elegooofficial/neptune3pro/PCBA/Limit Switch/X-axis limit Switch pcba.pdf

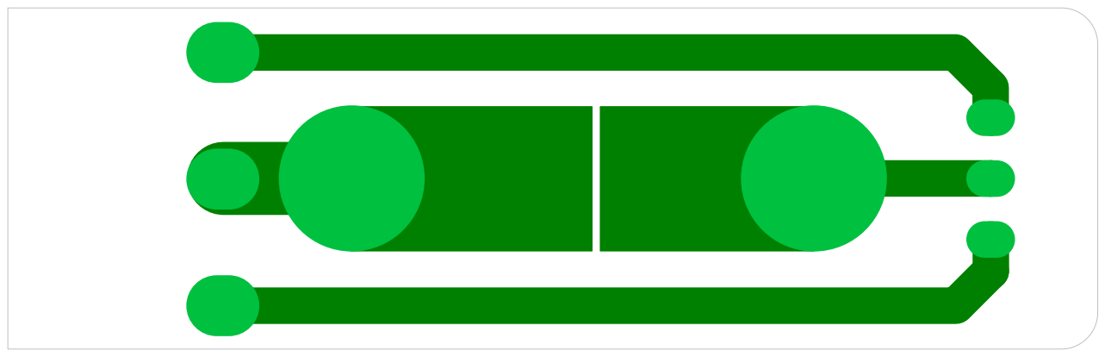
[picture p1: figure]
J1 @01@⁰¹x1 J1x1 J1x2 J1x3; @03@⁰³x1

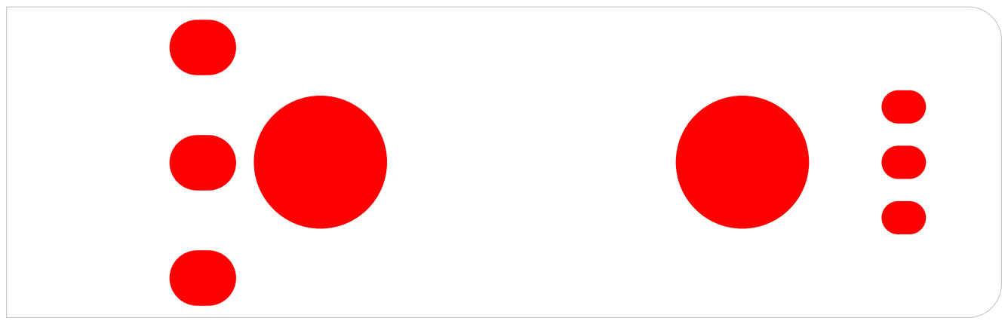
[picture p2: figure]
J1 @01@⁰¹x1 J1x1 J1x2 J1x3; @03@⁰³x1

J2

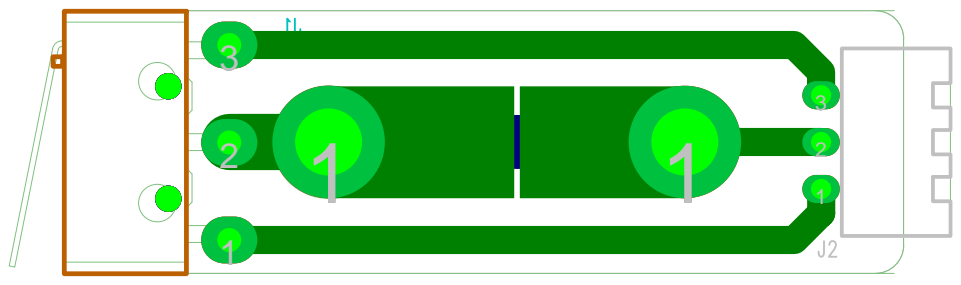
[picture p3: page 5]
J2 J1 @01@⁰¹x1 J1x1 J1x2 J1x3 J1x4 J1x5; @03@⁰³x1; J1 @01@⁰¹x1 J1x1 J1x2 J1x3 J1x4 J1x5
