elegooofficial/neptune3pro/BOM/Neptune 3 Pro bom.xlsx

Neptune 3 Pro Bom
Items | Part Code | Part Name | Specification | UNIT | Qty
1 | 01.001.0012 | 2020 Aluminum profile_X-axis | 20*20-L358mm,anodizing | pcs | 1
2 | 01.005.0001 | 2056 Aluminum profile_Y-axis | 20*56-L347mm,anodizing | pcs | 1
3 | 01.002.0006 | 2040 Aluminum profile_Right | 20*40-L430mm,anodizing+silk screen printing | pcs | 1
4 | 01.002.0007 | 2040 Aluminum profile_Left | 20*40-L430mm,Anodizing+silk screen printing | pcs | 1
5 | 01.003.0008 | 4040 Aluminum profile_Bottom & Right | 40*40-L320mm,Anodizing | pcs | 1
6 | 01.003.0009 | 4040 Aluminum profile_Bottom & Left | 40*40-L320mm,Anodizing | pcs | 1
7 | 01.003.0010 | 4040 Aluminum profile_Bottom | 40*40-L257mm,Anodizing | pcs | 1
8 | 02.002.0029 | Cover Plate_Bottom | 0.6mm, SPCC,Spraying,Black | pcs | 1
9 | 02.002.0030 | Attraction Plate_Magnet | 1.5mm,SECC | pcs | 1
10 | 02.002.0031 | Power Supply Cover_Left | 0.8mm,SPCC,Spraying,Black | pcs | 1
11 | 02.002.0032 | Power Supply Cover-Bottom | 0.8mm,SPCC,Spraying,Black | pcs | 1
12 | 02.002.0033 | Fixing Plate_Y-axis stepper | 2.5mm,SPCC,Spraying,Black | pcs | 1
13 | 02.002.0034 | Bottom Slider Plate | 4.0mm,Aluminum alloy plate,Spraying,Black | pcs | 1
14 | 02.002.0035 | Fixing Plate_Z nut-Left | 2.5mm,SPCC,Spraying,Black | pcs | 1
15 | 02.002.0036 | Fixing Plate_X-axis-stepper | 2.5mm,SPCC,Spraying,Black | pcs | 1
16 | 02.002.0037 | Fixing Plate_Z nut-Right | 2.5mm,SPCC,Spraying,Black | pcs | 1
17 | 02.002.0038 | Driven Plate_Z-axis | 2.5mm,SPCC,Spraying,Black | pcs | 1
18 | 02.002.0039 | Fixing Plate_Extruder | 2.5mm,SPCC,Spraying,Black | pcs | 1
19 | 02.002.0040 | Fixing Plate_Extruder Fan | 1.0mm,SPCC,Spraying,Black | pcs | 1
20 | 02.002.0041 | Fixing Plate_Top Bearing | 3.0mm,SPCC,Spraying,Black | pcs | 2
21 | 02.002.0042 | Fixing Plate_Filament Detector Switch | 0.8mm,SPCC,Spraying,Black | pcs | 1
22 | 02.002.0043 | Fixing Plate_Magnet | 0.8mm,SPCC,Spraying,Black | pcs | 1
23 | 02.002.0044 | Fixing Plate_Extruder Cable | 1.0mm,SPCC,Spraying,Black | pcs | 1
24 | 02.002.0045 | Power Supply Cover_Right | 0.8mm,SPCC,Spraying,Black | pcs | 1
25 | 04.001.0003 | Red Silicone Wire(Switch) | 16AWG_L90mm_4.8 Plug spring terminal | pcs | 1
26 | 04.001.0013 | Ground Wire_Power Supply | 18AWG_L90mm_SV1.25-4 terminal+4.8 Plug spring terminal | pcs | 1
27 | 04.001.0014 | Black Silicone Wire | 16AWG Silicone Wire_L90mm_SV1.25-4 terminal+4.8 Plug spring terminal,Black | pcs | 1
28 | 04.001.0015 | Red Silicone Wire | 16AWG Silicone Wire_L90mm_SV1.25-4 terminal+4.8 Plug spring terminal,Red | pcs | 1
29 | 04.002.0004 | Heated Bed Wire | 2*1.5㎡_2pin_L700mm,Red&Black | pcs | 1
30 | 04.003.0004 | Mainboard Wire | 16AWG_2Pin_L380mm_SV1.25-4 terminal+E1508 terminal,Red&Black | pcs | 1
31 | 04.005.0016 | Stepper and limit switch wire_Y-axis | 24AWG_6Pin,L1=650mm,L2=750mm,Black | pcs | 1
32 | 04.005.0017 | Stepper wire_Z-axis | 24AWG_2*4Pin,L1=430mm,L2=330mm,Black | pcs | 1
33 | 04.005.0018 | Stepper and limit switch wire_X-axis | 24AWG_6Pin,L1=960mm,L2=1020mm,Black | pcs | 1
34 | 04.001.0016 | Red DC Wire | 18AWG_L150mm_SV1.25-4 terminal,Red | pcs | 1
35 | 04.001.0017 | Black DC Wire | 18AWG_L150mm_SV1.25-4 terminal,Black | pcs | 1
36 | 04.014.0001 | Extruder Cable | 26AWG_20Pin,L=1430mm,Red&Black | pcs | 1
37 | 04.011.0009 | Fan Wire | 26AWG_2*2Pin terminal,L=60mm,Red&Black | pcs | 1
38 | 04.011.0010 | Filament Detector Wire | 26AWG_3Pin,L=550mm,Black | pcs | 1
39 | 04.011.0011 | LED Wire | 26AWG_2Pin,L=360mm,Black&Grey | pcs | 1
40 | 04.006.0007 | Filament Detector and LED Wire | UL1007 26AWG_5Pin，L1=620mm,L2=520mm,Black | pcs | 1
41 | 05.001.0066 | Plastic Bottom Box | Grey,ABS757，Fireproof materials_Fire rating V-0 | pcs | 1
42 | 05.001.0067 | Plastic Bottom Cover_Front | Grey,ABS757，Fireproof materials_Fire rating V-0 | pcs | 1
43 | 05.001.0068 | Display screen Shell_Top | Grey,ABS757 | pcs | 1
44 | 05.001.0069 | Display screen Shell_Bottom | Grey,ABS757 | pcs | 1
45 | 05.001.0070 | Display screen holder | Grey,ABS757 | pcs | 1
46 | 05.001.0071 | Stepper holder_Z-axis | Grey,ABS757 | pcs | 2
47 | 05.001.0072 | Limit switch pad_Y-axis | Grey,ABS757 | pcs | 1
48 | 05.001.0073 | Belt Adjust Shell_Y-axis | Grey,ABS757 | pcs | 1
49 | 05.001.0074 | limit switch holder_X-axis | Grey,ABS757 | pcs | 1
50 | 05.001.0075 | Belt Adjust Shell_X-axis | Grey,ABS757 | pcs | 1
51 | 05.001.0076 | Extruder Shell | Grey,PC,Fireproof materials_Fire rating V-0 | pcs | 1
52 | 05.001.0077 | Fan holder_Extruder | Grey,PC,Fireproof materials_Fire rating V-0 | pcs | 1
53 | 05.001.0078 | Extruder Handle | Grey,PC,Fireproof materials_Fire rating V-0 | pcs | 1
54 | 05.001.0080 | Gearbox_Bottom | Grey,PC,Fireproof materials_Fire rating V-0 | pcs | 1
55 | 05.001.0081 | Gearbox_Top | Grey,PC,Fireproof materials_Fire rating V-0 | pcs | 1
56 | 05.001.0082 | Cable Snap | Grey,ABS757 | pcs | 1
57 | 05.001.0083 | Beam_Top | Grey,ABS757 | pcs | 1
58 | 05.001.0084 | Filament holder | Grey,ABS757 | pcs | 1
59 | 05.001.0085 | Filament Detector Shell_Top | Grey,ABS757 | pcs | 1
60 | 05.001.0086 | Filament Detector Shell_Bottom | Grey,ABS757 | pcs | 1
61 | 05.001.0087 | Bearing holder_Filament Detector | Grey,ABS757 | pcs | 1
62 | 03.001.0005 | Decelerate Gear | Black POM+45# steel | pcs | 1
63 | 05.001.0088 | Heated Bed Wire holder | Grey,PC,Fireproof materials_Fire rating V-0 | pcs | 1
64 | 05.001.0089 | Filament Detector holder | Grey,ABS757 | pcs | 1
65 | 05.001.0090 | Belt Adjust Bearing holder | Grey,ABS757 | pcs | 2
66 | 05.001.0091 | Belt Adjust nut-D20 | Grey,ABS757 | pcs | 2
67 | 05.001.0092 | Filament Tube | Grey,ABS757 | pcs | 1
68 | 05.001.0093 | Cover_4040 Aluminum profile | Grey,ABS757 | pcs | 2
69 | 05.001.0020 | Silicone Cover_Heating Block | Silicone,Black | pcs | 1
70 | 08.001.0016 | Mainboard | ZNP Robin Nano_DW V2.2 | PCS | 1
71 | 19.005.0009 | Mainboard | ZNP Robin Nano_DW V2.2（IC: STM32F401RCT6） | SET | 1
72 | 19.005.0010 | Mainboard | ZNP Robin Nano_DW V2.2（IC: STM32F401RRT6） | SET | 1
73 | 19.005.0011 | Mainboard | ZNP Robin Nano_DW V2.2（IC: STM32F402RCT6） | SET | 1
74 | 08.002.0006 | Display Screen | 4.3inch Capacitive touch Display screen | pcs | 1
75 | 04.011.0012 | RJ11 Wire | RJ11 Spring Wire,1.5m,Single core:7x0.08,Black | pcs | 1
76 | 04.011.0013 | Display Screen Wire_Inside | RJ11,4P4C,4Pin XH2.54 Plug | pcs | 1
77 | 07.003.0004 | limit switch _X-axis | limit switch,14x45x1.6mm,Red | SET | 1
78 | 07.003.0017 | DC Socket | DC022B，φ5.5*φ2.5mm | pcs | 1
79 | 07.003.0021 | limit switch _Y-axis | limit switch,20x20x1.6mm,Red | pcs | 1
80 | 08.006.0003 | Filament Detector Sensor | H22B1 PCBA module | pcs | 1
81 | 08.001.0017 | Extruder PCBA | EL-A-V2.1.1.400,42x41x1.6mm Fiber glass board,Red | PCS | 1
82 | 07.002.0004 | Stepper_X-axis&Y-axis | Model:42HD2037-02,Two-phase,34mm,Black | PCS | 2
83 | 07.002.0005 | Stepper_Z-axis | Model:42HD2037-04,Two-phase,34mm,Black | PCS | 2
84 | 07.002.0008 | Stepper_Extruder | Model:42HD1418-01,Two-phase,25mm | PCS | 1
85 | 07.001.0001 | Power Supply | 360W,24V 15A H:50mm,Black | PCS | 1
86 | 07.003.0019 | Combination Switch | Three-in-one combination switch | pcs | 1
87 | 08.003.0001 | Power Fuse | 10A 250V 5*20 | pcs | 1
88 | 07.004.0001 | Heated Bed Platform | 24V，235*235mm，250W | pcs | 1
89 | 07.007.0004 | Heating Tube | 24V，40W,Φ6*20,L70mm 2Pin XH2.54 Plug | pcs | 1
90 | 07.005.0009 | 6010 Fan | 6010 Fan,24V,3000r/min | pcs | 1
91 | 07.005.0010 | 4010 Turbo Fan | 4010 Turbo Fan,24V,7000r/min | pcs | 2
92 | 07.005.0011 | 4015 Turbo Fan | 4015 Turbo Fan,24V,7000r/min | pcs | 1
93 | 07.003.0020 | Level Sensor | Model:NPN N3F-H4NB Inductive proximity Sensor | pcs | 1
94 | 07.006.0007 | Thermistor_Nozzle | NTC100K D1.8-L100mm,2Pin XH2.0 terminal | pcs | 1
95 | 07.006.0008 | Thermistor_Heated Bed | NTC100K D1.8-L1100mm,2Pin XH2.54 terminal | pcs | 1
96 | 06.009.0026 | LED PCBA | AL base board,15*178mm,24V 0.5W,1.6MM | pcs | 1
97 | 03.002.0002 | Heated Blcok | AL6061,20*20*10mm， | pcs | 1
98 | 03.003.0005 | Heat Dissipation Block | AL6061,42*20.5*20.5mm | pcs | 1
99 | 03.004.0001 | Nozzle | Brass M6，0.4mm | pcs | 3
100 | 03.005.0003 | Throat Tube | Ti alloy,CT4，D7-M6-L27mm | pcs | 1
101 | 20.001.0001 | V-slot Wheel kit | 1*Black POM Wheel+2*625ZZBearing+1*M5 Flat Washer_V-slot Wheel | pcs | 14
102 | 03.006.0001 | Metal Eccentric Spacer | D7.2-d5-H-8.35mm,Hexagon | pcs | 6
103 | 03.006.0002 | Metal Spacer | D8-d5-H-8.35mm,Circular | pcs | 14
104 | 03.001.0002 | Extrusion Gear 1 | SUS304,0.5M,17T,13.8*9.3mm,M3 threaded hole | pcs | 1
105 | 03.001.0003 | Extrusion Gear 2 | SUS304,0.5M,17T,13.8*9.3mm | pcs | 1
106 | 03.001.0004 | Extruder Stepper Gear | Brass,0.5M,17T,H4.5mm | pcs | 1
107 | 06.008.0001 | Axis_Detector Bearing_L10 | SUS304,φ3,L10mm | pcs | 1
108 | 06.008.0002 | Axis_Extrusion Gear_L19 | SUS304,φ3,L19mm | pcs | 1
109 | 06.008.0003 | Axis_Extrusion Gear holder_L27 | SUS304,φ3,L27mm | pcs | 1
110 | 06.004.0010 | Spring_Extrusion | φ1.0mm*φ8mm*L20mm | pcs | 1
111 | 06.004.0009 | Spring_Filament Detector | φ0.4mm*φ6mm*L15mm | pcs | 1
112 | 06.001.0009 | MR85zz Bearing | MR85zz | pcs | 2
113 | 06.001.0004 | Needle Bearing | OD:5.0mm,ID:3,0mm,H:7mm SUS Needle | pcs | 2
114 | 06.001.0010 | MF148zz Flange Bearing | MF148zz | pcs | 2
115 | 06.001.0002 | F624zz Bearing | F624zz | pcs | 4
116 | 06.001.0007 | 624zz V Bearing | 624 V | pcs | 1
117 | 06.001.0011 | MR93ZZ Bearing | MR93ZZ | pcs | 1
118 | 06.003.0007 | Lead screws_T8 | T8-8_L394mm | pcs | 2
119 | 06.003.0002 | Lead screws nut_T8 | T8-8 | pcs | 2
120 | 06.007.0001 | Rigid Coupling | D5mm*8mm | pcs | 2
121 | 06.006.0001 | Timing Pulley_ID 5 | 2GT_d5mm_20teeth_W6mm,Black | pcs | 2
122 | 06.006.0002 | Timing Pulley_ID 8 | 2GT_d8mm_20teeth_W6mm,Black | pcs | 2
123 | 05.002.0001 | 2GT Timing Belt_Open | 2GT-W6 X-axis-L790mm,Y-axis-L750mm,Black,100m/roll | m | 1.528
124 | 05.002.0003 | 2GT Timing Belt_Close | 2GT-W6 PL634mm | pcs | 1
125 | 06.009.0002 | Copper Sleeve_Timing Belt | D7mm_0.5mm | pcs | 4
126 | 03.006.0005 | Heated Bed Spacer | Material:SUS304,OD:7.0mm,ID:6.0mm,H:13.5mm | pcs | 4
127 | 10.008.0003 | PEI Platform Sticker | PEIspray,235mm*245mm | pcs | 1
128 | 10.008.0013 | Soft Magnetic Platform | 235mm*235mm*1.5mm,Adhesive backing,Black | pcs | 1
129 | 06.009.0027 | Display Screen Magnet | NdFeB strong magnet,50*30*4mm,2000GS | pcs | 1
130 | 11.008.0003 | PET Plastic Sheet | Material:PET,37.5*64mm,Thickness:0.2mm,Adhesive backing,Black | pcs | 1
131 | 10.005.0004 | Rubber Mat | Material:rubber,38*20*20mm,Black | pcs | 4
132 | 05.007.0006 | PTFE Tube | Material:PTFE,OD4.0mm,ID2.0mm,L54mm,Light blue | m | 0.108
133 | 10.008.0015 | Fixing Clamp_Extruder Cable | Model:UC-2,ID:10.4mm,Black | pcs | 1
134 | 05.008.0001 | Cable Tie holder | Model:STM-1S,Black,W6.9-L12.6mm | pcs | 1
135 | 05.001.0094 | Wire Protective Ring | Model:SB20,Protective Ring,Black | pcs | 1
136 | 11.008.0004 | Cover Strip_Aluminum profile | W6-L360mm,Black | pcs | 1
137 | 10.001.0001 | Nylon braided sleeve_W8 | W8-L410mm | pcs | 1
138 | 10.001.0012 | Nylon braided sleeve_W16 | W16-L600mm | pcs | 2
139 | 11.003.0001 | Insulation Cotton | Insulation Cotton,50*60mm | pcs | 1
140 | 10.007.0004 | Cable Tie 4-150 | Nylon,Black_4-150mm | pcs | 9
141 | 10.007.0002 | Fixed Head Cable Tie 3-100 | Nylon,Black_3-100mm | pcs | 5
142 | 11.002.0002 | High Temperature Tape | W50mm，33m | m | 0.14
143 | 11.001.0001 | High Temp Resistant Thread Sealant | High Temp Resistant Thread Sealant | g | 0.5
144 | 11.004.0001 | Grease | Transparent_Paste | g | 2
145 | 11.004.0002 | Thermal Grease | Grey | g | 0.2
146 | 11.006.0001 | Solder Wire | φ2mm ,500g/roll,lead free | g | 0.5
147 | 11.002.0005 | Acetate Cloth Tape | W40mm，30m,Black,Acetate Cloth Tape | m | 0.2
148 | 11.002.0004 | Packing Tape | W50mm，100m | m | 0.5
149 | 11.009.0001 | Heat Shrinkable Tube | φ2.5mm*20mm，ID:3.0mm，Black | pcs | 2
150 | 11.007.0001 | Hot-melt |  | pcs | 0.05
151 | 11.008.0007 | Electronic glue | Model:FST5980 RTV silica gel,Black,100ml/piece | ml | 1
152 | 11.001.0002 | 480 Quick-drying Adhesive | Model:480,Quick-drying Adhesive,Black,20g/piece | g | 0.4
153 | 10.004.0001 | TF Memory Card | 8G | pcs | 1
154 | 10.004.0002 | TF Memory Card Reader | CHUANYU（Common） | pcs | 1
155 | 04.008.0001 | Power Supply Wire | Length:1.5M_Wire diameter:6.5mm_Rated power:2500W_Rated voltage:250V_Pure copper_3*0.75mm²_Plug:nickel-plated brass_Flame-Retardant PVC | pcs | 1
156 | 04.009.0001 | USB Cable | Bluish transparent_Type-A to Type-B_Length:53cm_Wire diameter:4.8mm | pcs | 1
157 | 10.008.0012 | Needle | Stainless Steel_L70mm_d0.35mm | pcs | 1
158 | 10.002.0015 | Plastic Scraper | Material:PP,Plastic Scraper,yellow | pcs | 1
159 | 10.002.0002 | Nippers | Cutting Nippers | pcs | 1
160 | 10.002.0003 | 1.5mm Inner Hexagon Spanner | Carbon Steel_1.5mm_Nickel-plated | pcs | 1
161 | 10.002.0004 | 2.0mm Inner Hexagon Spanner | Carbon Steel_2.0mm_Nickel-plated | pcs | 1
162 | 10.002.0005 | 2.5mm Inner Hexagon Spanner | Carbon Steel_2.5mm_Nickel-plated | pcs | 1
163 | 10.002.0006 | 3.0mm Inner Hexagon Spanner | Carbon Steel_3.0mm_Nickel-plated | pcs | 1
164 | 10.002.0007 | 4.0mm Inner Hexagon Spanner | Carbon Steel_4.0mm_Nickel-plated | pcs | 1
165 | 10.002.0008 | Flat Blade screwdriver | 2.5mm_Flat Blade | pcs | 1
166 | 10.002.0009 | Cruciform screwdriver | 4.0mm_ Cruciform | pcs | 1
167 | 10.002.0010 | Double Open Spanner | 45#steel_8-10#_Galvanized | pcs | 1
168 | 10.002.0011 | Open Spanner | 45#steel_6#_Galvanized | pcs | 1
169 | 12.002.0001 | Self Sealing Bag Ⅰ | 18cm*26cm_Thickness:0.06mm | pcs | 1
170 | 12.002.0003 | Self Sealing Bag Ⅱ | 9cm*13cm_Thickness:0.08mm | pcs | 3
171 | 12.002.0004 | Self Sealing Bag Ⅲ | 6cm*9cm_Thickness:0.08mm | pcs | 4
172 | 13.001.0001 | Filament | L5m_Random color | pcs | 1
173 | 10.003.0001 | Product Certificate | Triangle | pcs | 1
174 | 12.003.0024 | Neptune 3 Pro Foam |  | pcs | 1
175 | 12.001.0025 | Neptune 3 Pro Carton |  | pcs | 1
176 | 10.003.0018 | Neptune 3 Pro Manufacturing Number Sticker | 210*120mm | pcs | 1
177 | 12.004.0015 | Neptune 3 Pro Machine Specification Sticker | 70*38mm | pcs | 1
178 | 10.007.0003 | Plastic Twist Tie | White_Plastic Twist Tie_0.55mm*80mm | pcs | 1
179 | 10.003.0019 | Neptune 3 Pro User Guide | 128G_Coated Paper,4color printing | pcs | 1
180 | 12.005.0016 | Display Screen Warning label | 49*26mm,80G_Coated Paper | pcs | 1
181 | 12.005.0018 | Stepper Warning label | 14*13mm,Triangle,80G_Coated Paper | pcs | 2
182 | 12.005.0019 | DC Socket label | 30*8mm | pcs | 1
183 | 11.001.0004 | Solid gule-PVP | Material:PVP, high viscosity, formaldehyde free, 20g/piece | pcs | 1
184 | 09.009.0005 | Cruciform Socket Button Head screw_PWM M2*10 | Carbon Steel_PWM M2x10 | pcs | 3
185 | 09.003.0017 | Hexagon Socket Head Cap screw_ M2*10 | Stainless Steel_M2*10 | pcs | 2
186 | 09.006.0011 | Cruciform Socket Button Head Tapping screws_Point Tail/PA 2x6 | Carbon Steel/PA 2*6 | pcs | 6
187 | 09.006.0003 | Cruciform Socket Button Head Tapping screws_Point Tail_PA3x8 | Carbon Steel/PA 3*8 | pcs | 21
188 | 09.006.0002 | Cruciform Socket Button Head Tapping screws_Point Tail/PA 3*12 | Stainless Steel/PA 3*12 | pcs | 3
189 | 09.006.0012 | Cruciform Socket Button Head Tapping screws_Flat tail/KT 5x10 | Carbon Steel/KT 5*10 | pcs | 4
190 | 09.007.0001 | Combination screw_M3x4 | Stainless Steel_M3X4 | pcs | 1
191 | 09.002.0016 | Hexagon Socket Button Head screw_M3x4 | Stainless Steel_M3*4 | pcs | 6
192 | 09.002.0001 | Hexagon Socket Button Head screw_M3x6 | Stainless Steel_M3*6 | pcs | 18
193 | 09.002.0012 | Hexagon Socket Button Head screw_M3x8 | Stainless Steel_M3*8 | pcs | 3
194 | 09.002.0004 | Hexagon Socket Button Head screw_M3x10 | Stainless Steel_M3*10 | pcs | 2
195 | 09.002.0009 | Hexagon Socket Button Head screw_M3x12 | Stainless Steel_M3*12 | pcs | 14
196 | 09.002.0002 | Hexagon Socket Button Head screw_M3x16 | Stainless Steel_M3*16 | pcs | 6
197 | 09.003.0013 | Hexagon Socket Head Cap screw_M3x20 | Stainless Steel_M3*20 | pcs | 2
198 | 09.002.0022 | Hexagon Socket Button Head screw_M3x30 | Stainless Steel_M3*30 | pcs | 1
199 | 09.002.0014 | Hexagon Socket Button Head screw_M4x5 | Stainless Steel_M4*5 | pcs | 5
200 | 09.002.0018 | Hexagon Socket Button Head screw_M4x8 | Stainless Steel_M4*8 | pcs | 1
201 | 09.002.0007 | Hexagon Socket Button Head screw_M4x16 | Stainless Steel_M4*16 | pcs | 6
202 | 09.007.0002 | Hexagon Socket Button Head screw_M4x18 | Carbon Steel_M4X18 | pcs | 4
203 | 09.002.0020 | Hexagon Socket Button Head screw_M4x20 | Stainless Steel_M4*20 | pcs | 5
204 | 09.002.0021 | Hexagon Socket Button Head screw_M5X10 | Stainless Steel_M5X10 | pcs | 6
205 | 09.002.0003 | Hexagon Socket Button Head screw_M5X30 | Stainless Steel_M5X30 | pcs | 8
206 | 09.002.0005 | Hexagon Socket Button Head screw_M5X40 | Stainless Steel_M5X40 | pcs | 6
207 | 09.002.0023 | Hexagon Socket Button Head Combination screw_M4x20 | Stainless Steel_M4*20 | pcs | 8
208 | 09.007.0007 | Hexagon Socket Head Cap screw_M4x40 | Carbon Steel_M4*40 | pcs | 2
209 | 09.007.0004 | Hexagon Socket Head Cap screw_M5X45 | Carbon Steel_M5X45 | pcs | 12
210 | 09.007.0006 | Hexagon Socket Head Cap screw_M5X50 | Carbon Steel_M5X50 | pcs | 2
211 | 09.003.0016 | Hexagon Socket Head Cap screw Step screw_4x3xM3 | Stainless Steel_4*3*M3 | pcs | 1
212 | 09.001.0011 | Hexagon Socket Countersunk Head screw_M3x6 | Stainless Steel_M3*6 | pcs | 7
213 | 09.001.0002 | Hexagon Socket Countersunk Head screw_M3x10 | Stainless Steel_M3*10 | pcs | 1
214 | 09.001.0014 | Hexagon Socket Countersunk Head screw_M3x35 | Stainless Steel_M3*35 | pcs | 3
215 | 09.001.0015 | Hexagon Socket Countersunk Head screw_M4x20 | Stainless Steel_M4*20 | pcs | 8
216 | 09.003.0015 | Hexagon Socket Head Cap screw_Thin head_M4x12 | Stainless Steel_M4*12 | pcs | 1
217 | 09.011.0008 | Hexagon Socket Button Head screw_Thin head_M5x30 | Stainless Steel_M5*30 | pcs | 4
218 | 09.008.0001 | Set screw_M3x3 | Carbon Steel_M3*3 | pcs | 2
219 | 09.004.0002 | Spring Washer_M3 | Stainless Steel_M3 | pcs | 4
220 | 09.004.0003 | Flat Washer_M5 | Stainless Steel_M5 | pcs | 6
221 | 09.008.0008 | Butt nut_M4x16 | Stainless Steel_M4*16 | pcs | 2
222 | 09.008.0010 | Butt screw_M4 | Stainless Steel_M4 | pcs | 2
223 | 09.005.0012 | Self-locking nut_M3 | Stainless Steel_M3 | pcs | 4
224 | 09.005.0013 | Square nut_M4 | Carbon Steel_M4 | pcs | 1
225 | 09.005.0002 | Self-locking nut_M5 | Stainless Steel_M5 | pcs | 14
