elegooofficial/neptune3pro/PCBA/Extruder PCBA/Extruder bom.xls

Itens | Part name | Packag description | Qty | Bit number
1 | Connector | PH2.0X4-PW，90 degree connector，Fireproof material | 1 | E1
2 | Connector | PH2.0-PW，90 degree connector，Fireproof material | 5 | FAN1 K-FAN1 K-FAN2 LED TH1
3 | Connector | XH-2.54W_2PW，90 degree connector，Fireproof material | 1 | HEAT0
4 | Connector | CON2.0X2X10W Sagittarius，90 degree connector，Fireproof material | 1 | J2
5 | Connector | PH2.0X3-PW，90 degree connector，Fireproof material | 1 | LIMIT1
6 | SMD resistor | 0603_100R_accuracy 1% | 2 | R1 R3
7 | pcb | 42*41mm，FR-4，two-layer board，FR4_1.6mm，red Soldermask and white silkscreen ， HAL lead free technology ，Through hole and oil，Thickness of copper sheet:1oz，version：EL-A-V2.1.1.400 | 1
