elegooofficial/neptune3pro/(list of files, cad)

Other CAD files:
Wire/Mainboard Wire.dwg
2D/4040 Aluminum profile_Bottom.DWG
Wire/stepper and limit switch wire_Y-axis.dwg
2D/Bottom Slider Plate.DWG
Wire/4015 Turbo Fan.dwg
2D/Power Supply Cover_Right.DWG
Wire/Thermistor_Heated Bed.dwg
2D/Heat Dissipation Block.DWG
Wire/Thermistor_Nozzle.dwg
2D/Extrusion Gear 1.DWG
Wire/Display Screen Wire_Inside.dwg
Wire/Black DC Wire.dwg
2D/2040 Aluminum profile_Right.DWG
Wire/Filament Detector and LED Wire.dwg
2D/Fixing Plate_Extruder.DWG
Wire/Stepper wire_Z-axis.dwg
2D/Cover Plate_Bottom.DWG
Wire/4010 Turbo Fan.dwg
2D/4040 Aluminum profile_Bottom & Right.DWG
Wire/Ground Wire_Power Supply.dwg
2D/Attraction Plate_Magnet.DWG
Wire/LED Wire.dwg
2D/4040 Aluminum profile_Bottom & Left.DWG
Wire/Stepper and limit switch wire_X-axis.dwg
2D/Fixing Plate_Extruder Cable.DWG
Wire/Red Silicone Wire(Switch).dwg
2D/2056 Aluminum profile_Y-axis.DWG
Wire/Red Silicone Wire.dwg
2D/Driven Plate_Z-axis.DWG
Wire/Fan Wire.dwg
2D/Fixing Plate_Extruder Fan.DWG
Wire/Red DC Wire.dwg
2D/Power Supply Cover-Bottom.DWG
2D/Power Supply Cover_Left.DWG
Wire/Heating Tube.dwg
2D/Fixing Plate_Y-axis stepper.DWG
Wire/Level Sensor.dwg
2D/2040 Aluminum profile_Left.DWG
Wire/Heated Bed Wire.dwg
2D/Fixing Plate_Filament Detector Switch.DWG
Wire/Extruder Cable.dwg
2D/Fixing Plate_Magnet.DWG
Wire/6010 Fan.dwg
2D/Extrusion Gear 2.DWG
Wire/Black Silicone Wire.dwg
Wire/Filament Detector Wire.dwg
2D/2020 Aluminum profile_X-axis.DWG
2D/Fixing Plate_Top Bearing.DWG
2D/Fixing Plate_X-axis-stepper.DWG
2D/Heated Blcok.DWG
2D/Fixing Plate_Z nut-Left.DWG
2D/Fixing Plate_Z nut-Right.DWG
