elegooofficial/neptune3pro/(threads)

Thread 1 (2023-01-15):

Neptune 3 CAD

mlee12382, 2023-01-15:
Hello is it possible to get all the source materials and CAD files for the base Neptune 3?

ama564, 2024-04-26:
and for max?

Thread 2 (2023-01-24):

What connector is on the thermistor?

kozross, 2023-01-24:
I'm a bit unclear what connector is used to connect the thermistor to the toolhead PCB: the BOM for the printer and the toolhead PCB seem to disagree on this. Could you please clarify?

Tweako, 2023-04-20:
It's listed in the wire diagram.
https://github.com/elegooofficial/neptune3pro/blob/main/Wire/Thermistor_Nozzle.pdf

kozross, 2023-04-20:
@Tweako - thanks!

Closed 2023-04-20.

Thread 3 (2023-01-25):

No information about the toolhead housing or the motors being used

kozross, 2023-01-25:
The BOM doesn't specify what motors are used by the Neptune 3 Pro, and the `2D` folder doesn't contain any CAD sketches for the toolhead housing, only the X carriage and some small parts connected to it.

Thread 6 (2023-07-05):

unstable PWM operation

ShultsAlexey, 2023-07-05:
Hi
I connected the laser according to the instructions: https://marlinfw.org/docs/configuration/2.0.9/laser_spindle.html#laser/spindle-configuration-(2.0.9.x)
Using M106/M107 commands
...BUT THE LASER FLASHES.
here is an example of work: https://www.youtube.com/shorts/_b1xg4CLyhA

I tried to connect to the PWM generator, everything is fine.

What could be the problem?

Thread 7 (2023-10-25):

Comments ignored when input through USB

gbarbehenn, 2023-10-25:
Create a file that includes a thumbnail.  If the file is printed via the SD card, the thumbprint is displayed.  If the same file is sent to the printer via USB, the thumbprint is ignored.   I used the attached file.
[EN3PRO_Base and clamp bottoms.zip](https://github.com/elegooofficial/neptune3pro/files/13170208/EN3PRO_Base.and.clamp.bottoms.zip)

Thread 8 (2023-10-25):

Information displayed while printing is very limited.

gbarbehenn, 2023-10-25:
More enhancement than bug.  The printer only displays very limited information while printing - hotend and bed temperatures.  Fixing the lack of display of thumbprints, when using USB communication, will go most of the way to fixing this.  But, it would be useful to display elapsed printing time and current Z value.
The attached file has the total printing time (as a comment) and maximum Z-axis value (also as a comment).  Ideally, the printer would show elapsed_printing_time vs. total_printing_time (as rescued from comments), and current_Z_value vs maximum_Z_value (also rescued from the comments)
[EN3PRO_Base and clamp bottoms.zip](https://github.com/elegooofficial/neptune3pro/files/13170287/EN3PRO_Base.and.clamp.bottoms.zip)
