elegooofficial/neptune3pro/2D/2040 Aluminum profile_Left.pdf

4

1 | 2 | 3

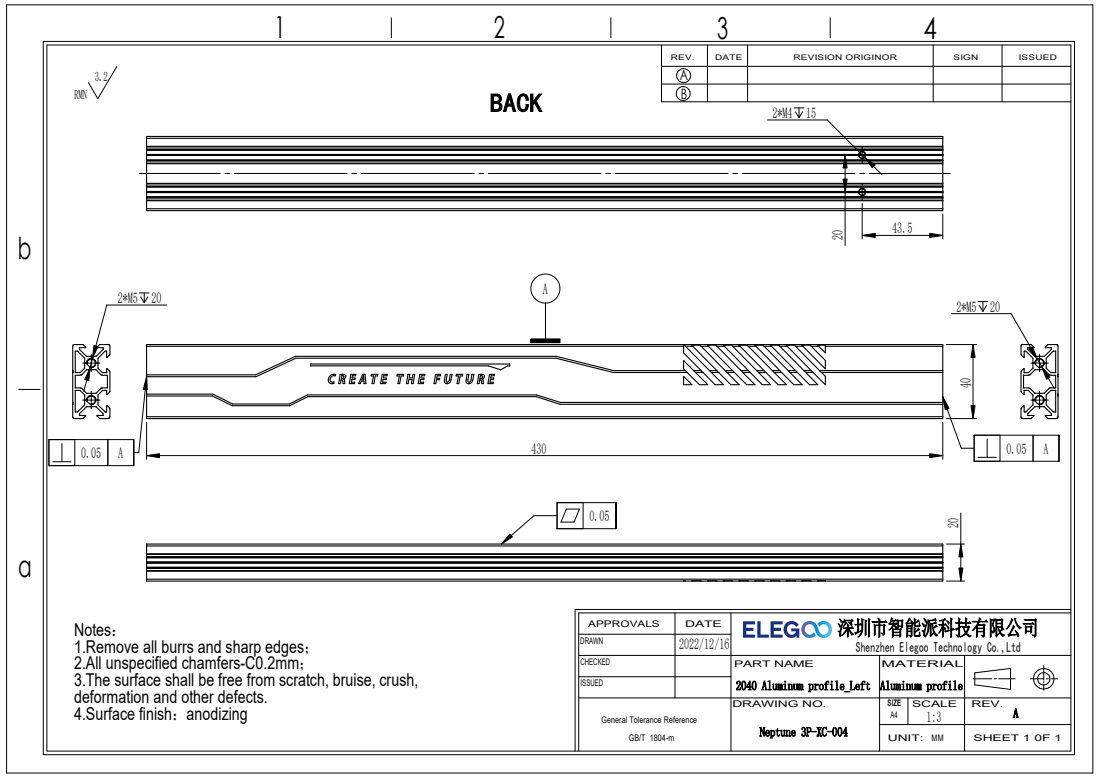
[picture p5: page 1]
4.Surface finish：anodizing; RMN; 40 SHEET 1 0F 1; BACK

REV. | DATE | REVISION ORIGINOR | SIGN | ISSUED

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

APPROVALS | DATE | 深圳市智能派科技有限公司 Shenzhen Elegoo Technology Co.,Ltd
DRAWN | 2022/12/16
CHECKED | | PART NAME 2040 Aluminum profile_Left | MATERIAL Aluminum profile
ISSUED
General Tolerance Reference GB/T 1804-m | DRAWING NO. Neptune 3P-XC-004 | SIZE A4 | SCALE 1:3 | REV.

UNIT: MM
