elegooofficial/neptune3pro/2D/2040 Aluminum profile_Right.pdf

4

1 | 2 | 3

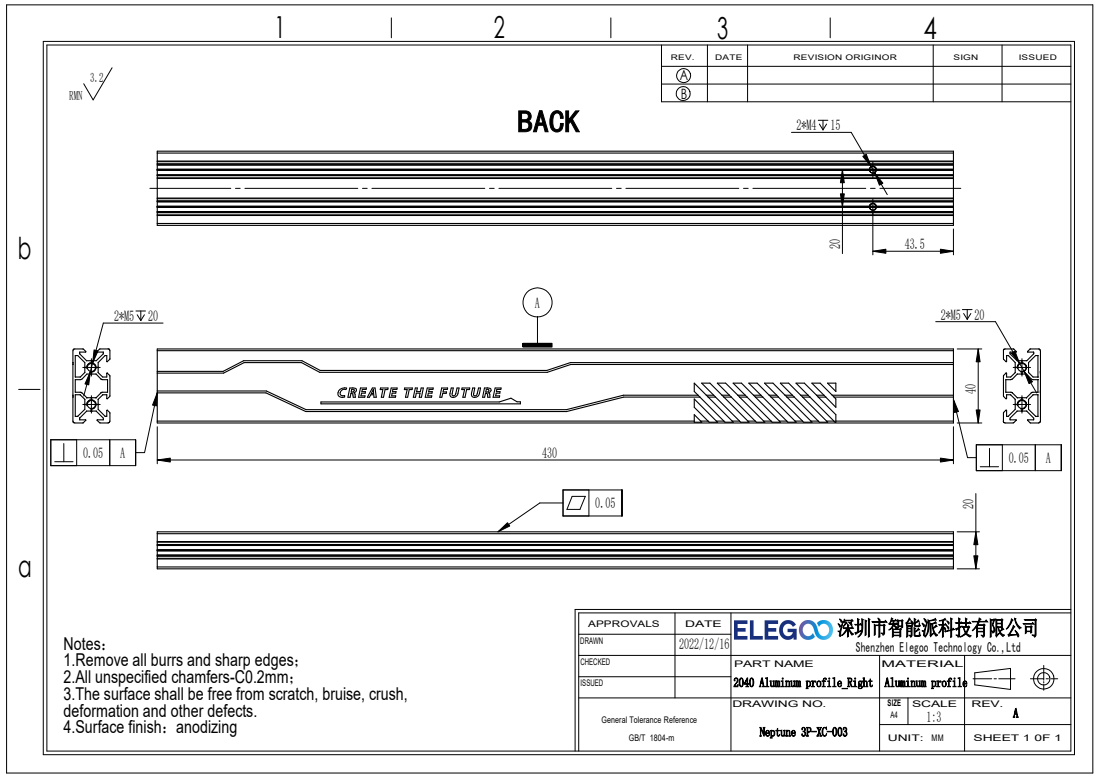
[picture p6: page 1]
Aluminum profile; RMN; BACK

REV. | DATE | REVISION ORIGINOR | SIGN | ISSUED

APPROVALS | DATE | 深圳市智能派科技有限公司 Shenzhen Elegoo Technology Co.,Ltd
DRAWN | 2022/12/16
CHECKED | | PART NAME 2040 Aluminum profile_Right | MATERIAL
ISSUED
General Tolerance Reference GB/T 1804-m | DRAWING NO. Neptune 3P-XC-003 | SIZE A4 | SCALE 1:3 | REV. A

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

UNIT: MM | | SHEET 1 0F 1
