elegooofficial/neptune3pro/2D/Driven Plate_Z-axis.pdf

4

1 | 2 | 3

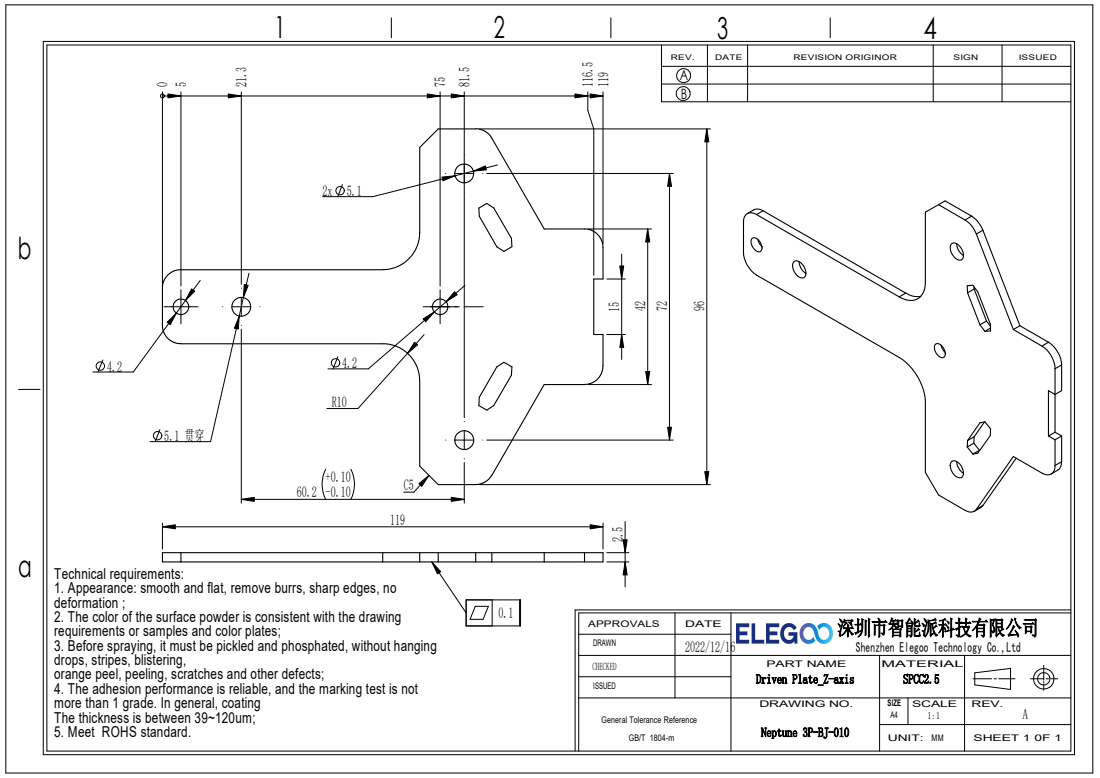
[picture p9: page 1]
5. Meet ROHS standard.; Neptune 3P-BJ-010

REV. | DATE | REVISION ORIGINOR | SIGN | ISSUED

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

APPROVALS | DATE | 深圳市智能派科技有限公司 Shenzhen Elegoo Technology Co.,Ltd
DRAWN | 2022/12/16
CHECKED | | PART NAME Driven Plate_Z-axis | MATERIAL SPCC2.5
ISSUED
General Tolerance Reference GB/T 1804-m | DRAWING NO. | SIZE A4 | SCALE 1:1 | REV. A

UNIT: MM | | SHEET 1 0F 1
