elegooofficial/neptune3pro/PCBA/Limit Switch/Y-axis limit switch SCH.pdf

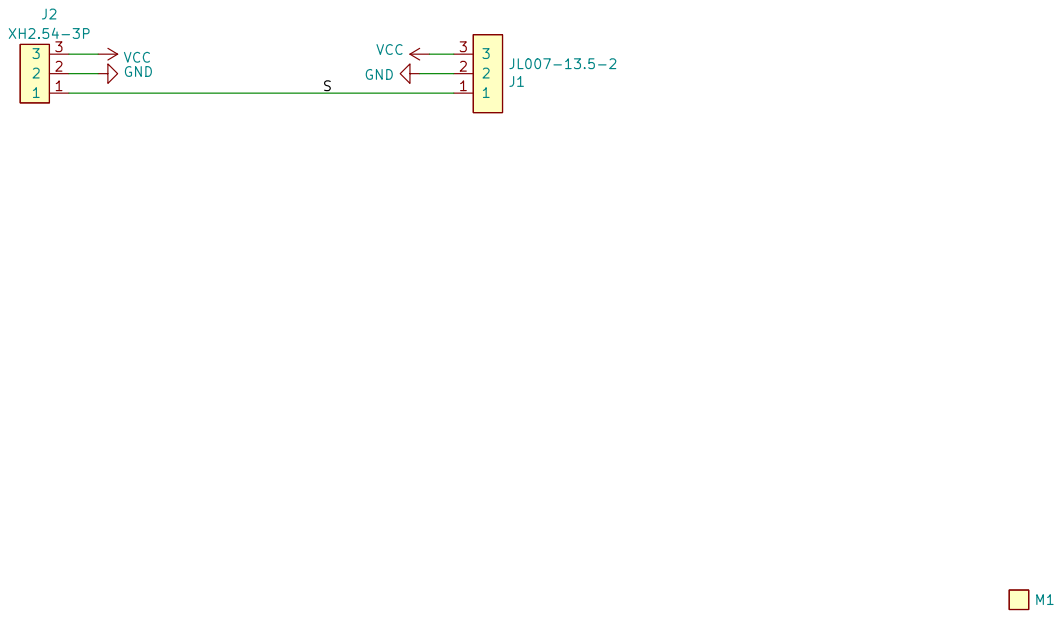
[picture p12: page 1]

Id: 1/1 Title: File: Limit Switch.sch Sheet: /
