elegooofficial/neptune3pro/PCBA/Mainboard/ZNP Robin Nano_DW V2.2_001 PCB/ZNP Robin Nano-B_SilkS.pdf

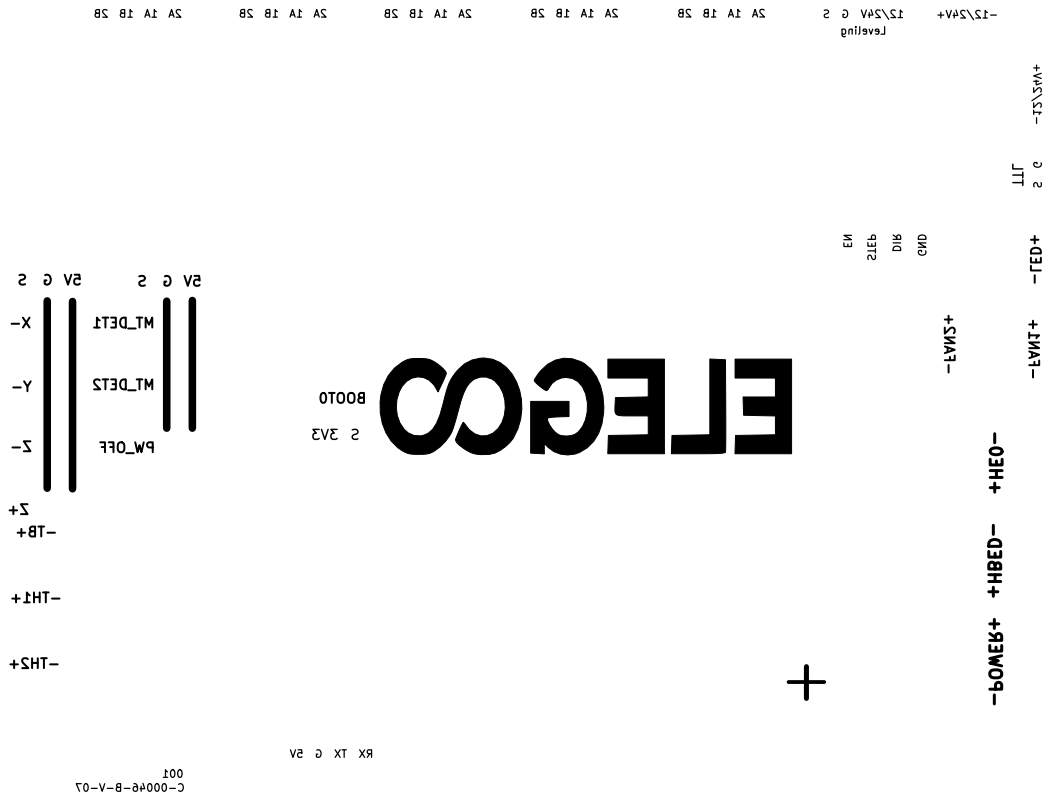
[picture p13: page 1]

-TH2+ EN STEP DIR GND
