elegooofficial/neptune3pro/PCBA/Mainboard/ZNP Robin Nano_DW V2.2_001 PCB/ZNP Robin Nano-F_SilkS.pdf

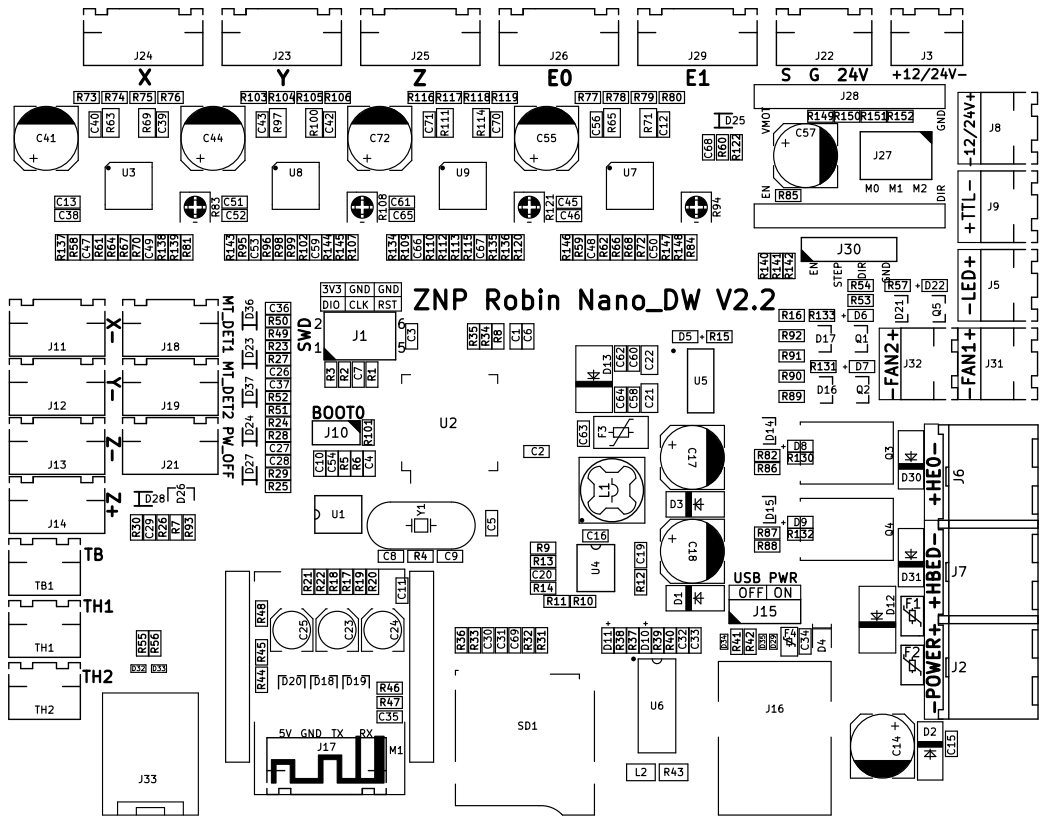
[picture p14: page 1]

3V3 | GND | GND
DIO | CLK | RST
