elegooofficial/neptune3pro/Wire/4010 Turbo Fan.pdf

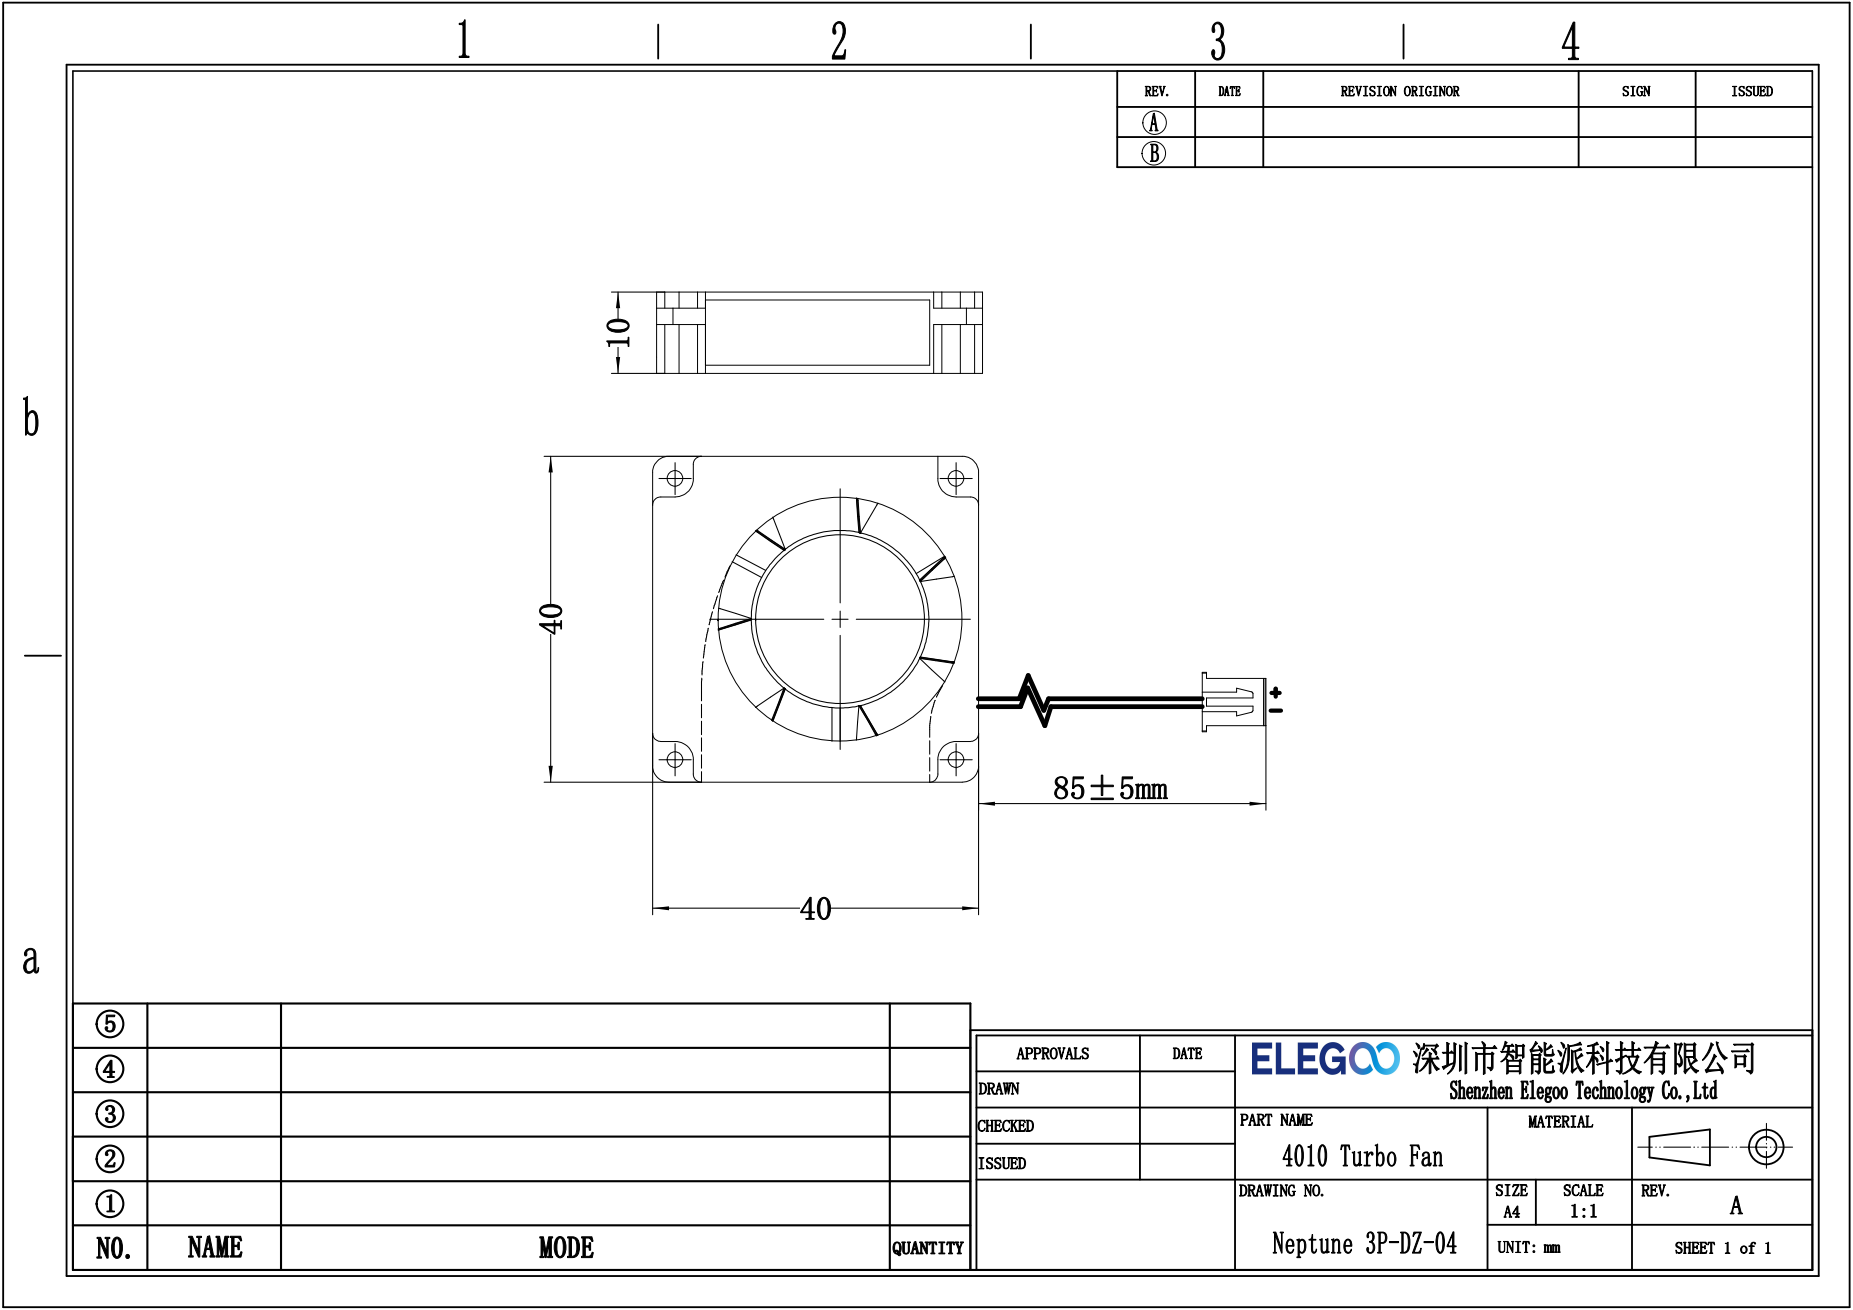
[picture p15: page 1]
