elegooofficial/neptune3pro/Wire/4015 Turbo Fan.pdf

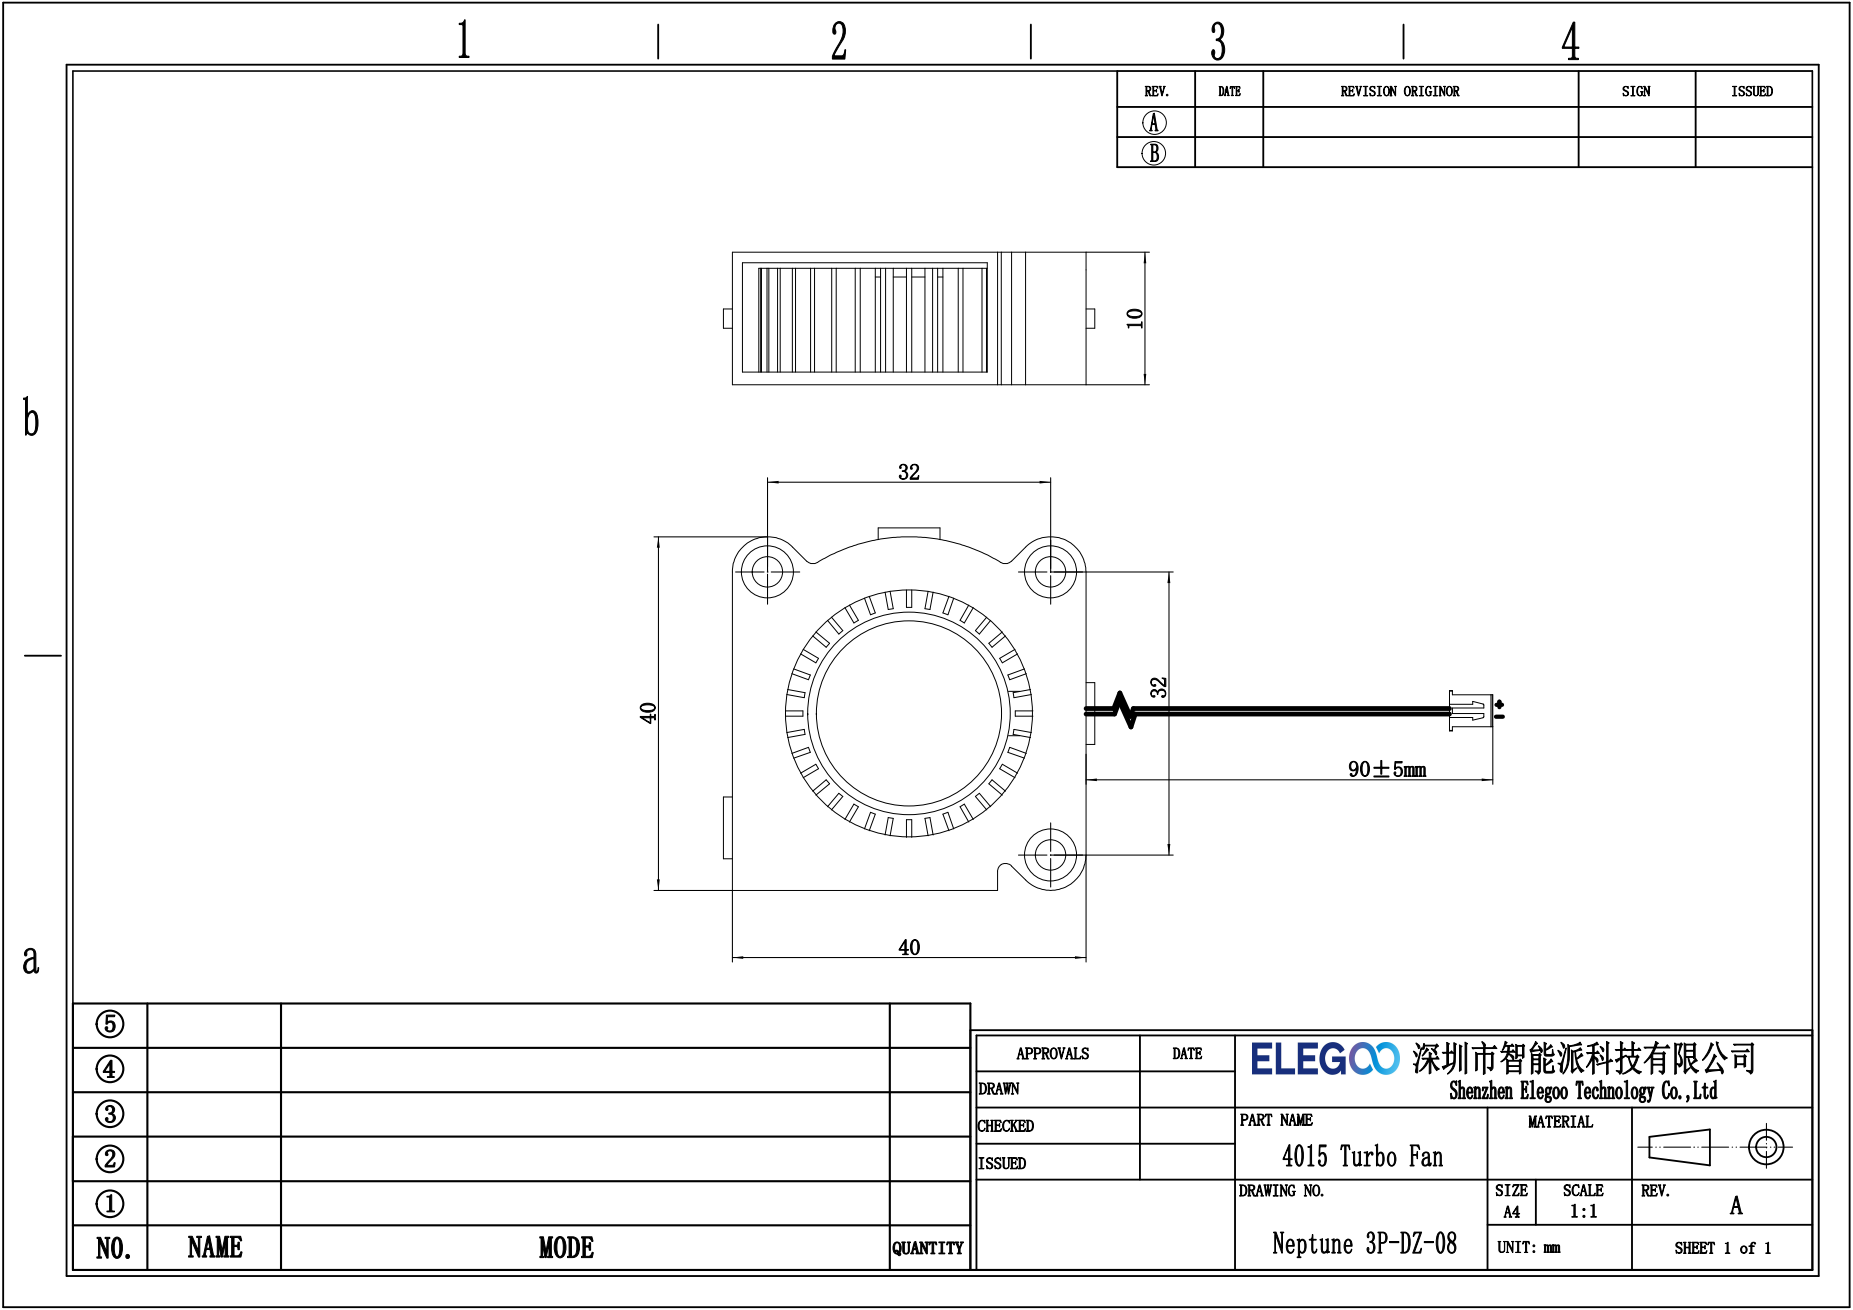
[picture p16: page 1]
