elegooofficial/neptune3pro/Wire/6010 Fan.pdf

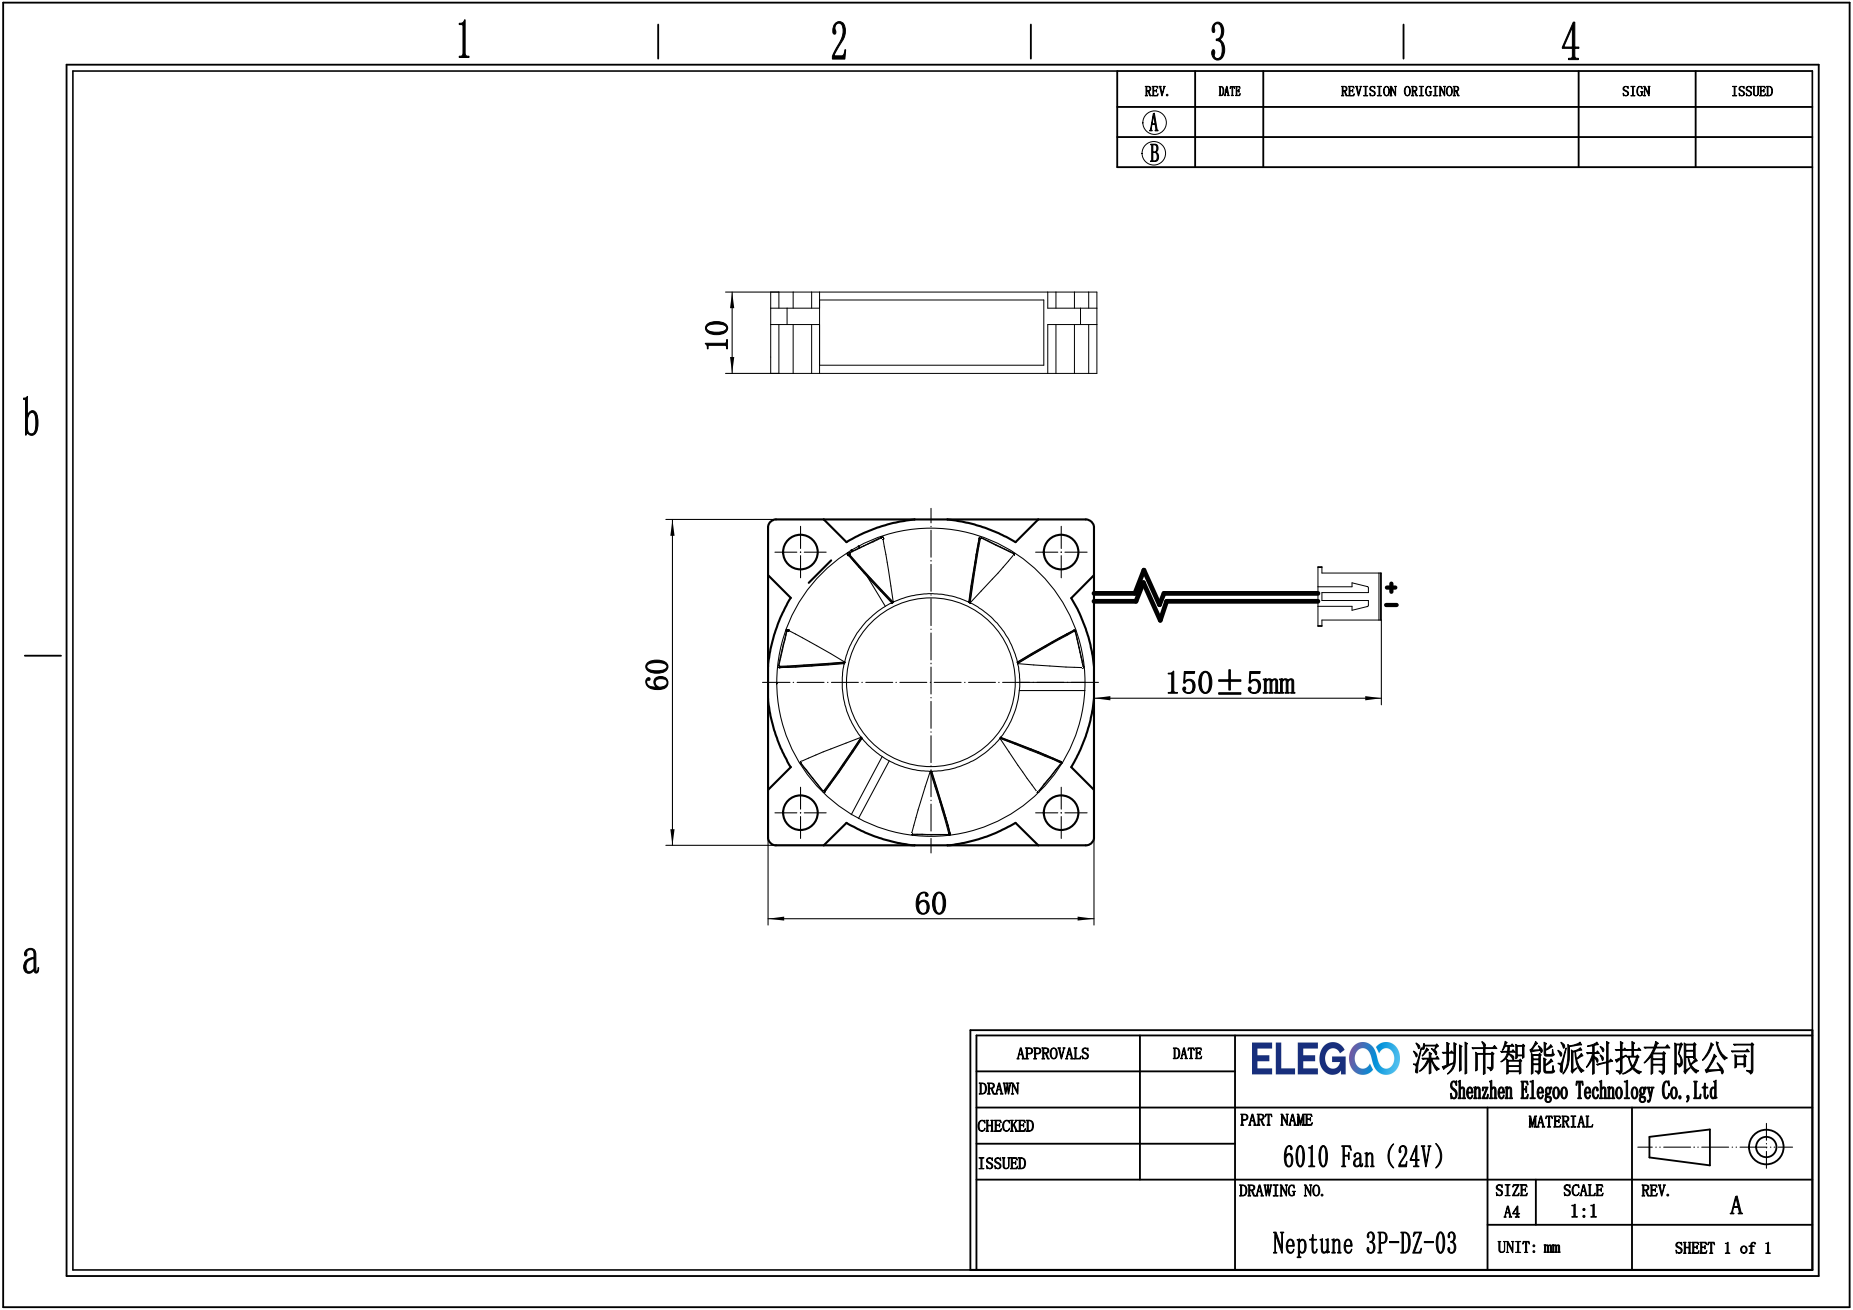
[picture p17: page 1]
