elegooofficial/neptune3pro/Wire/Black DC Wire.pdf

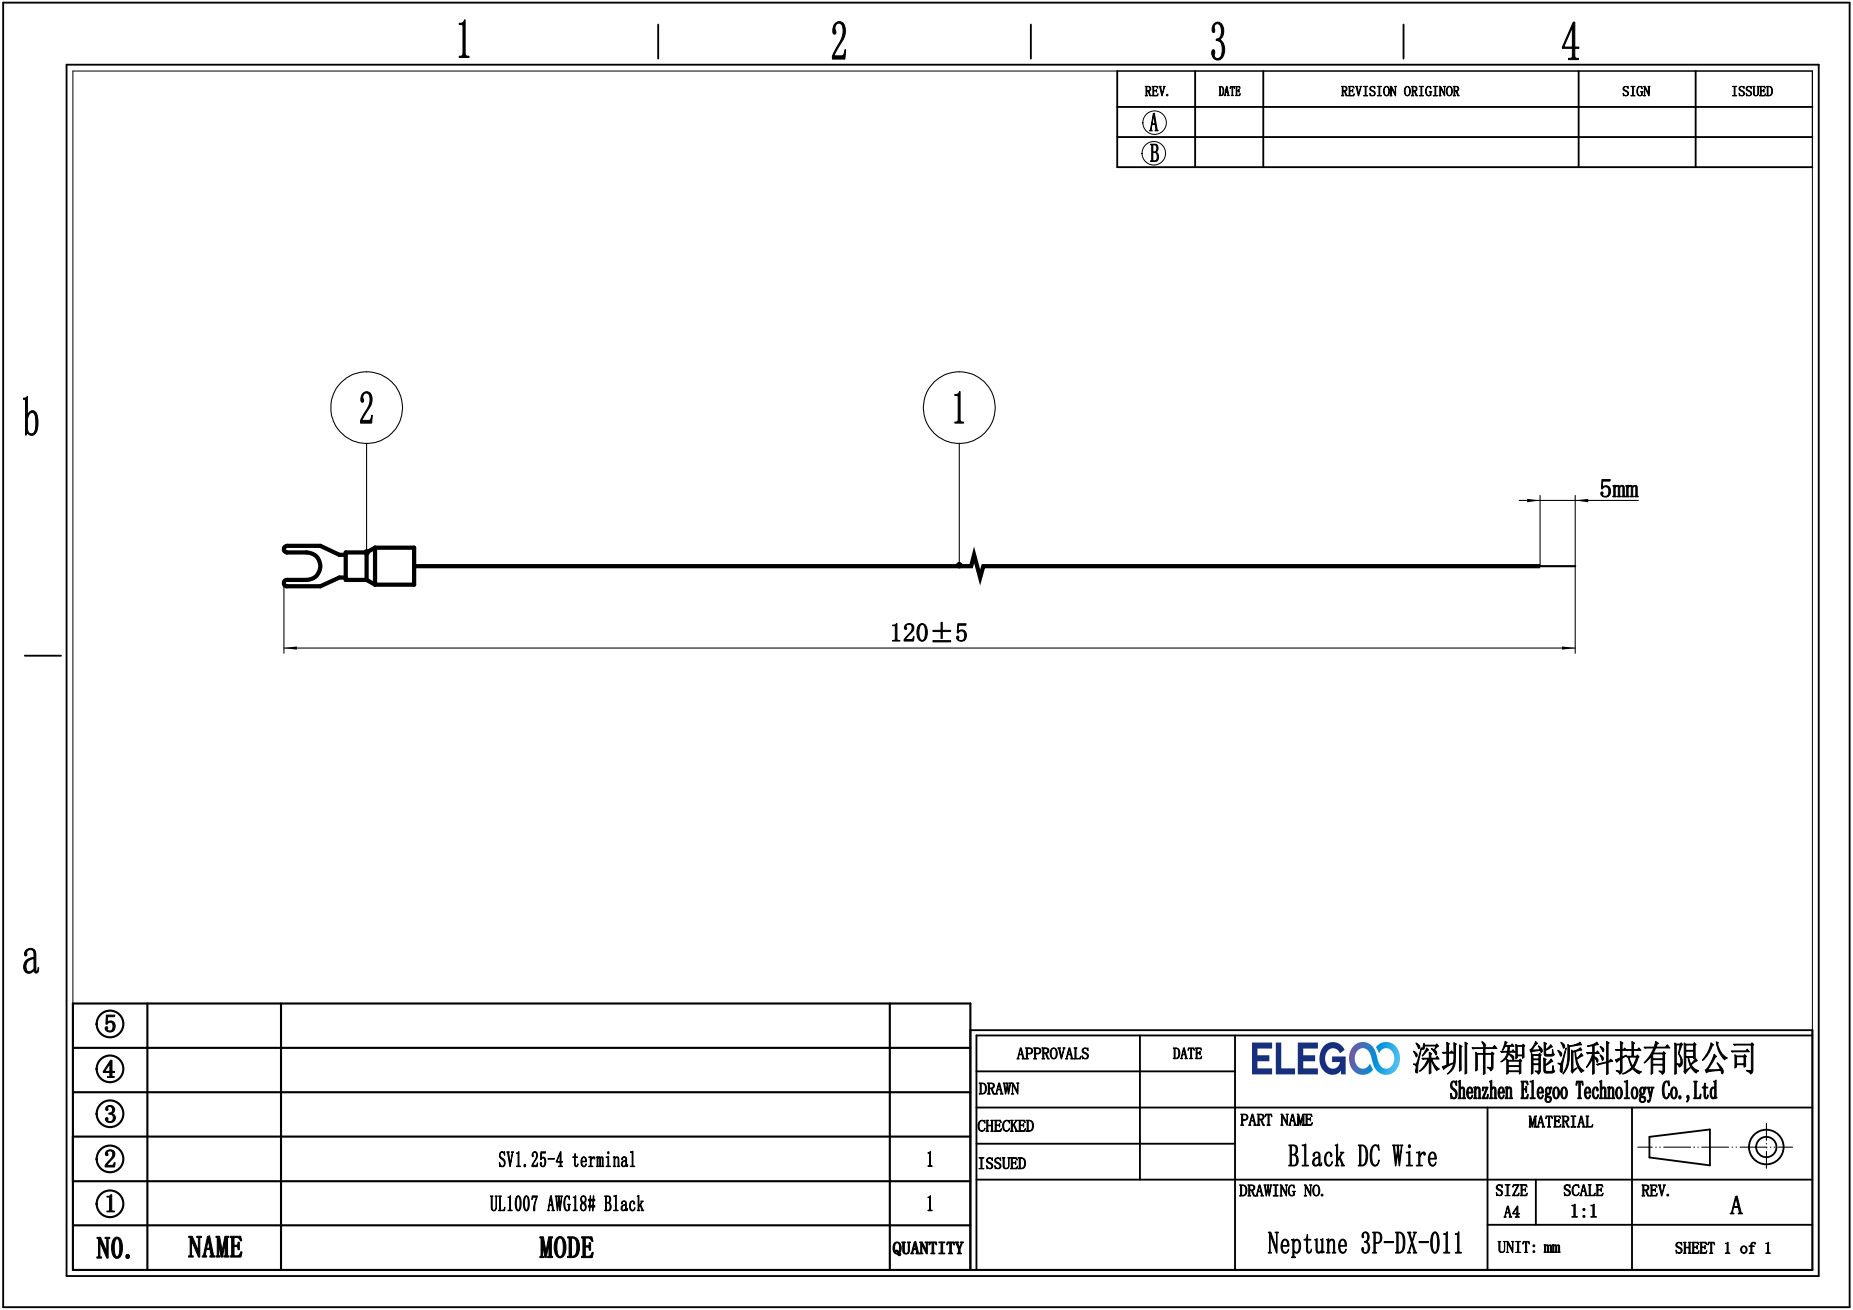
[picture p18: page 1]
