elegooofficial/neptune3pro/Wire/Black Silicone Wire.pdf

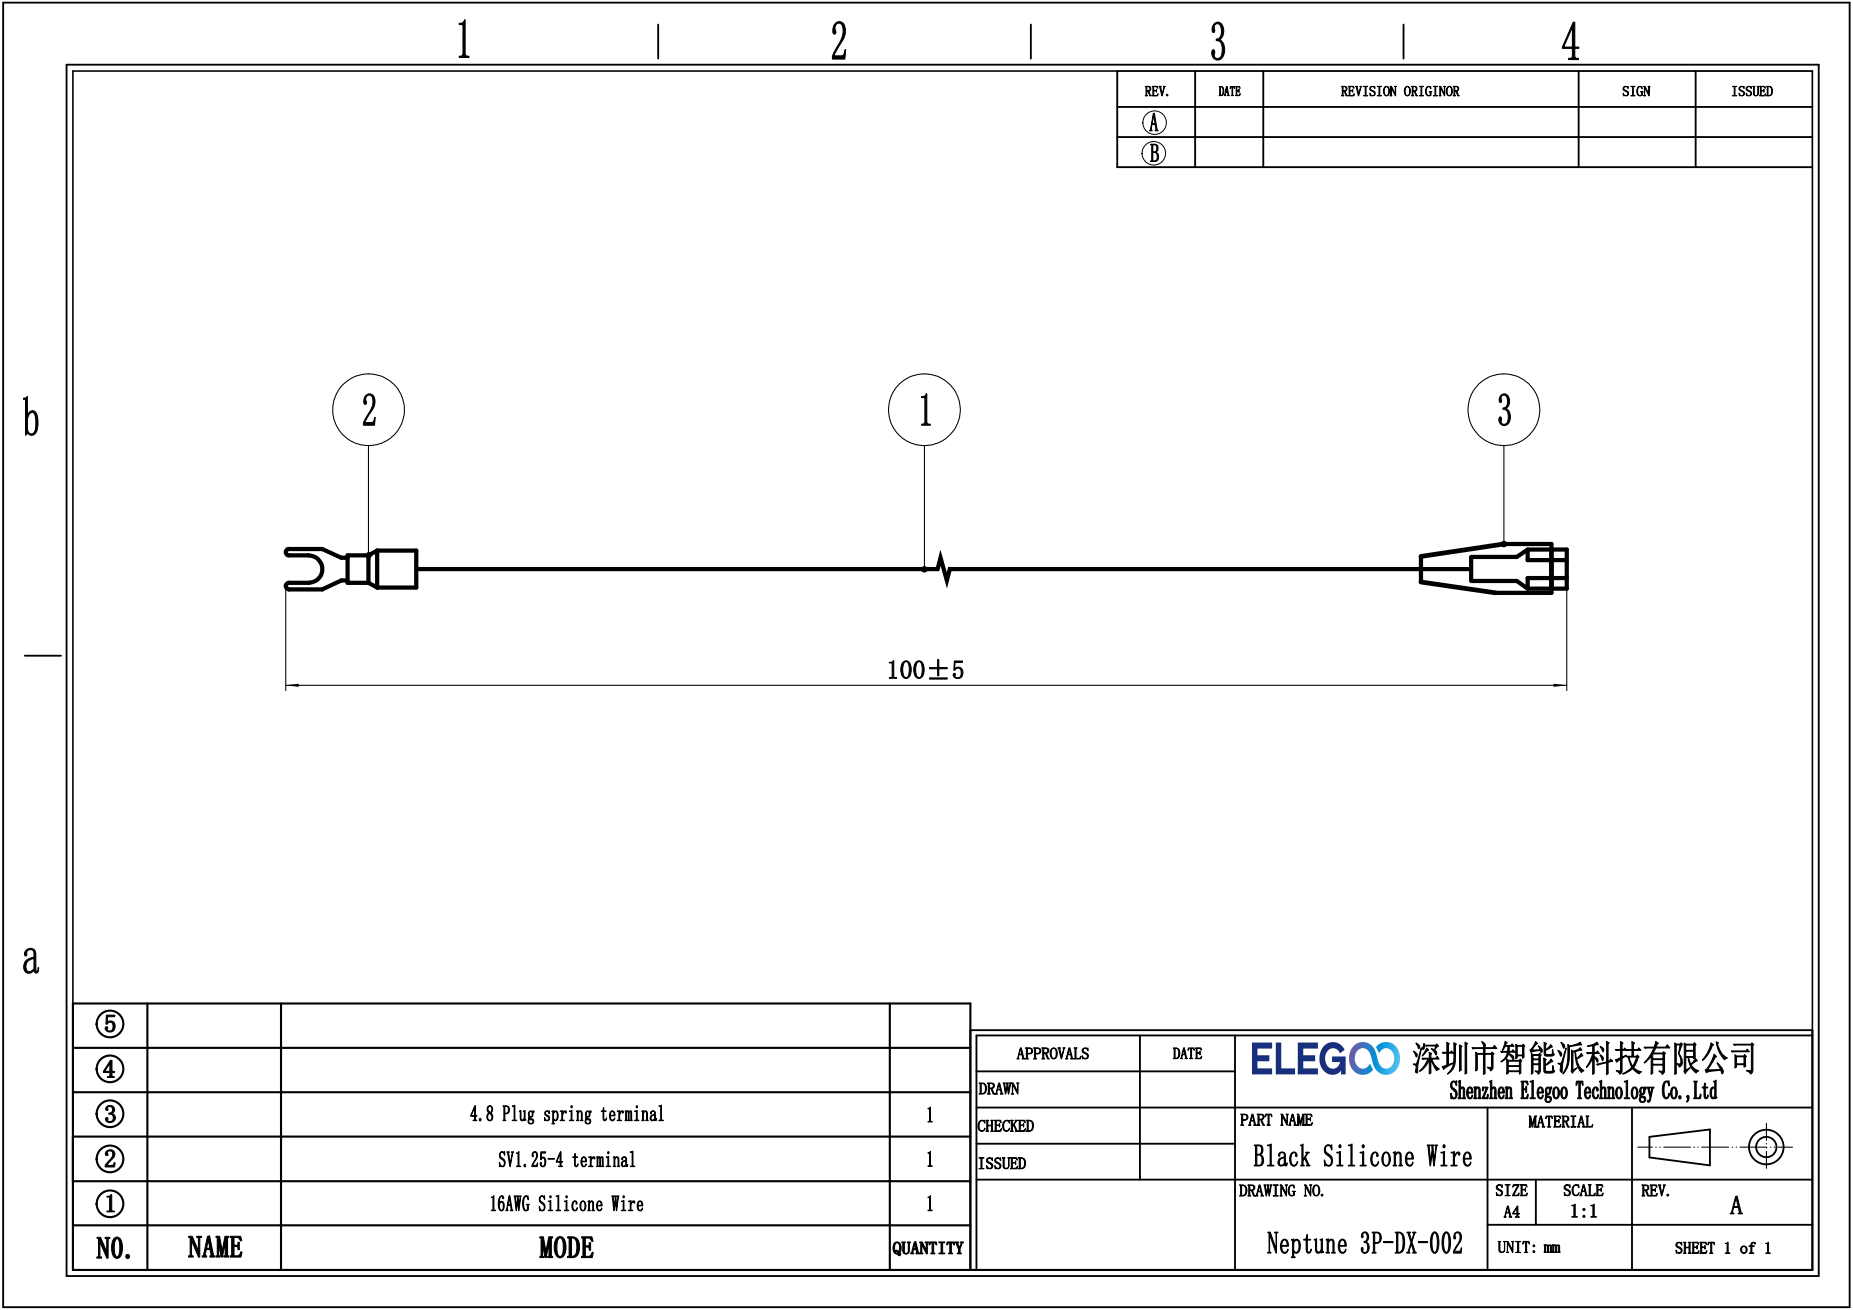
[picture p19: page 1]
