elegooofficial/neptune3pro/Wire/Display Screen Wire_Inside.pdf

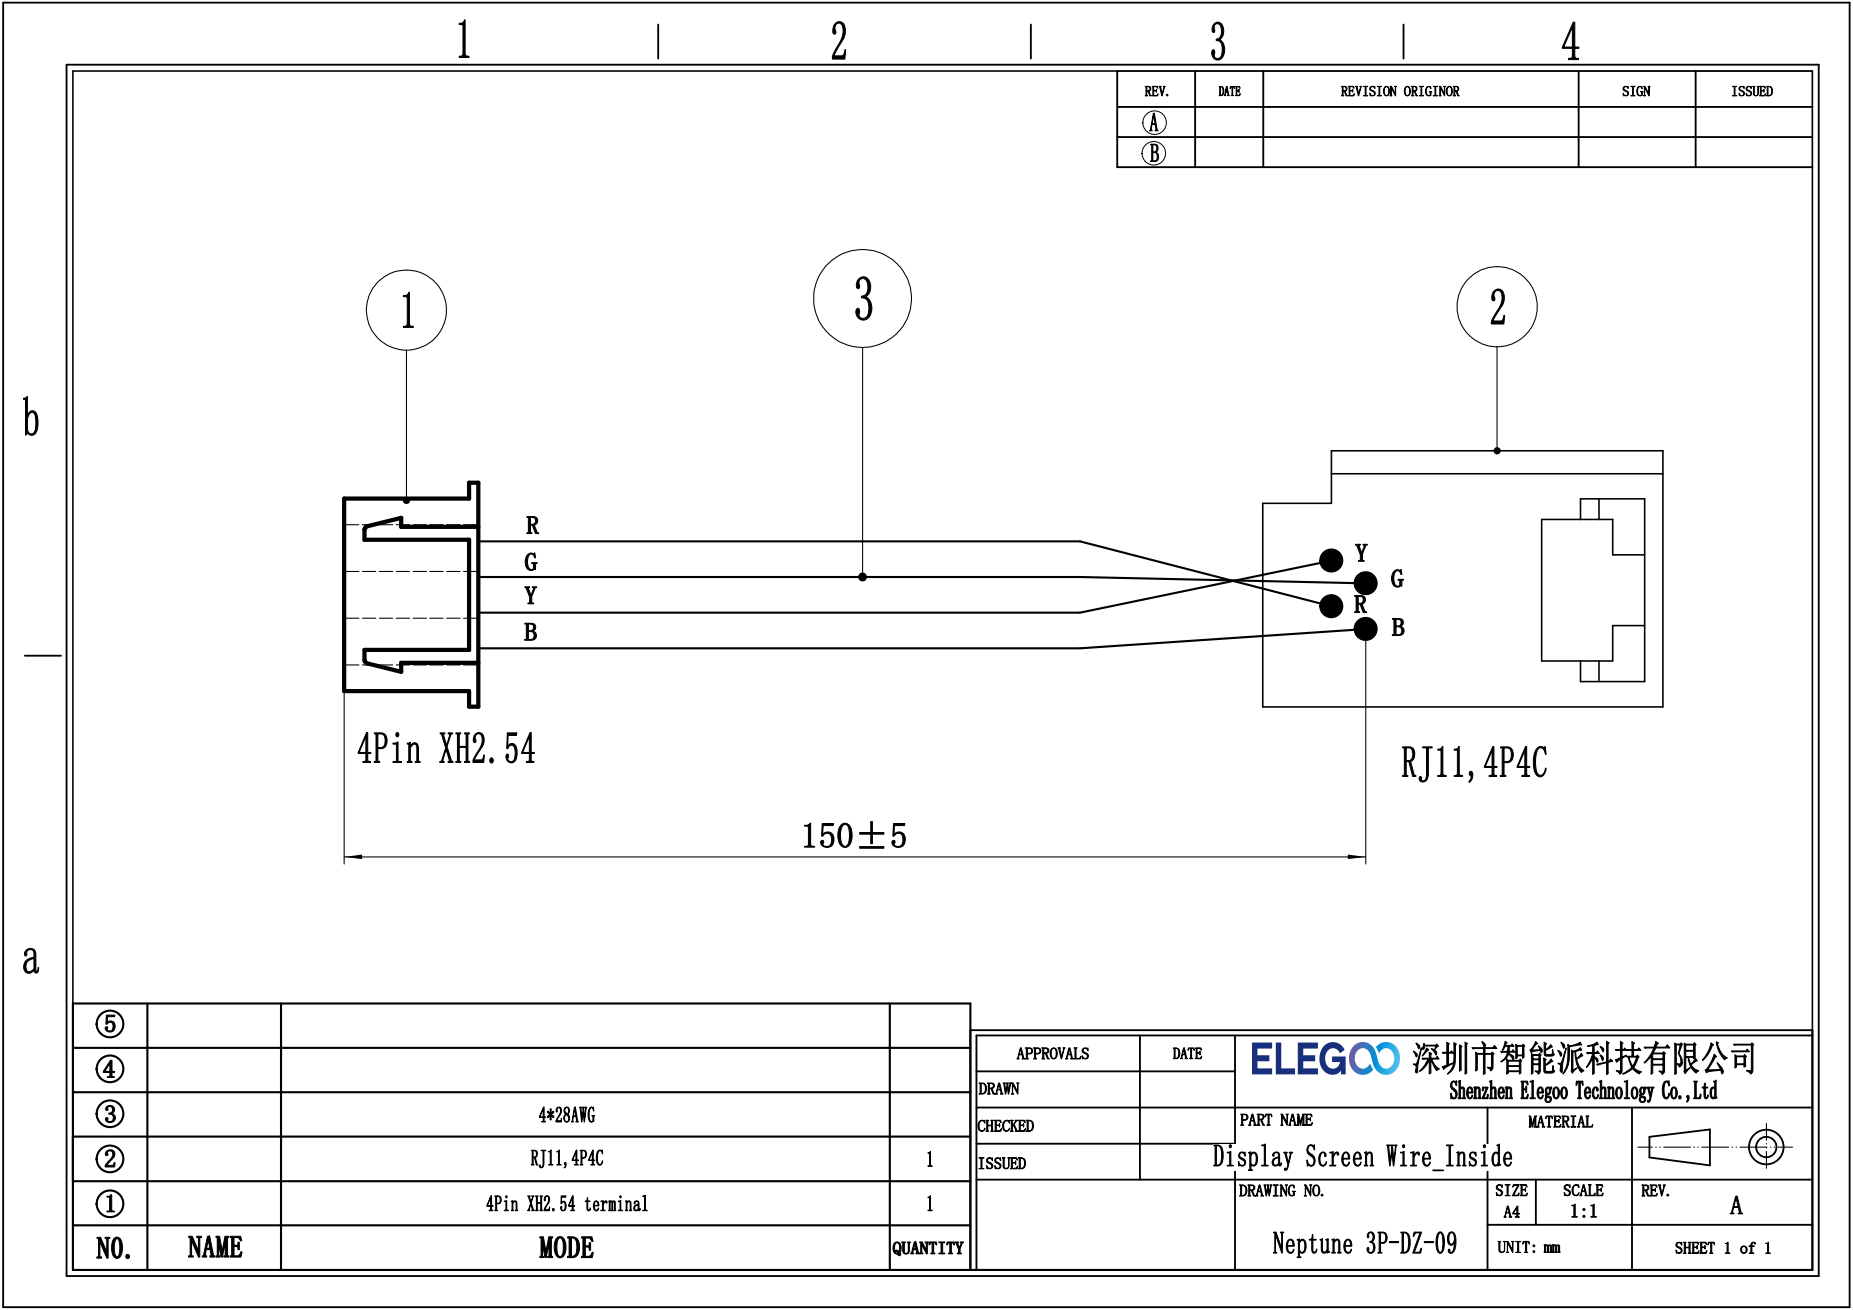
[picture p20: page 1]
