elegooofficial/neptune3pro/Wire/Extruder Cable.pdf

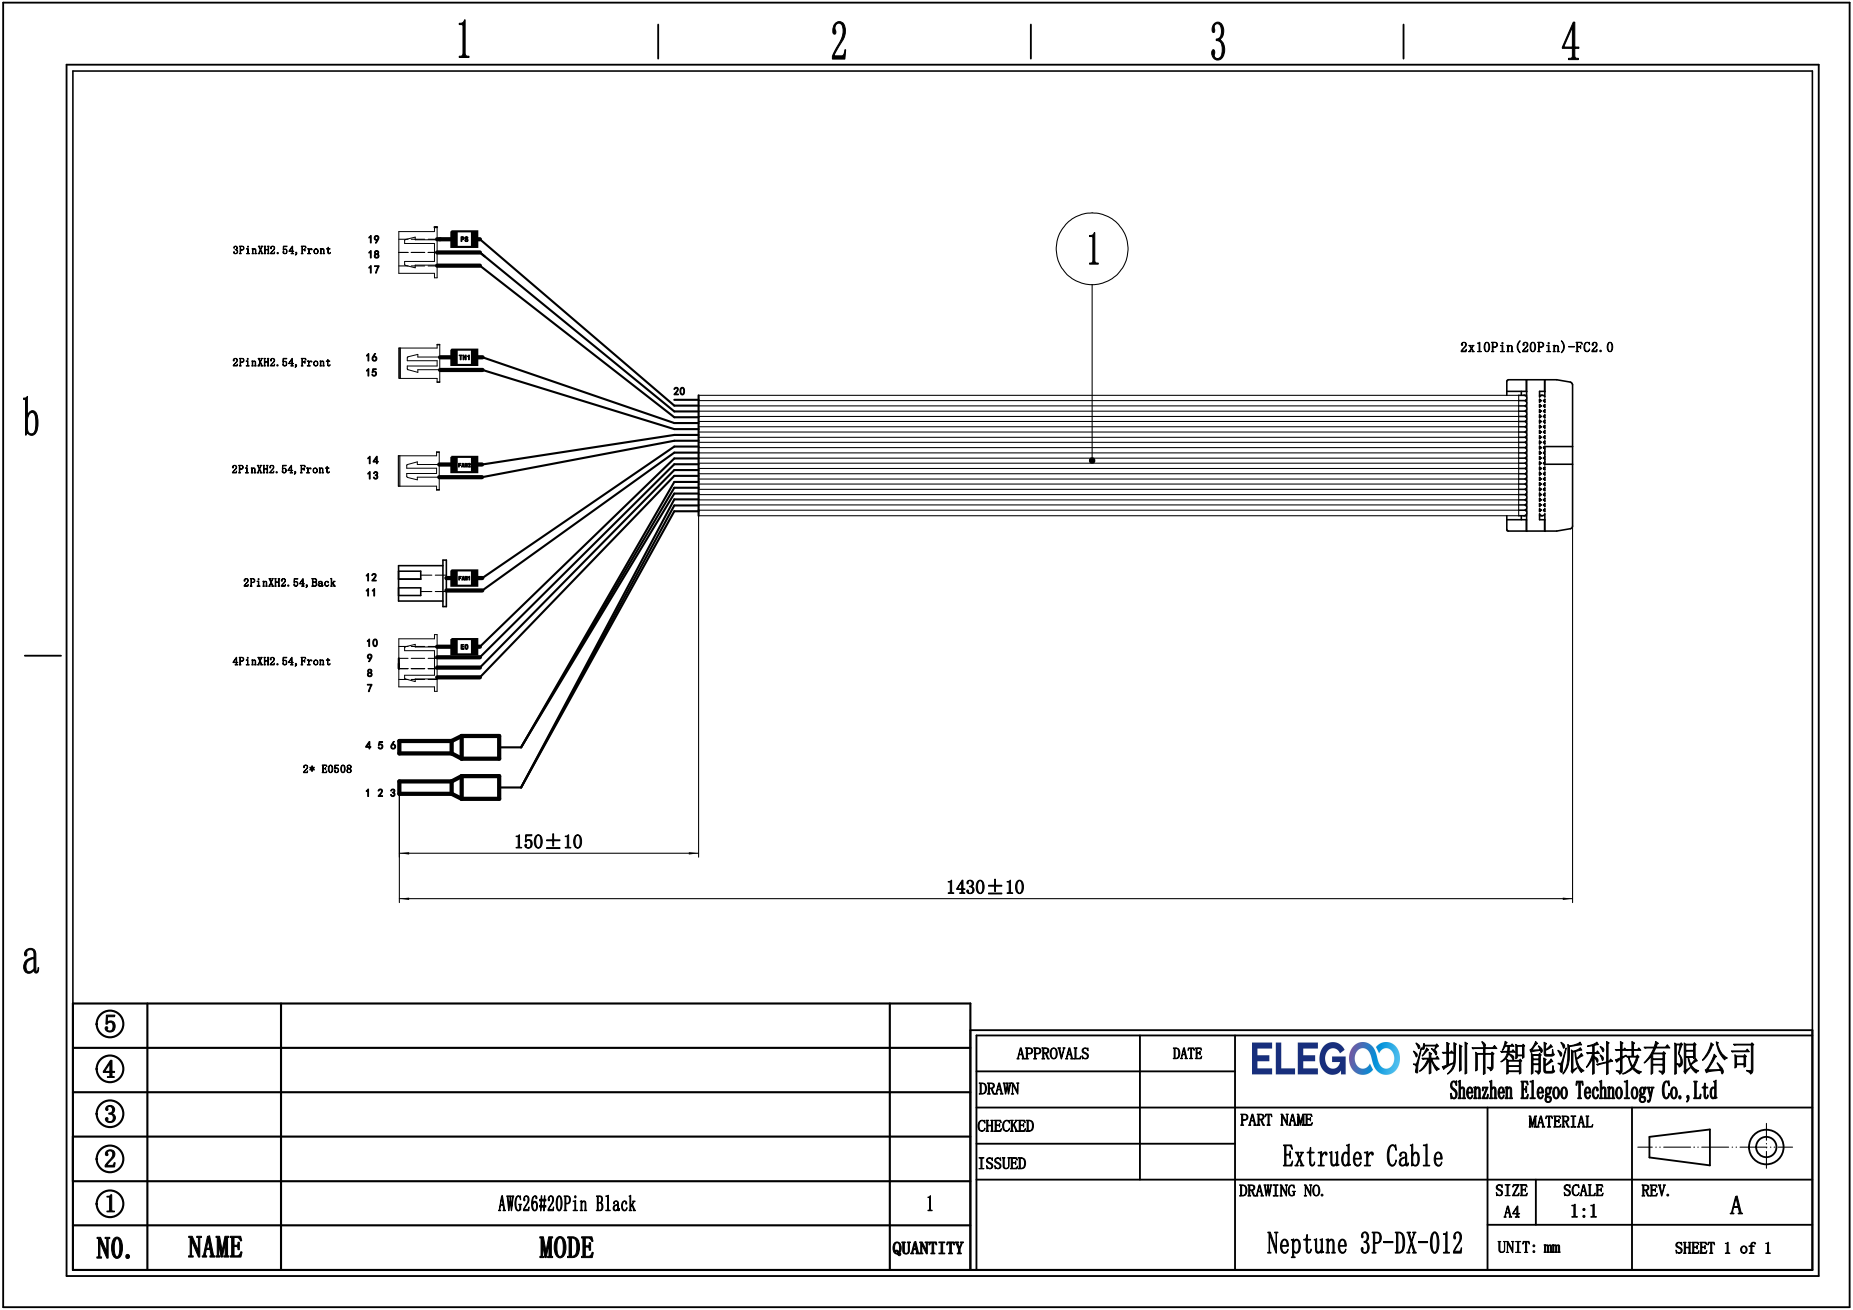
[picture p21: page 1]
