elegooofficial/neptune3pro/Wire/Fan Wire.pdf

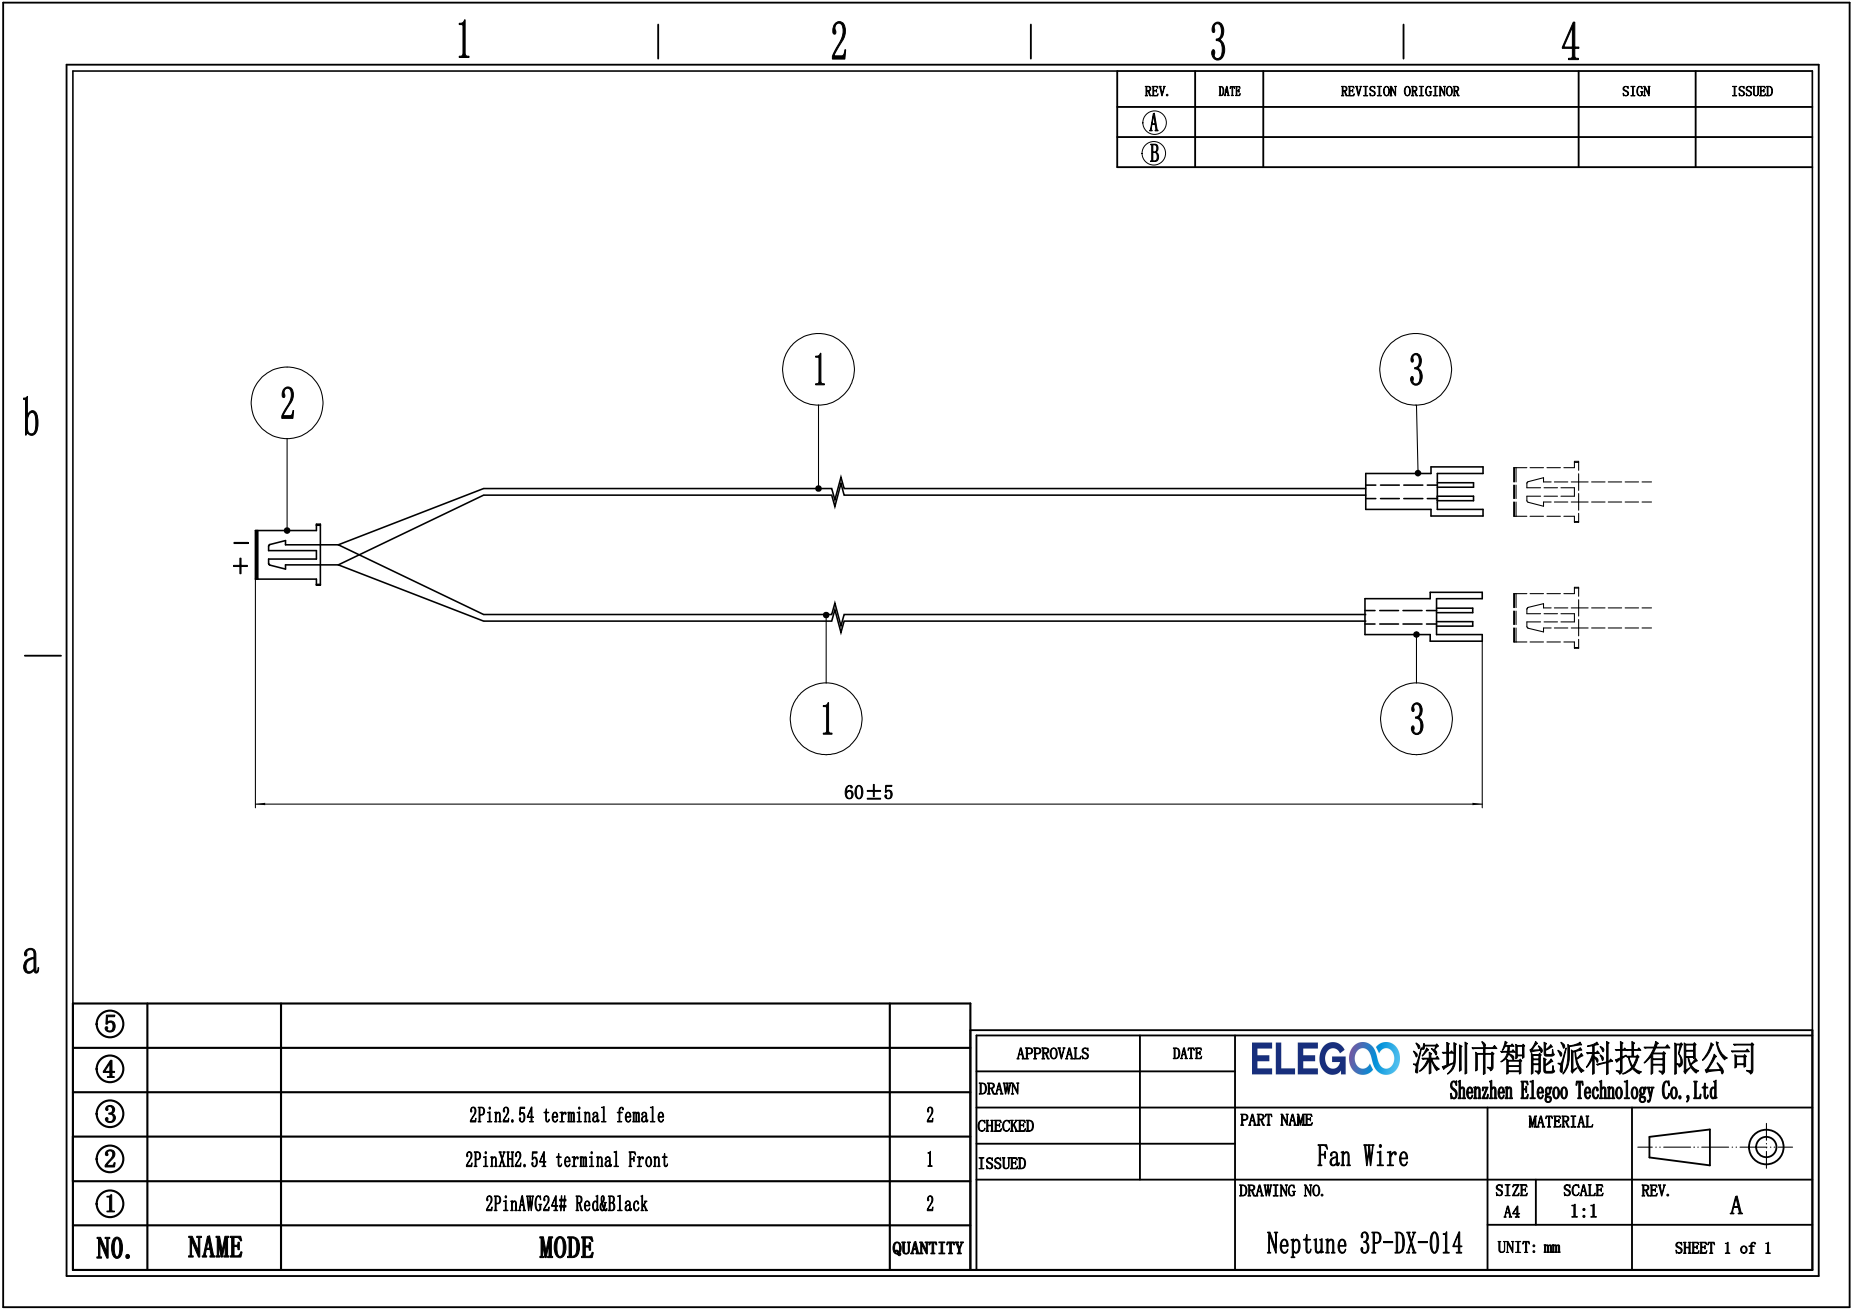
[picture p22: page 1]
