elegooofficial/neptune3pro/Wire/Filament Detector and LED Wire.pdf

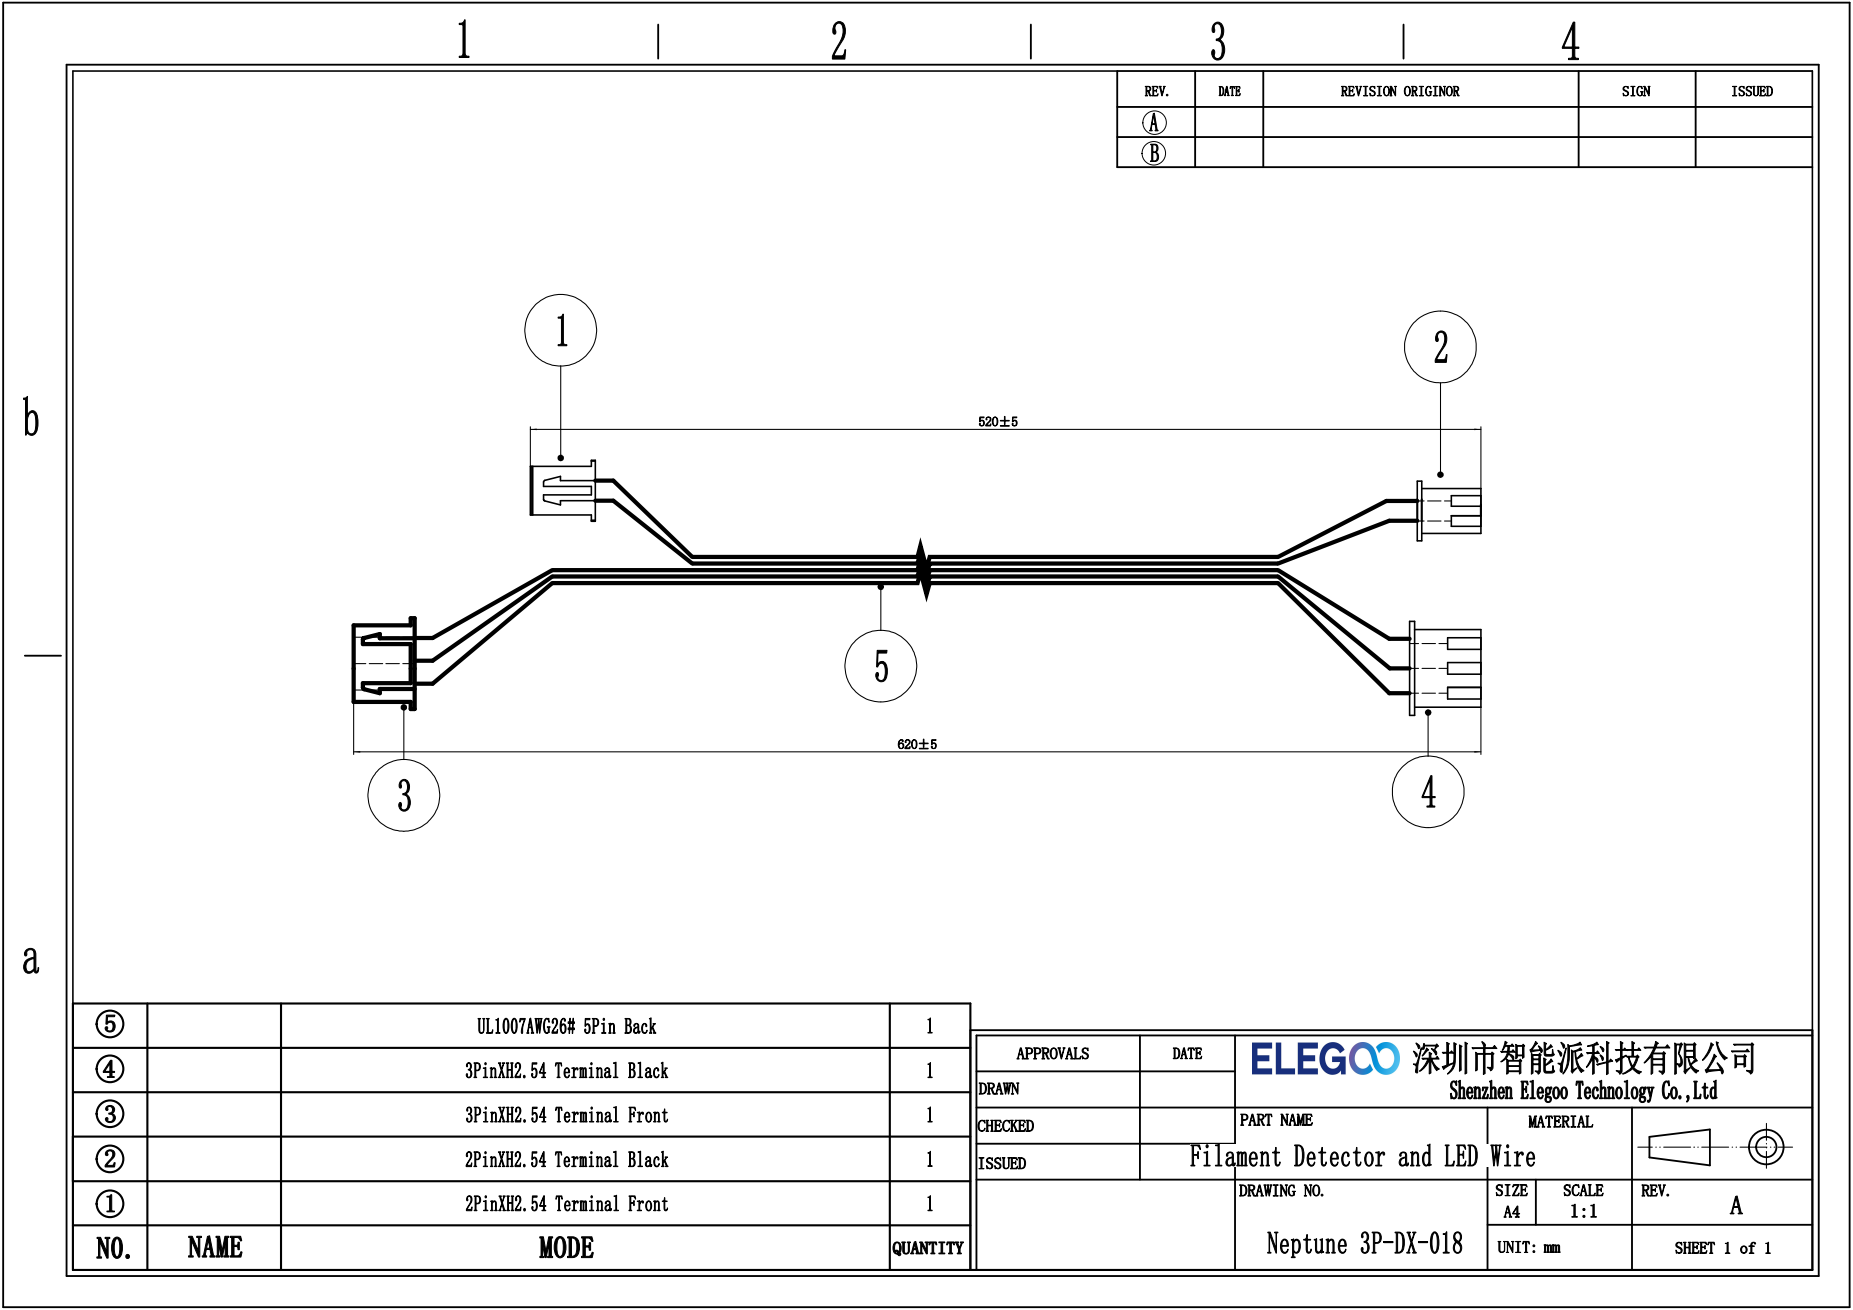
[picture p23: page 1]
