elegooofficial/neptune3pro/Wire/Filament Detector Wire.pdf

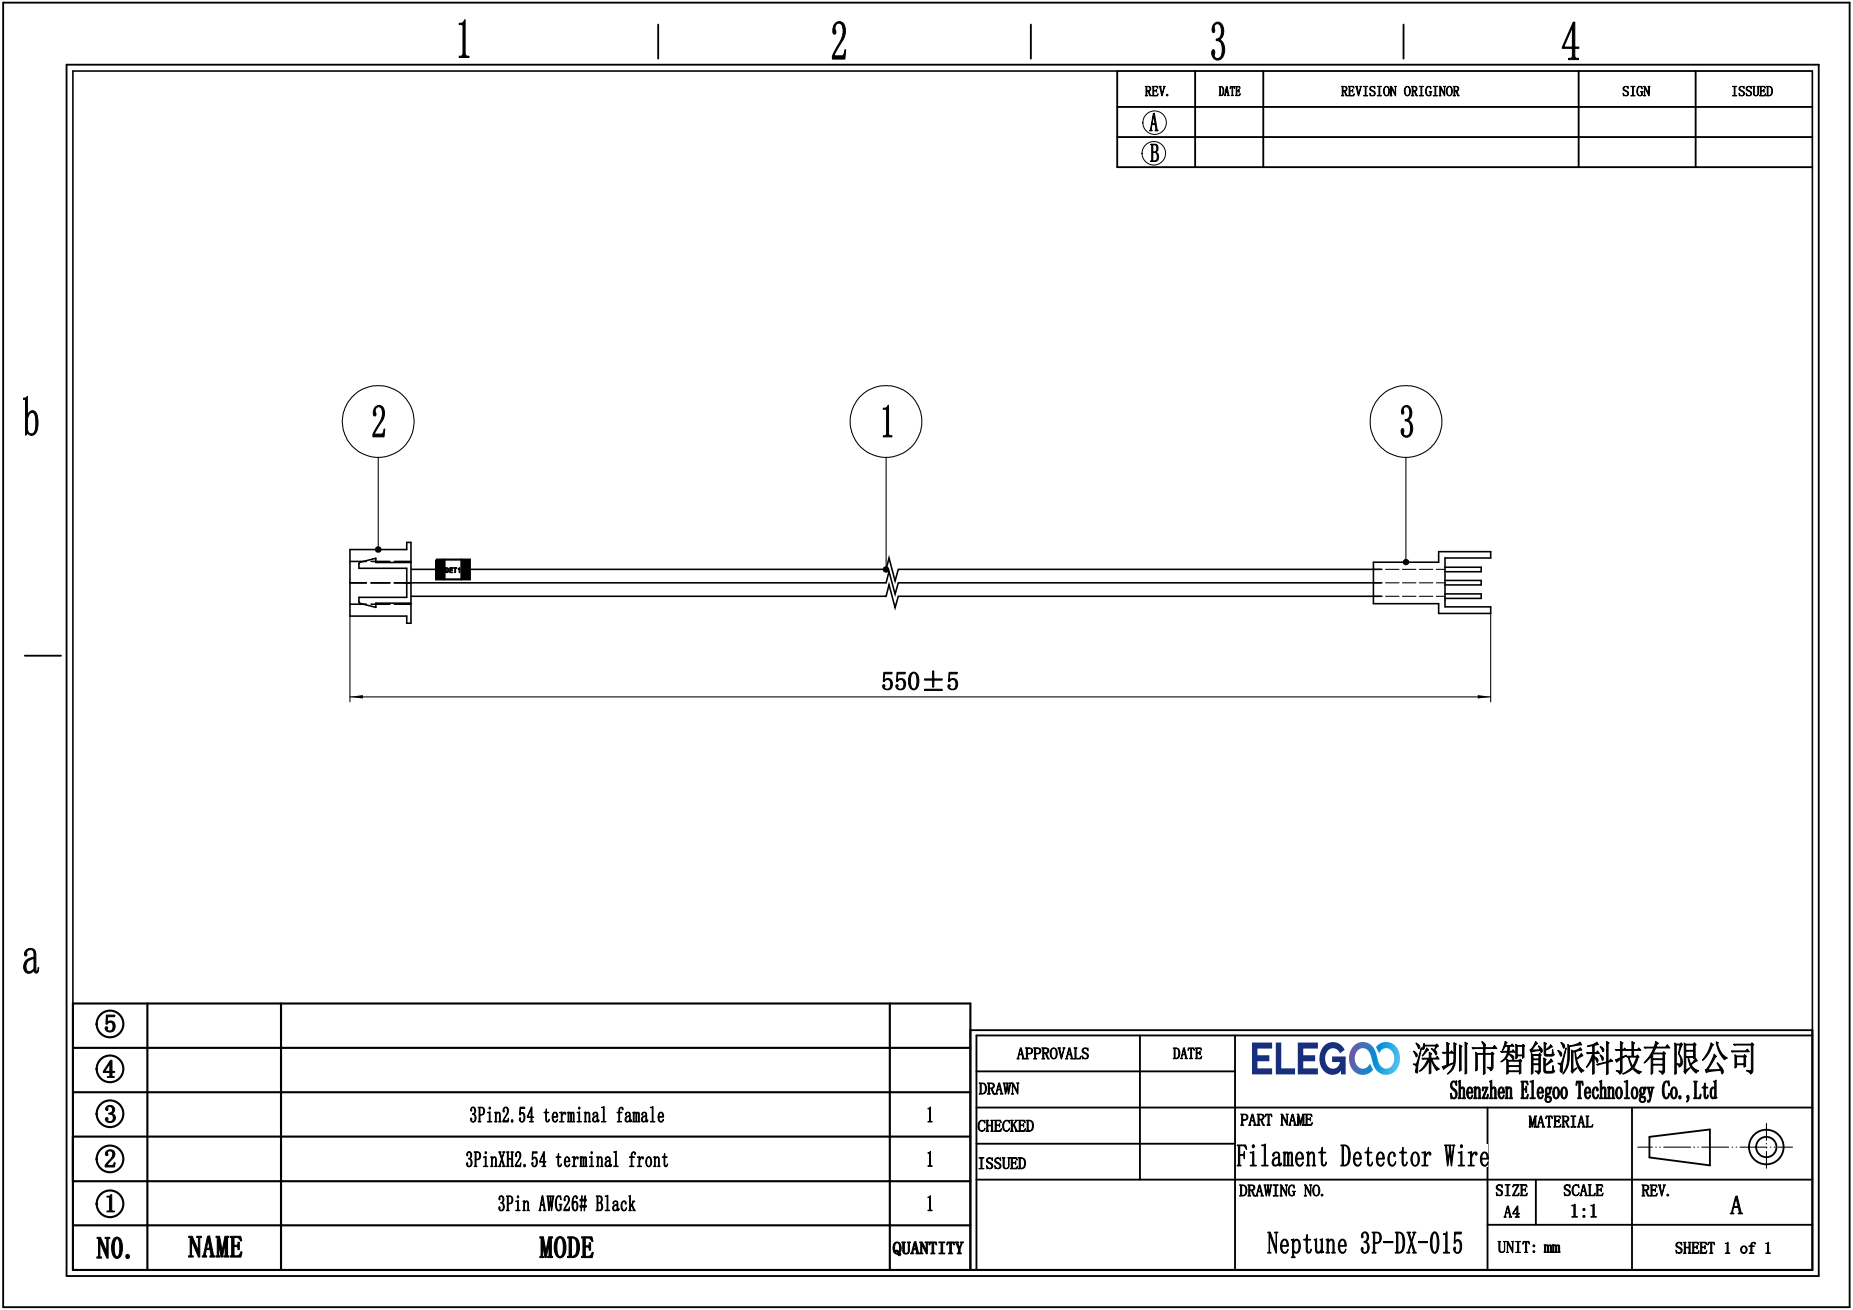
[picture p24: page 1]
