elegooofficial/neptune3pro/Wire/Ground Wire_Power Supply.pdf

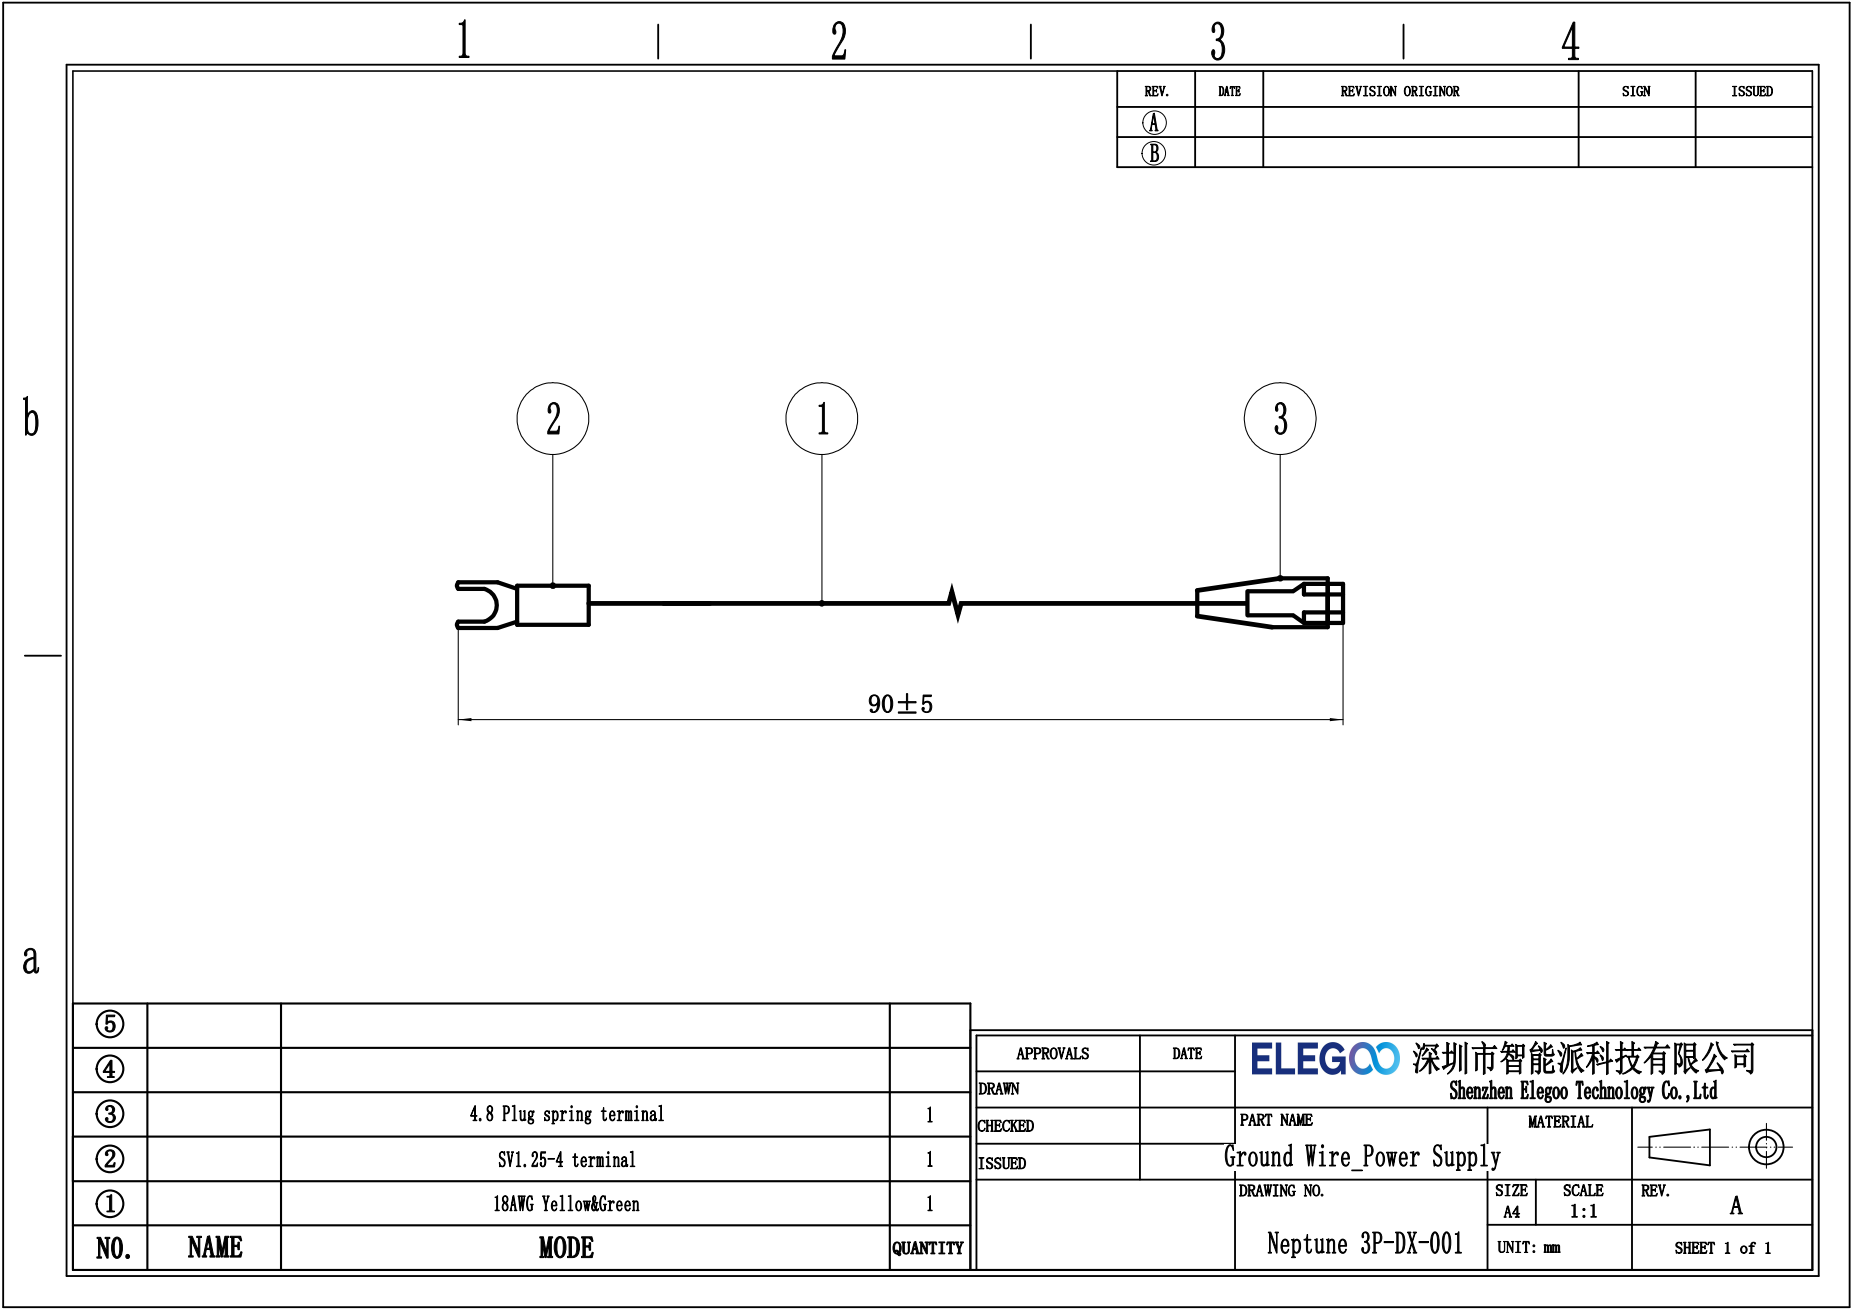
[picture p25: page 1]
