elegooofficial/neptune3pro/Wire/Heated Bed Wire.pdf

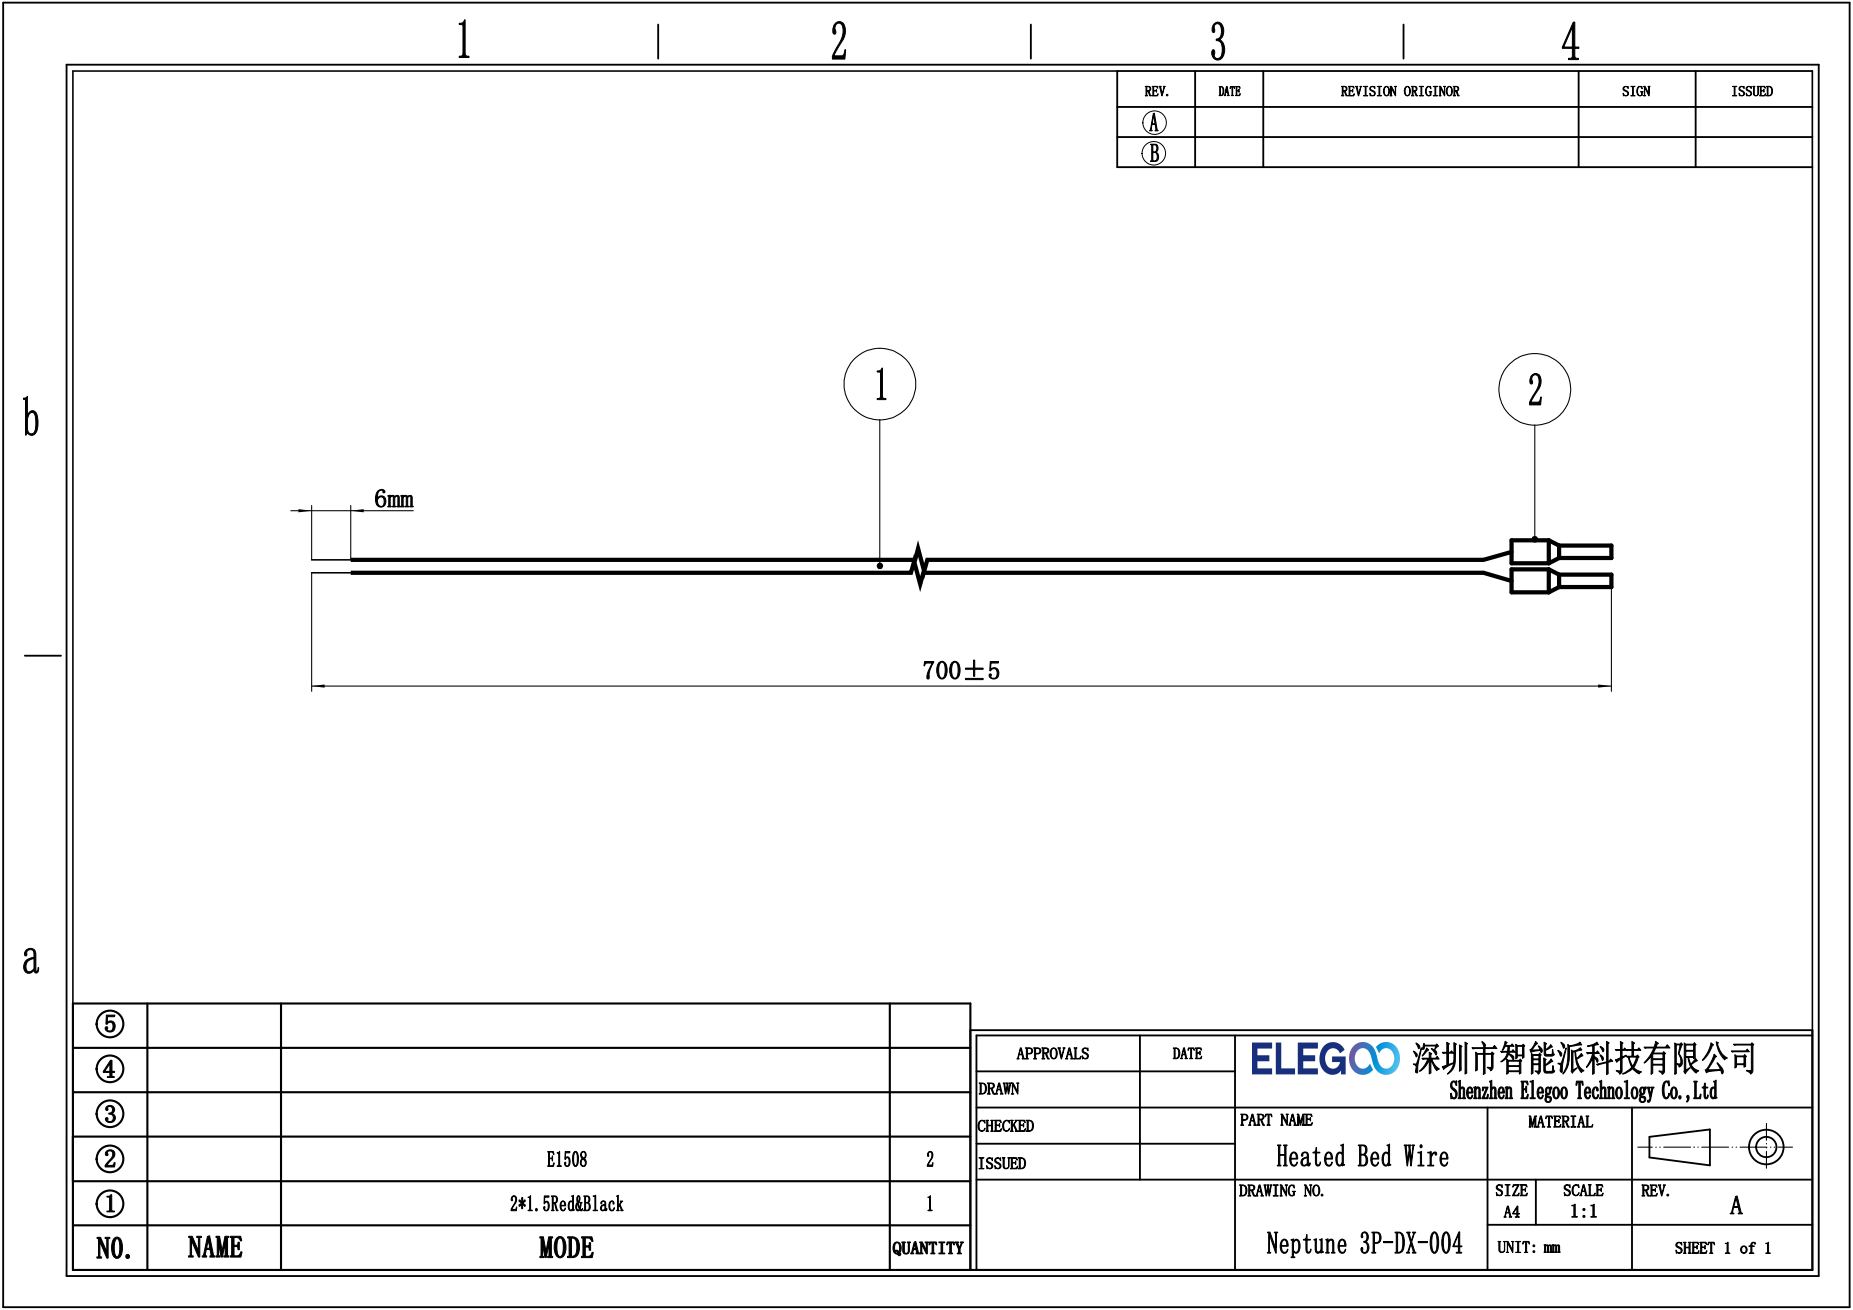
[picture p26: page 1]
