elegooofficial/neptune3pro/Wire/Heating Tube.pdf

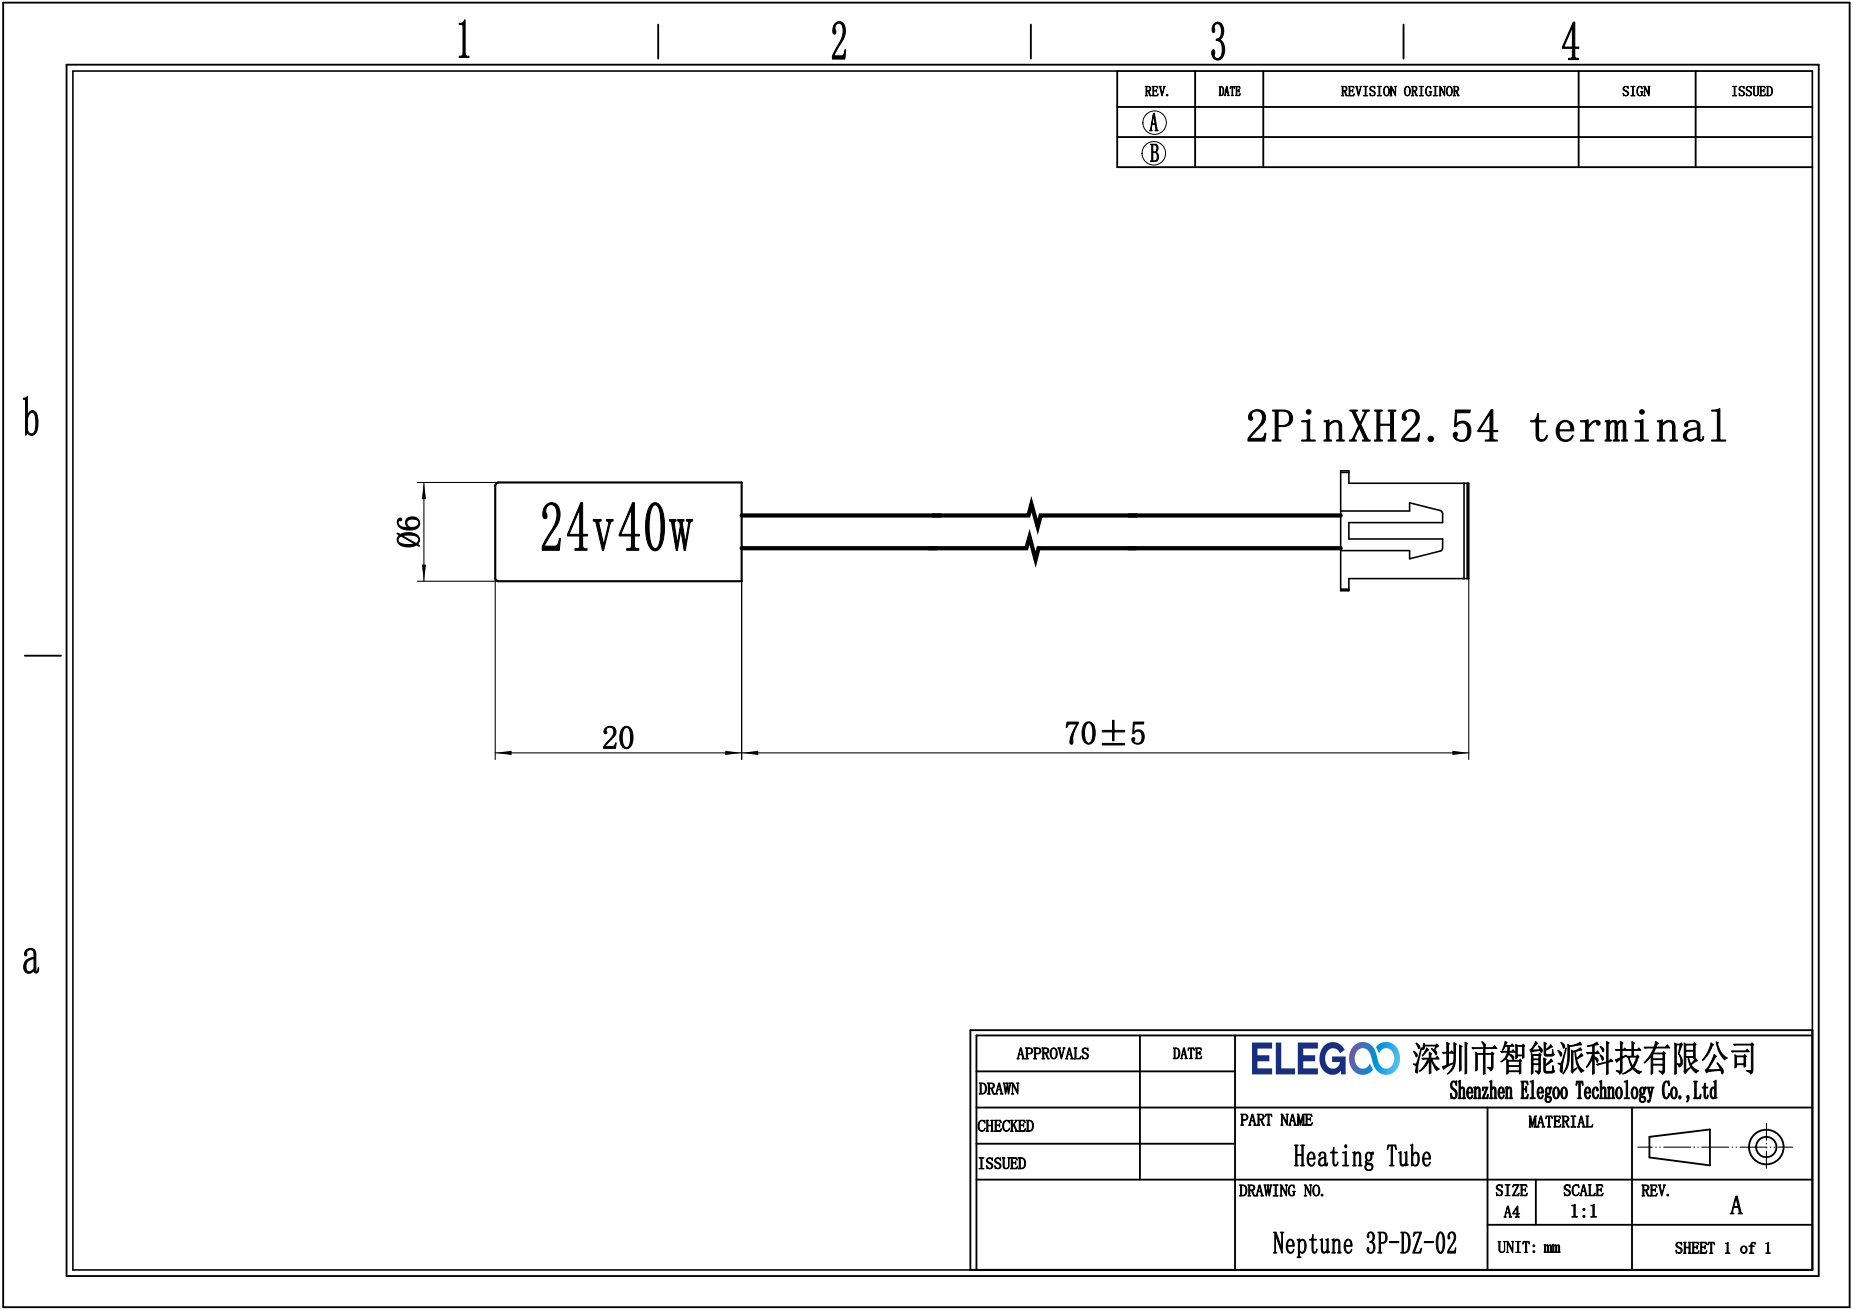
[picture p27: page 1]
