elegooofficial/neptune3pro/Wire/LED Wire.pdf

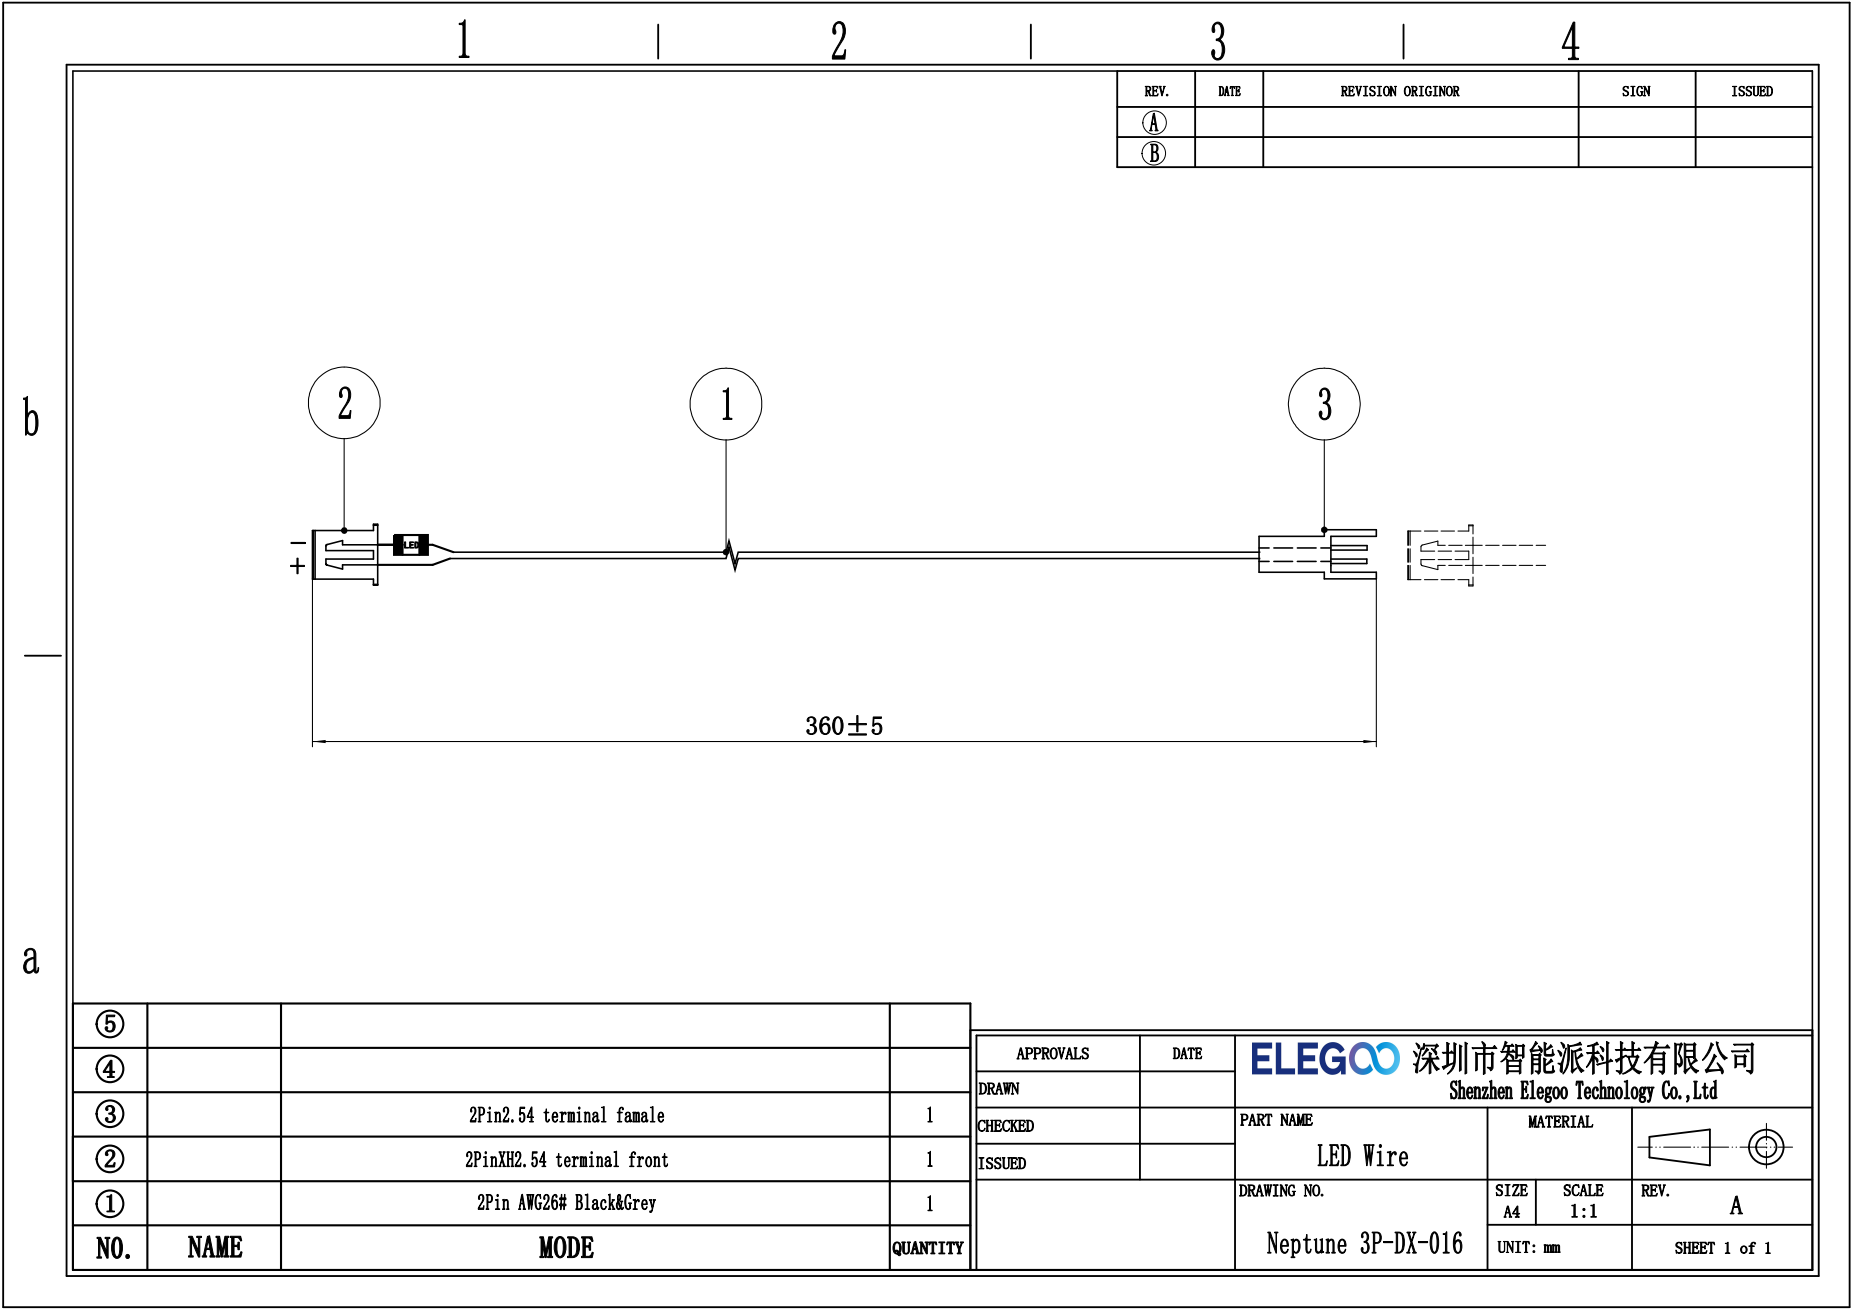
[picture p28: page 1]
