elegooofficial/neptune3pro/Wire/Level Sensor.pdf

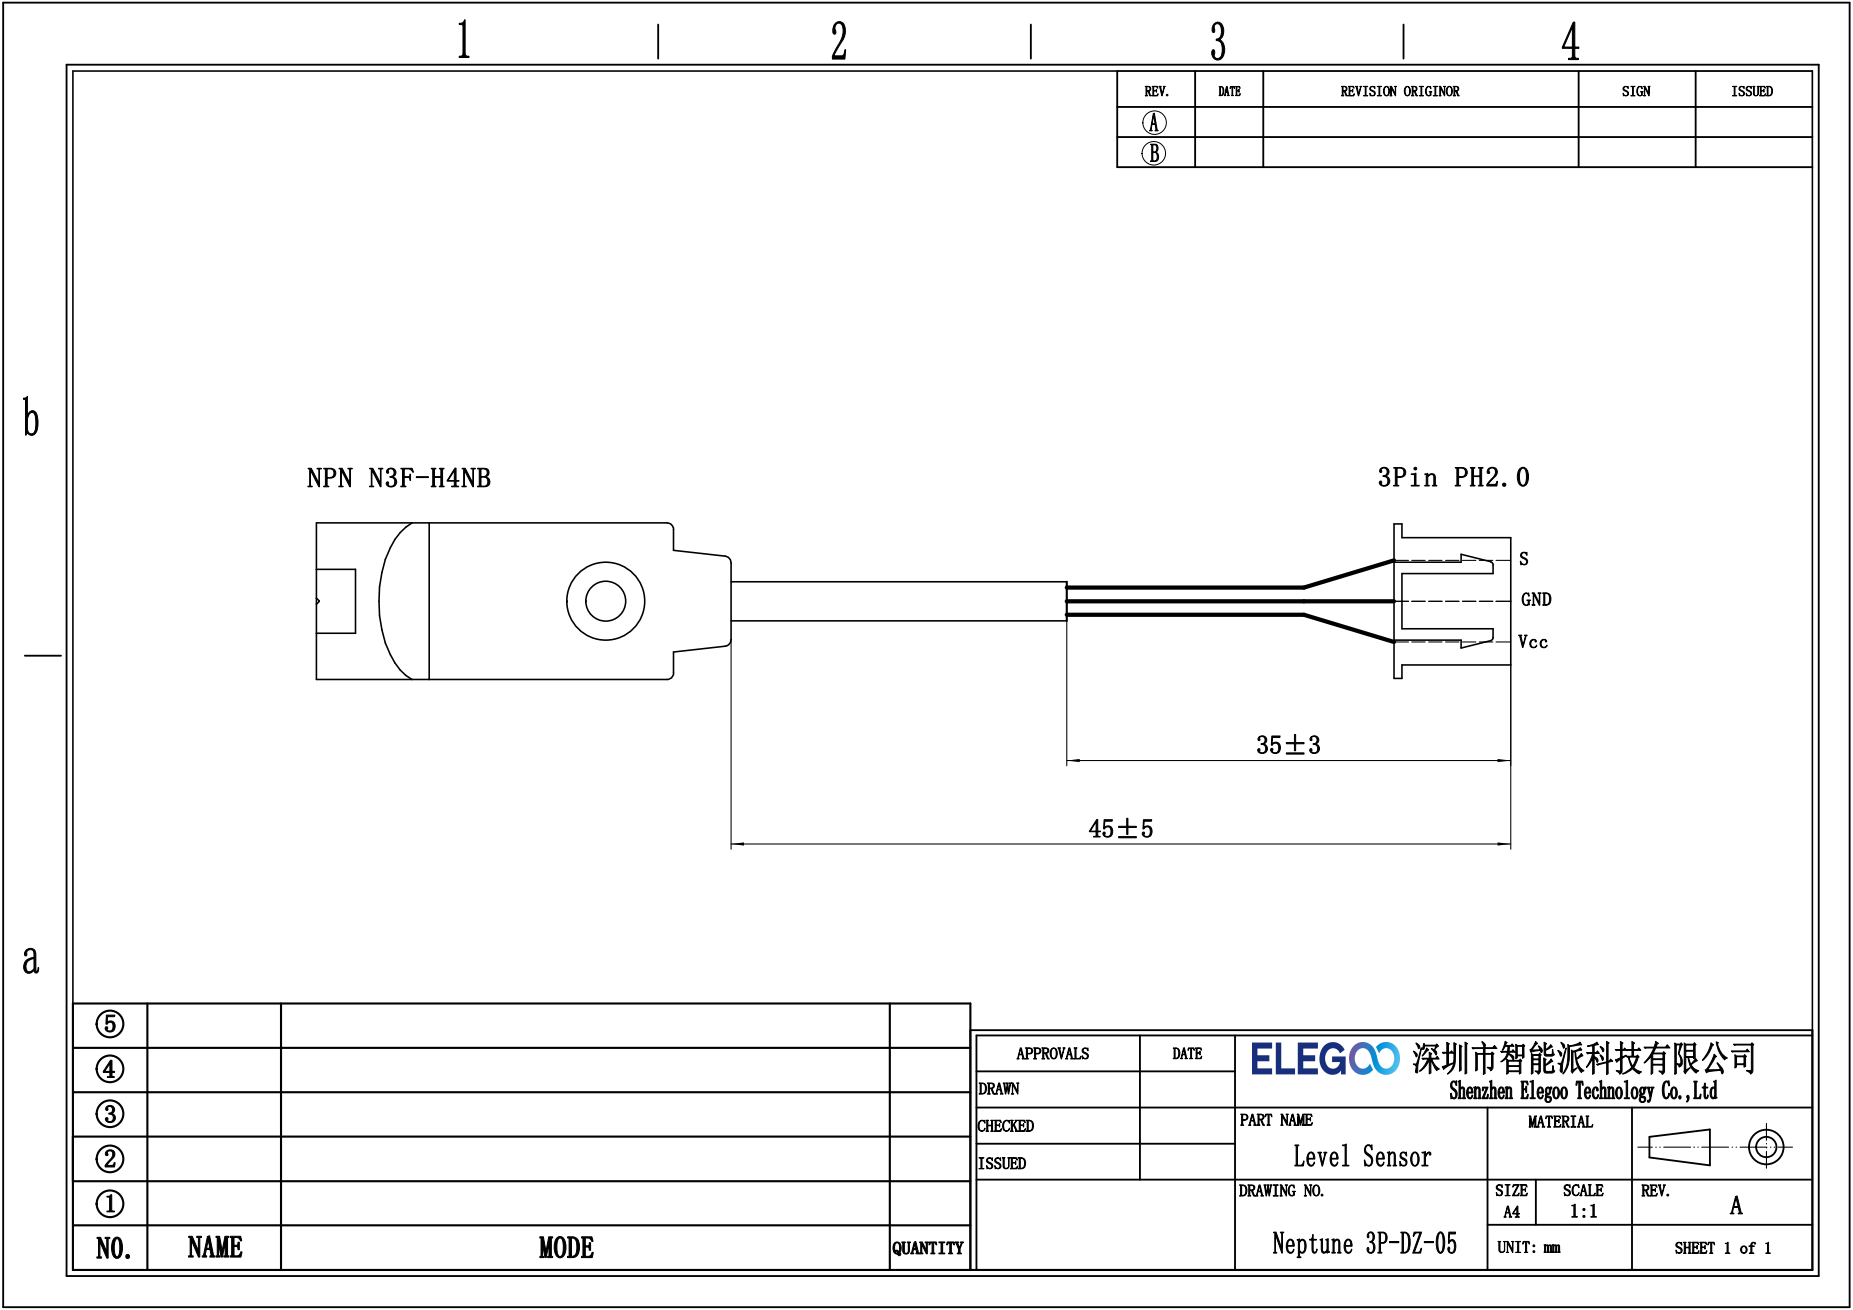
[picture p29: page 1]
