elegooofficial/neptune3pro/Wire/Mainboard Wire.pdf

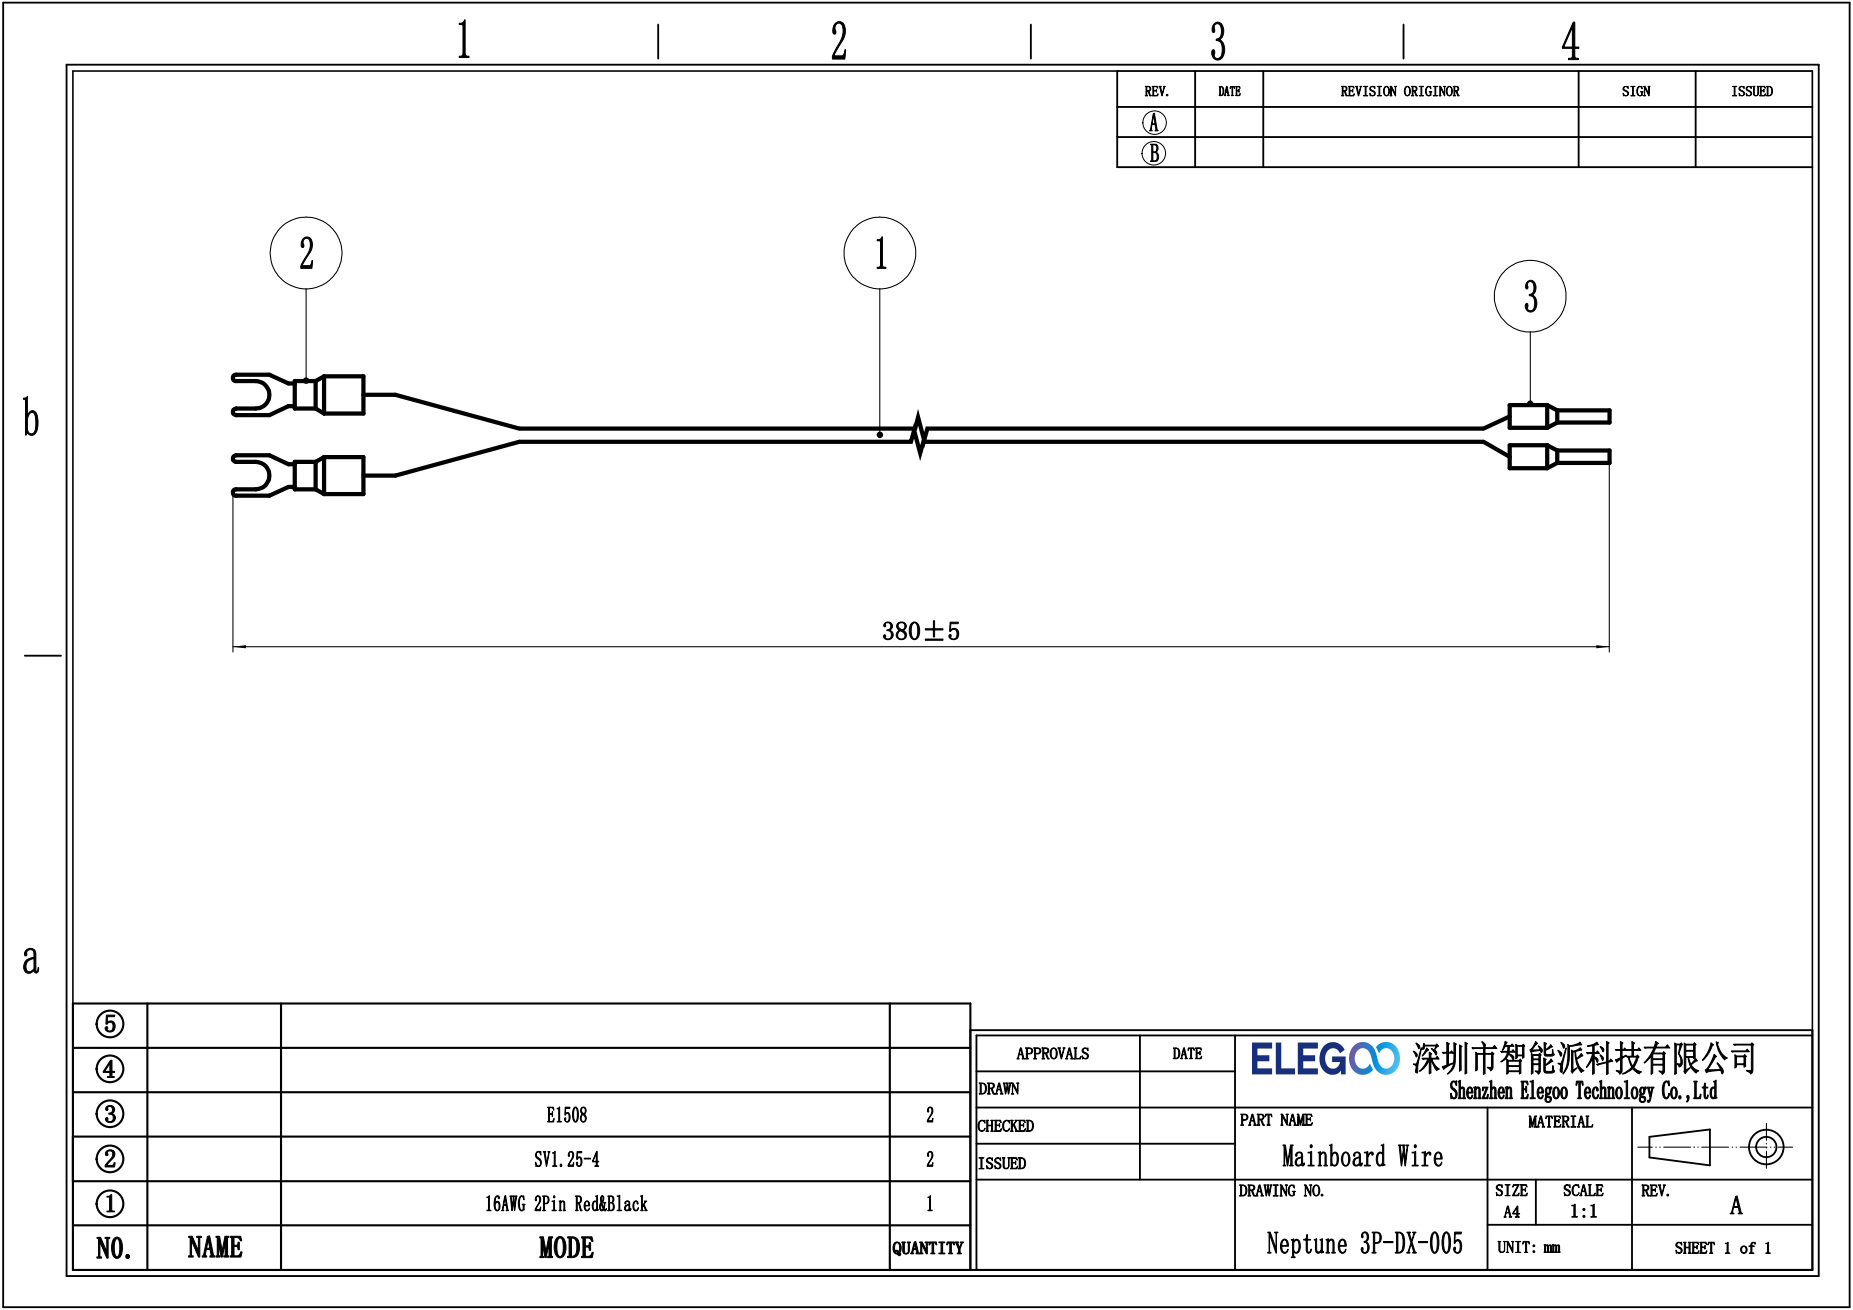
[picture p30: page 1]
