elegooofficial/neptune3pro/Wire/Red DC Wire.pdf

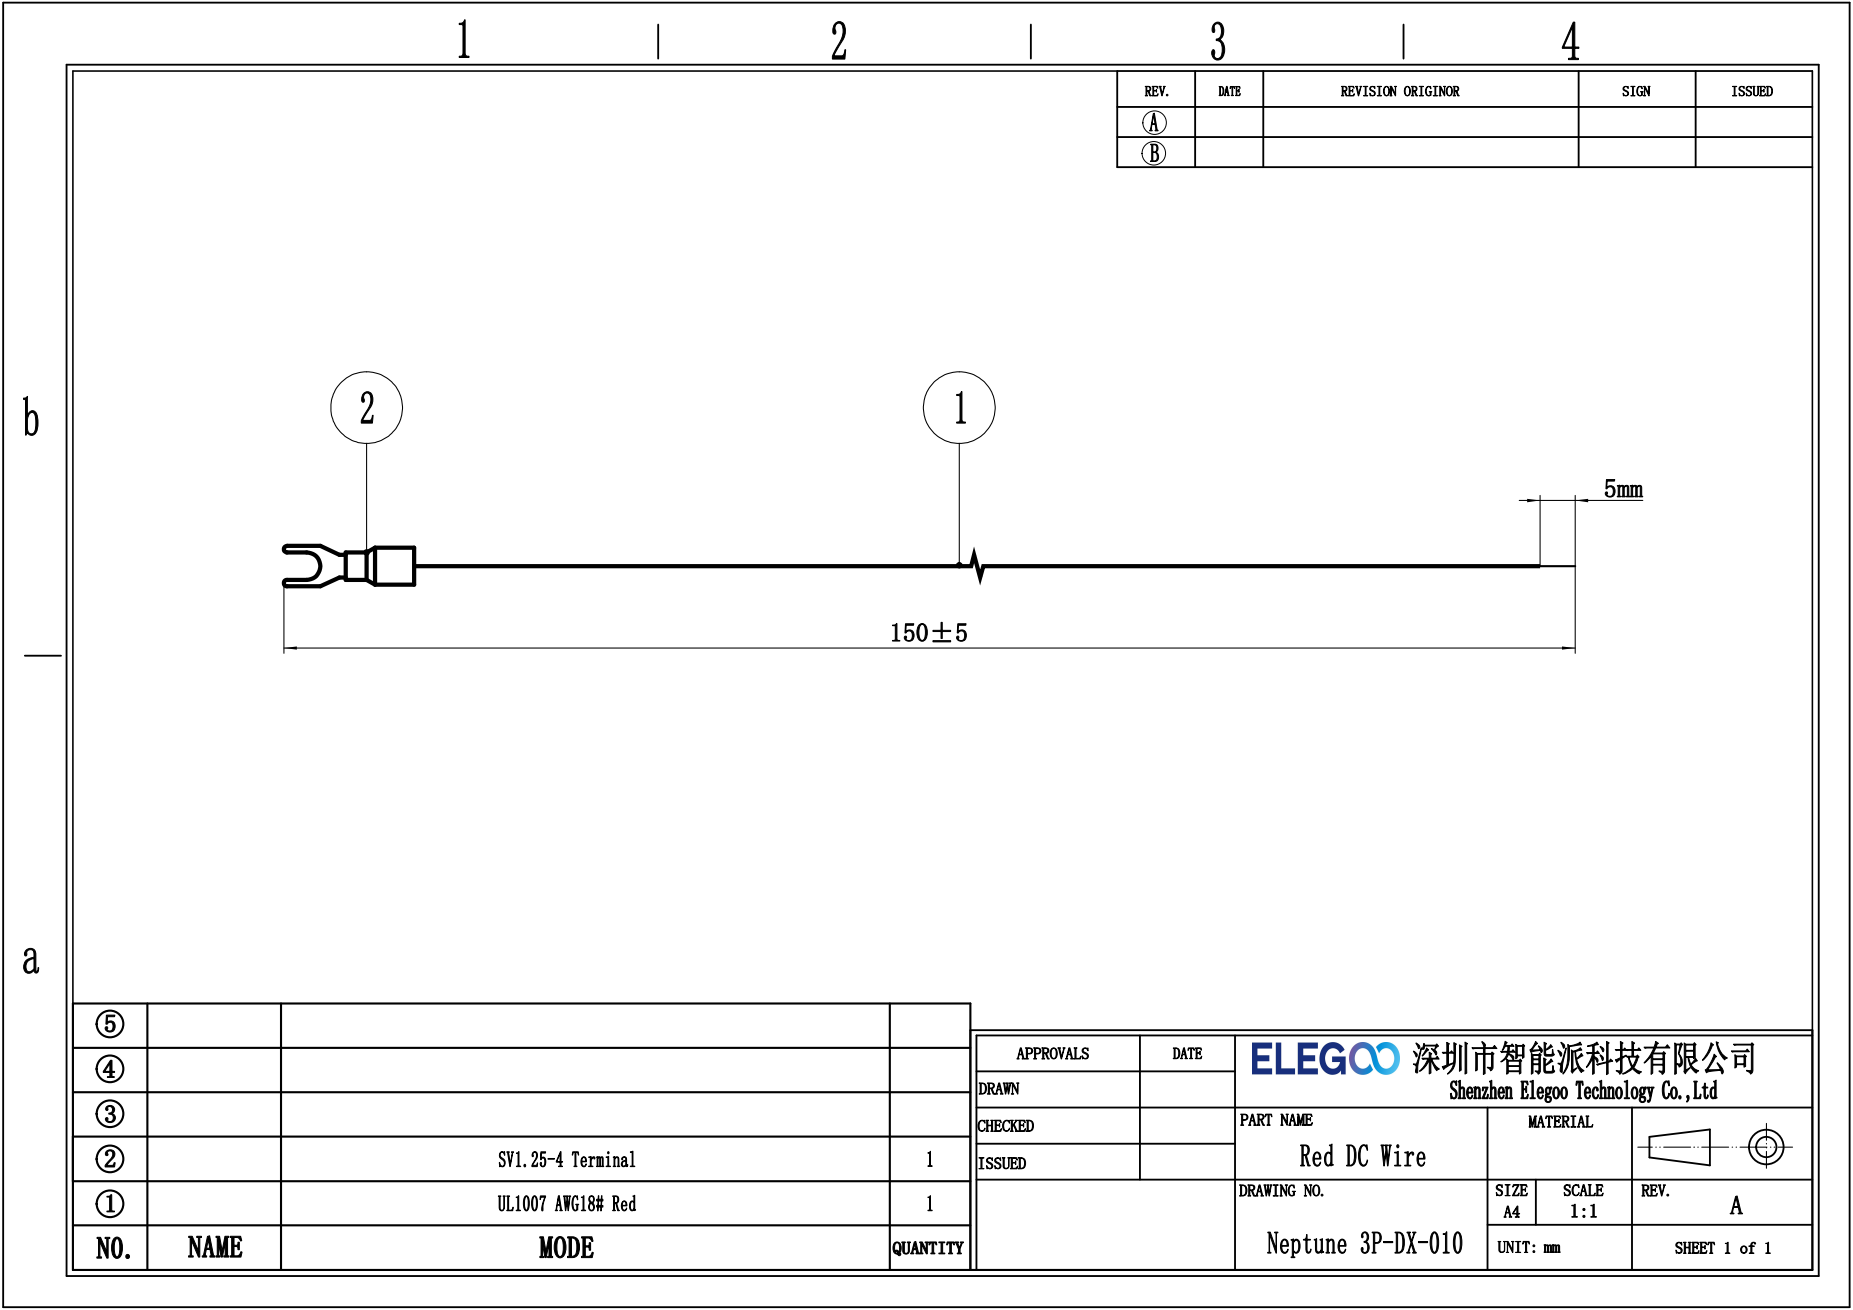
[picture p31: page 1]
