elegooofficial/neptune3pro/Wire/Red Silicone Wire(Switch).pdf

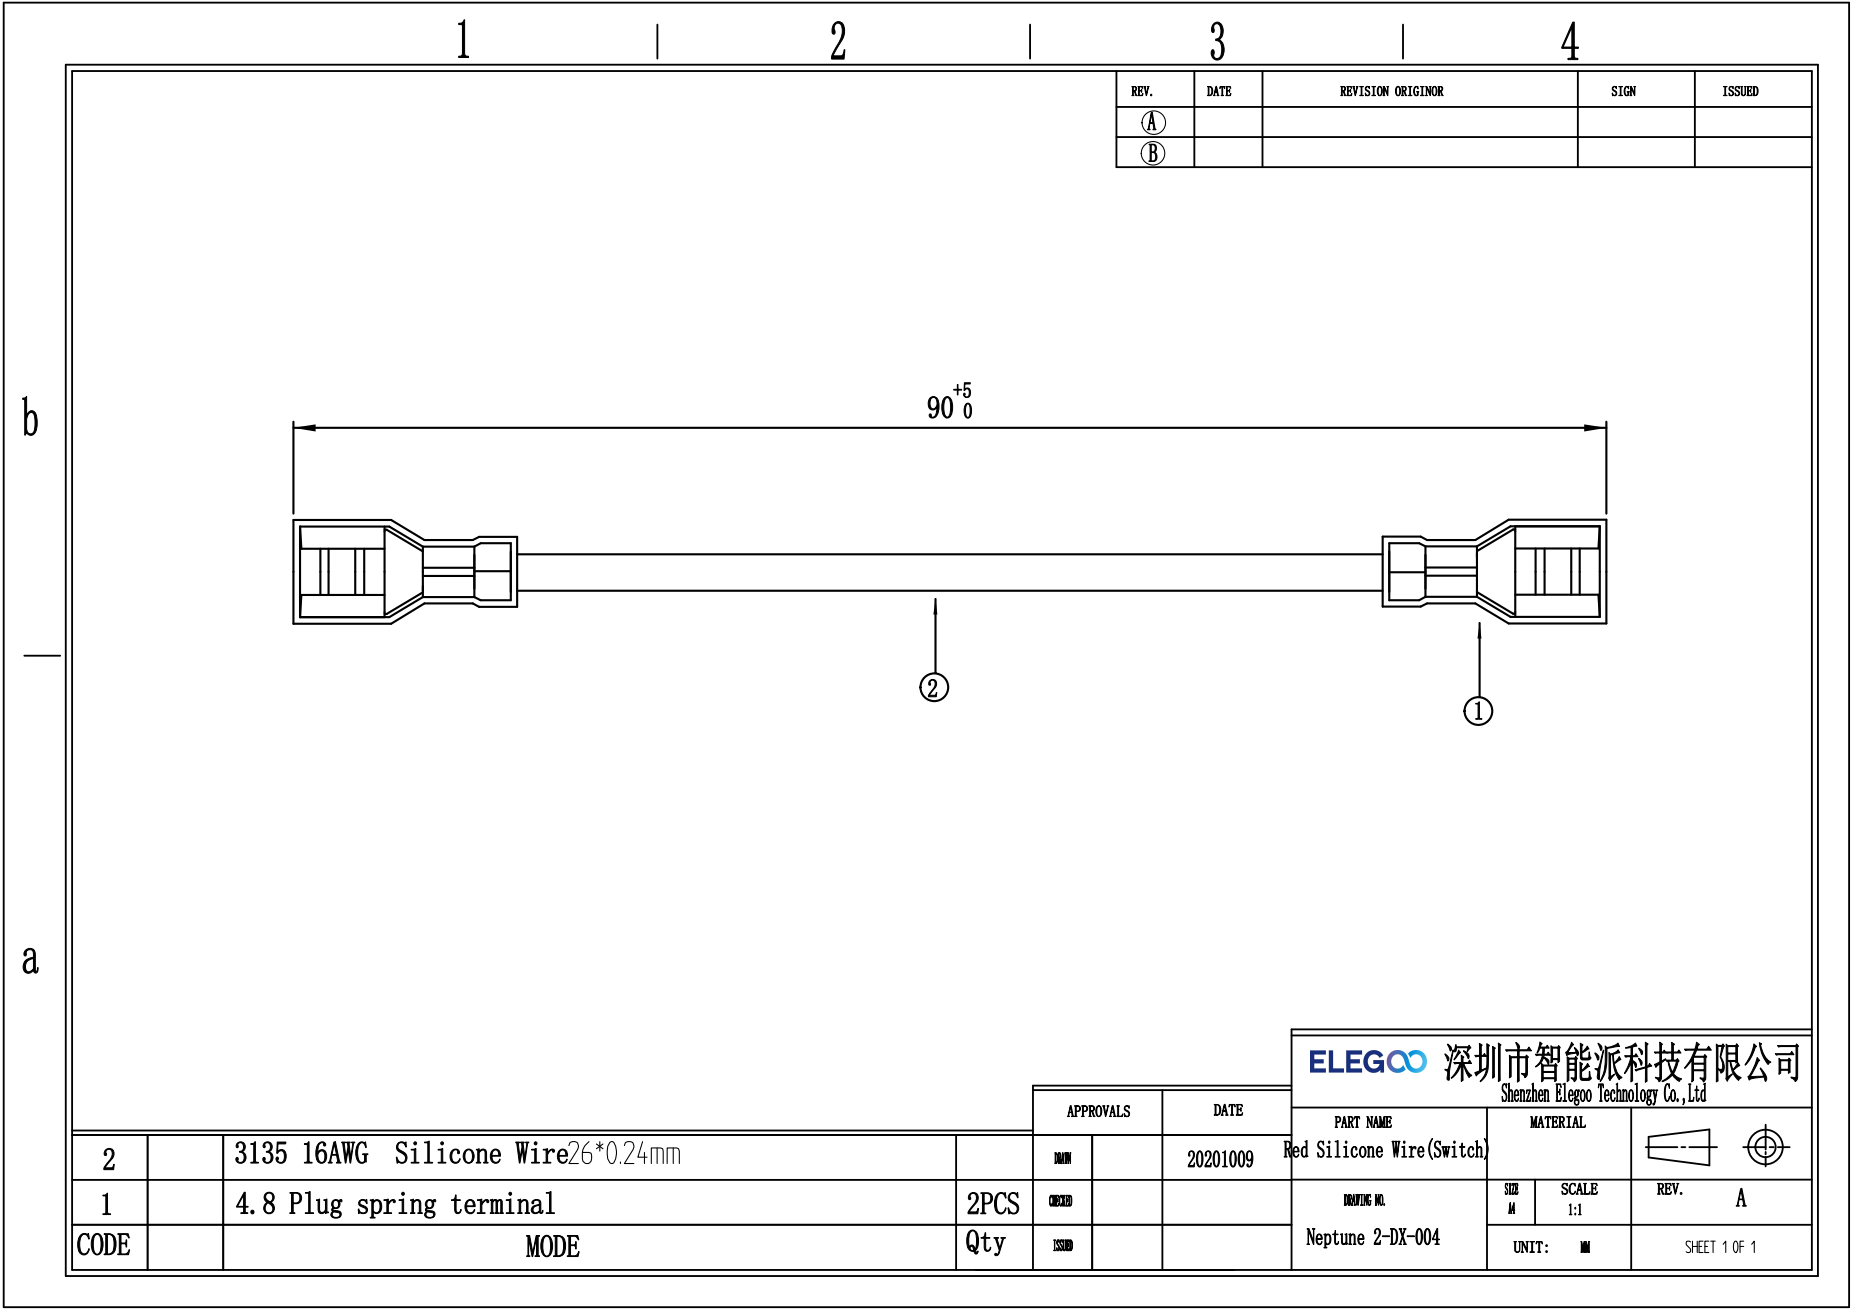
[picture p32: page 1]
