elegooofficial/neptune3pro/Wire/Red Silicone Wire.pdf

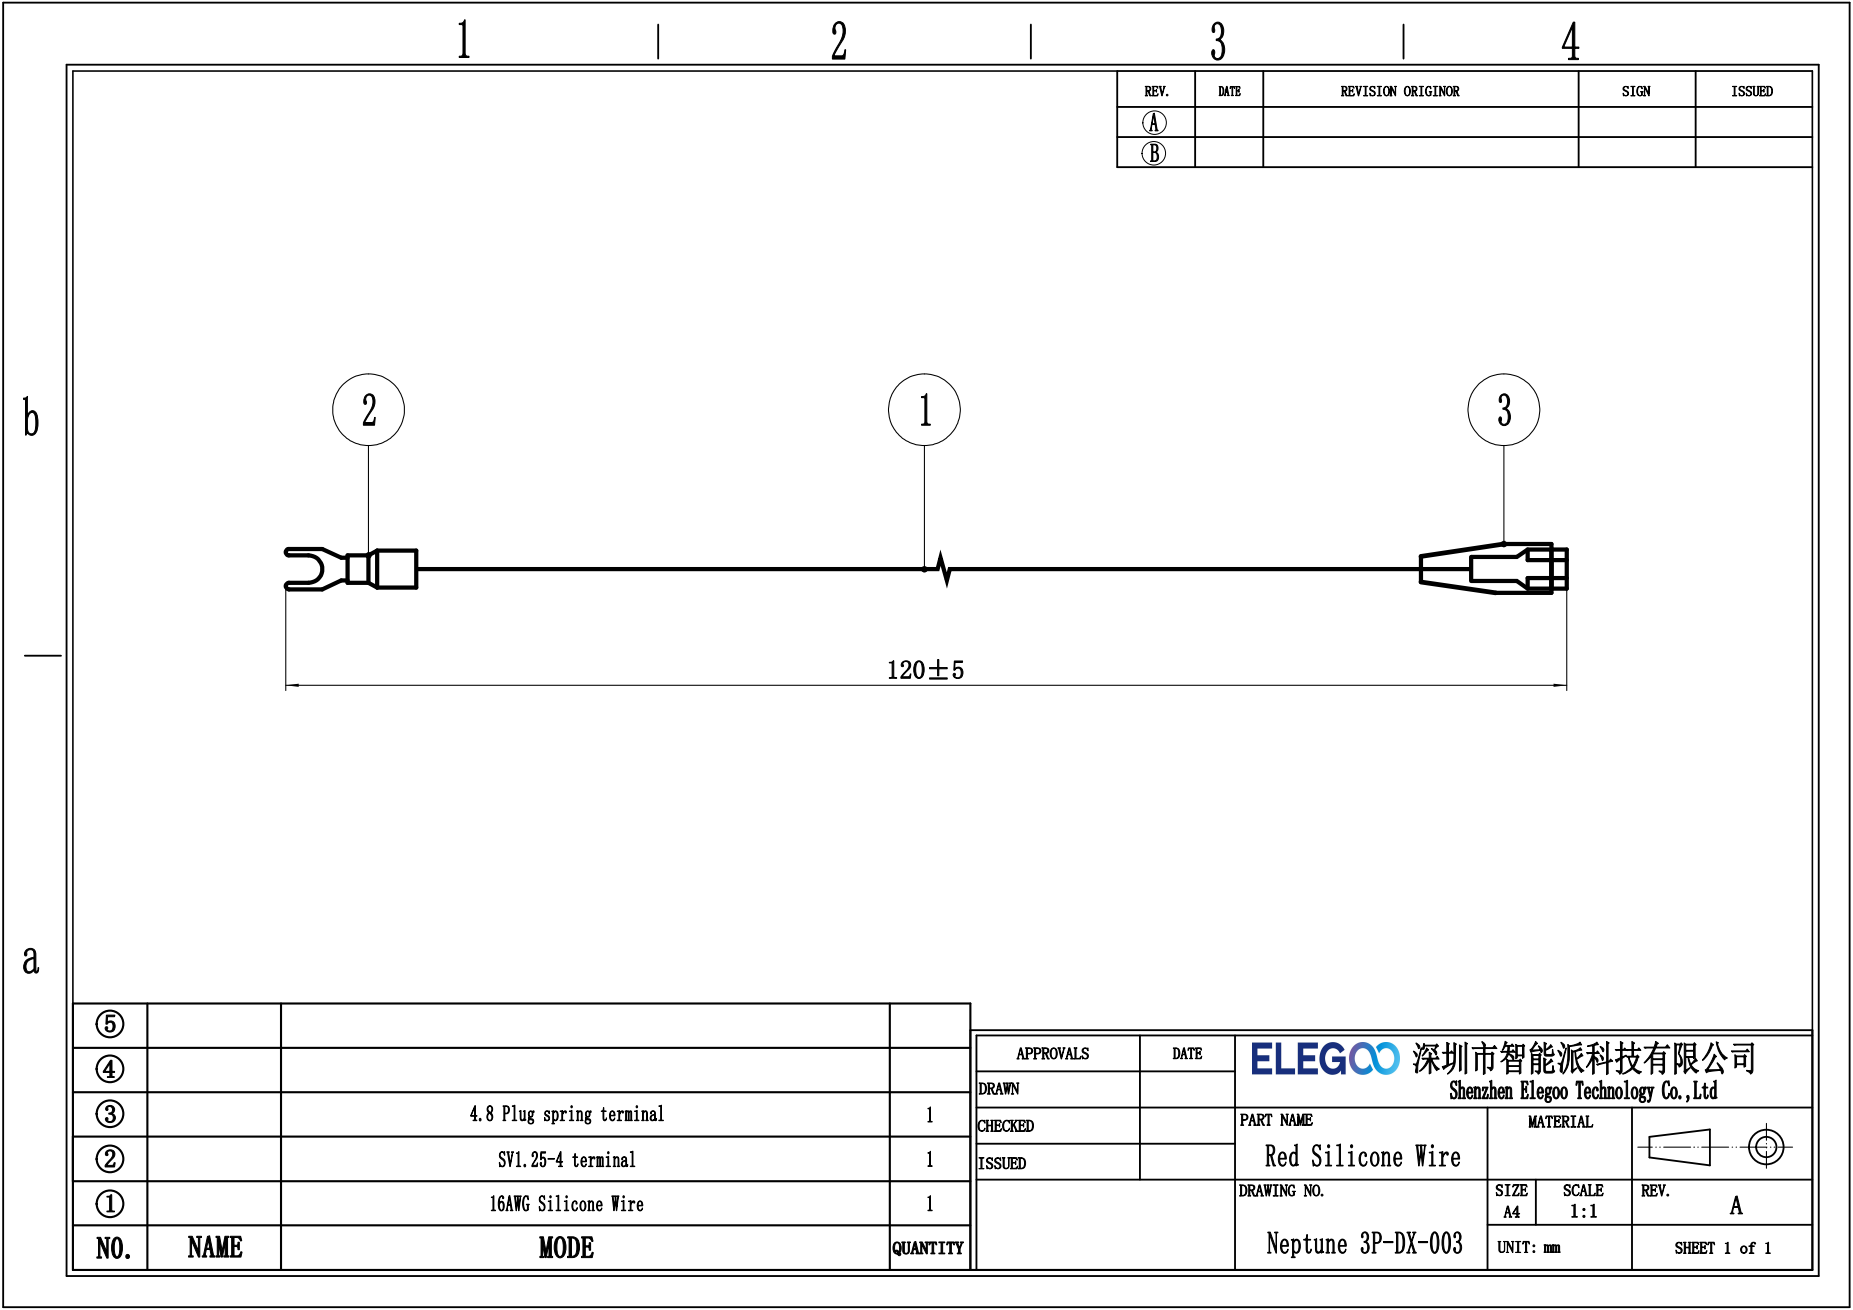
[picture p33: page 1]
