elegooofficial/neptune3pro/Wire/Stepper and limit switch wire_X-axis.pdf

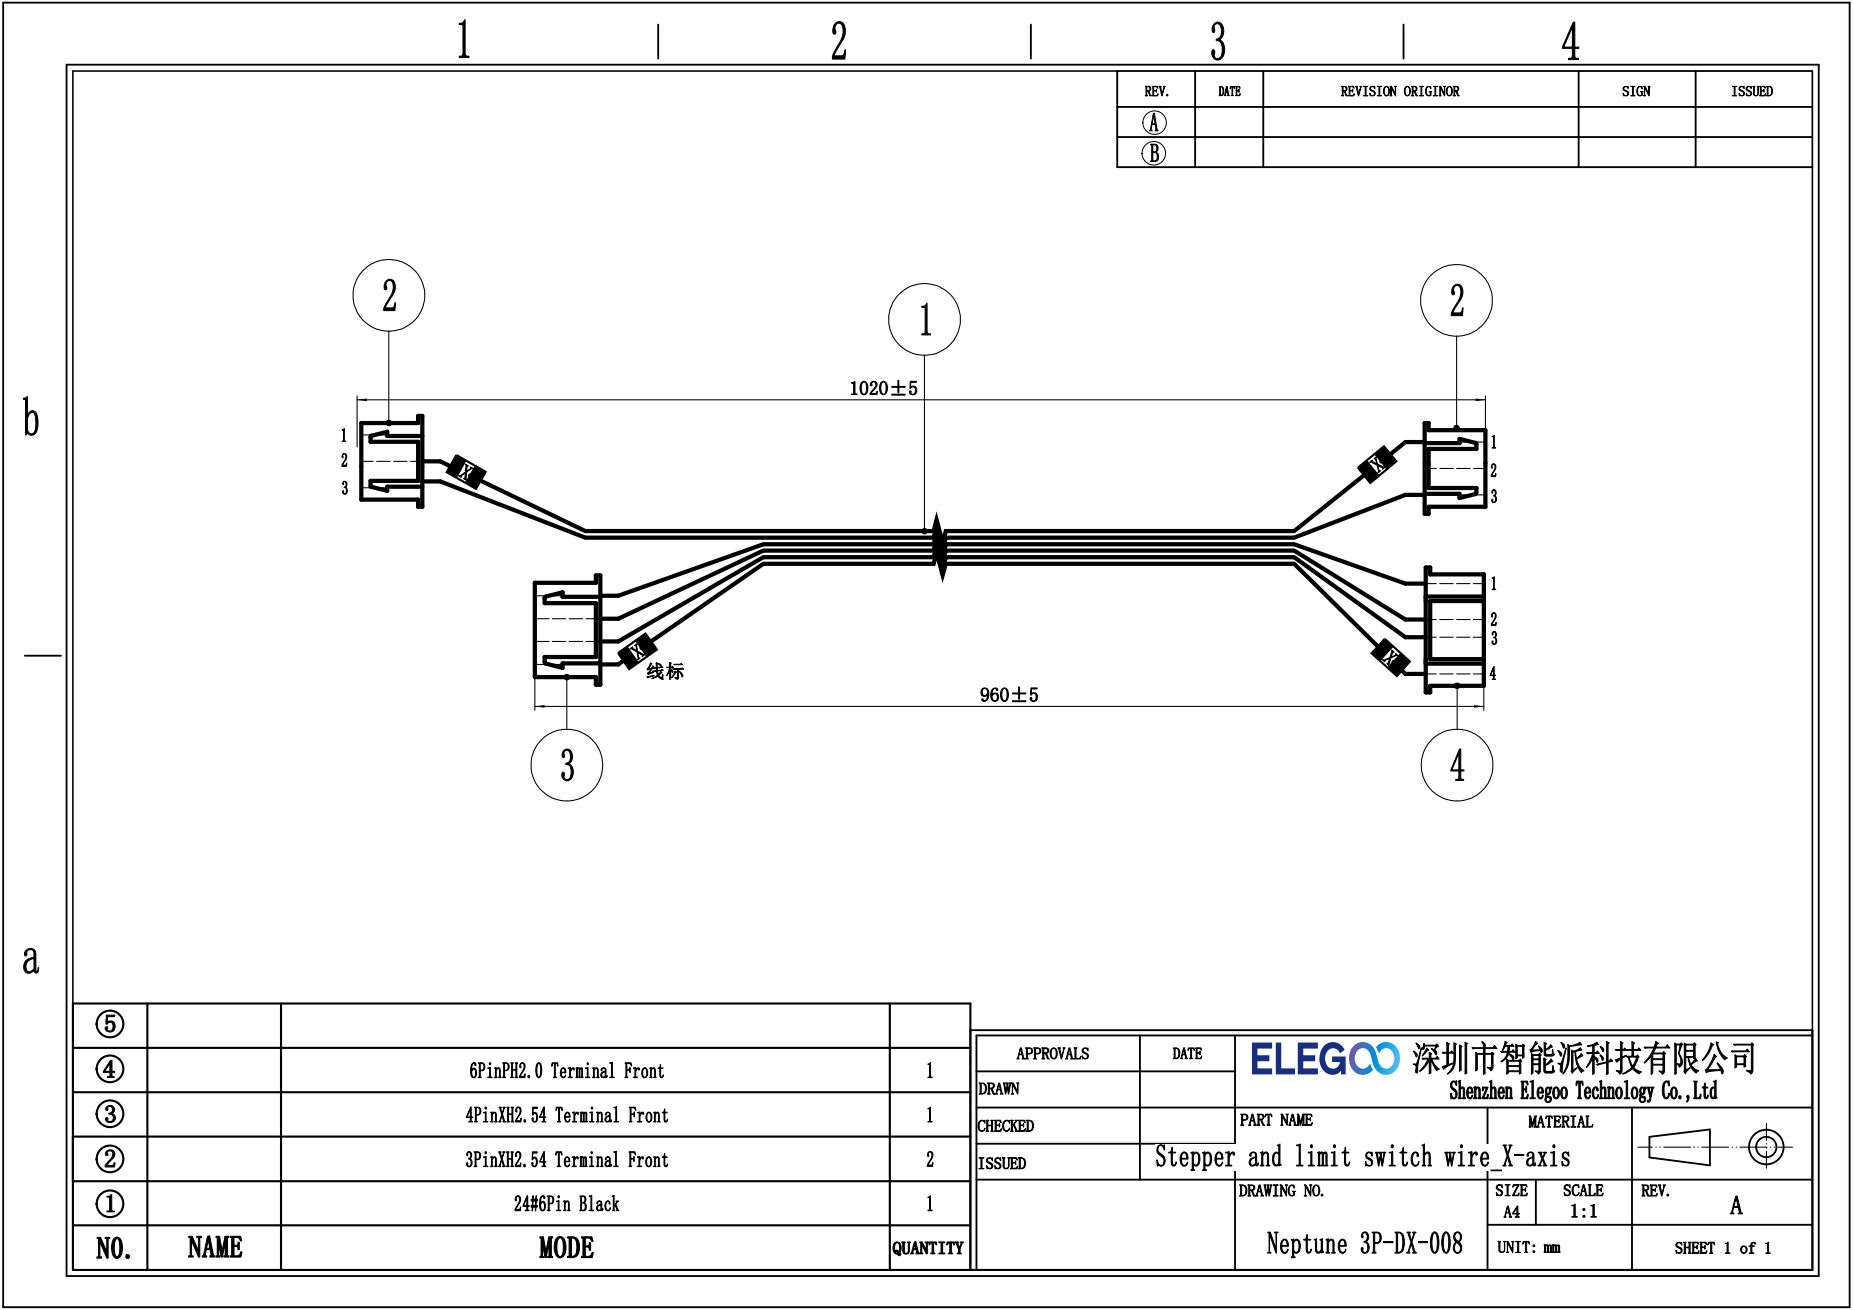
[picture p34: page 1]
