elegooofficial/neptune3pro/Wire/stepper and limit switch wire_Y-axis.pdf

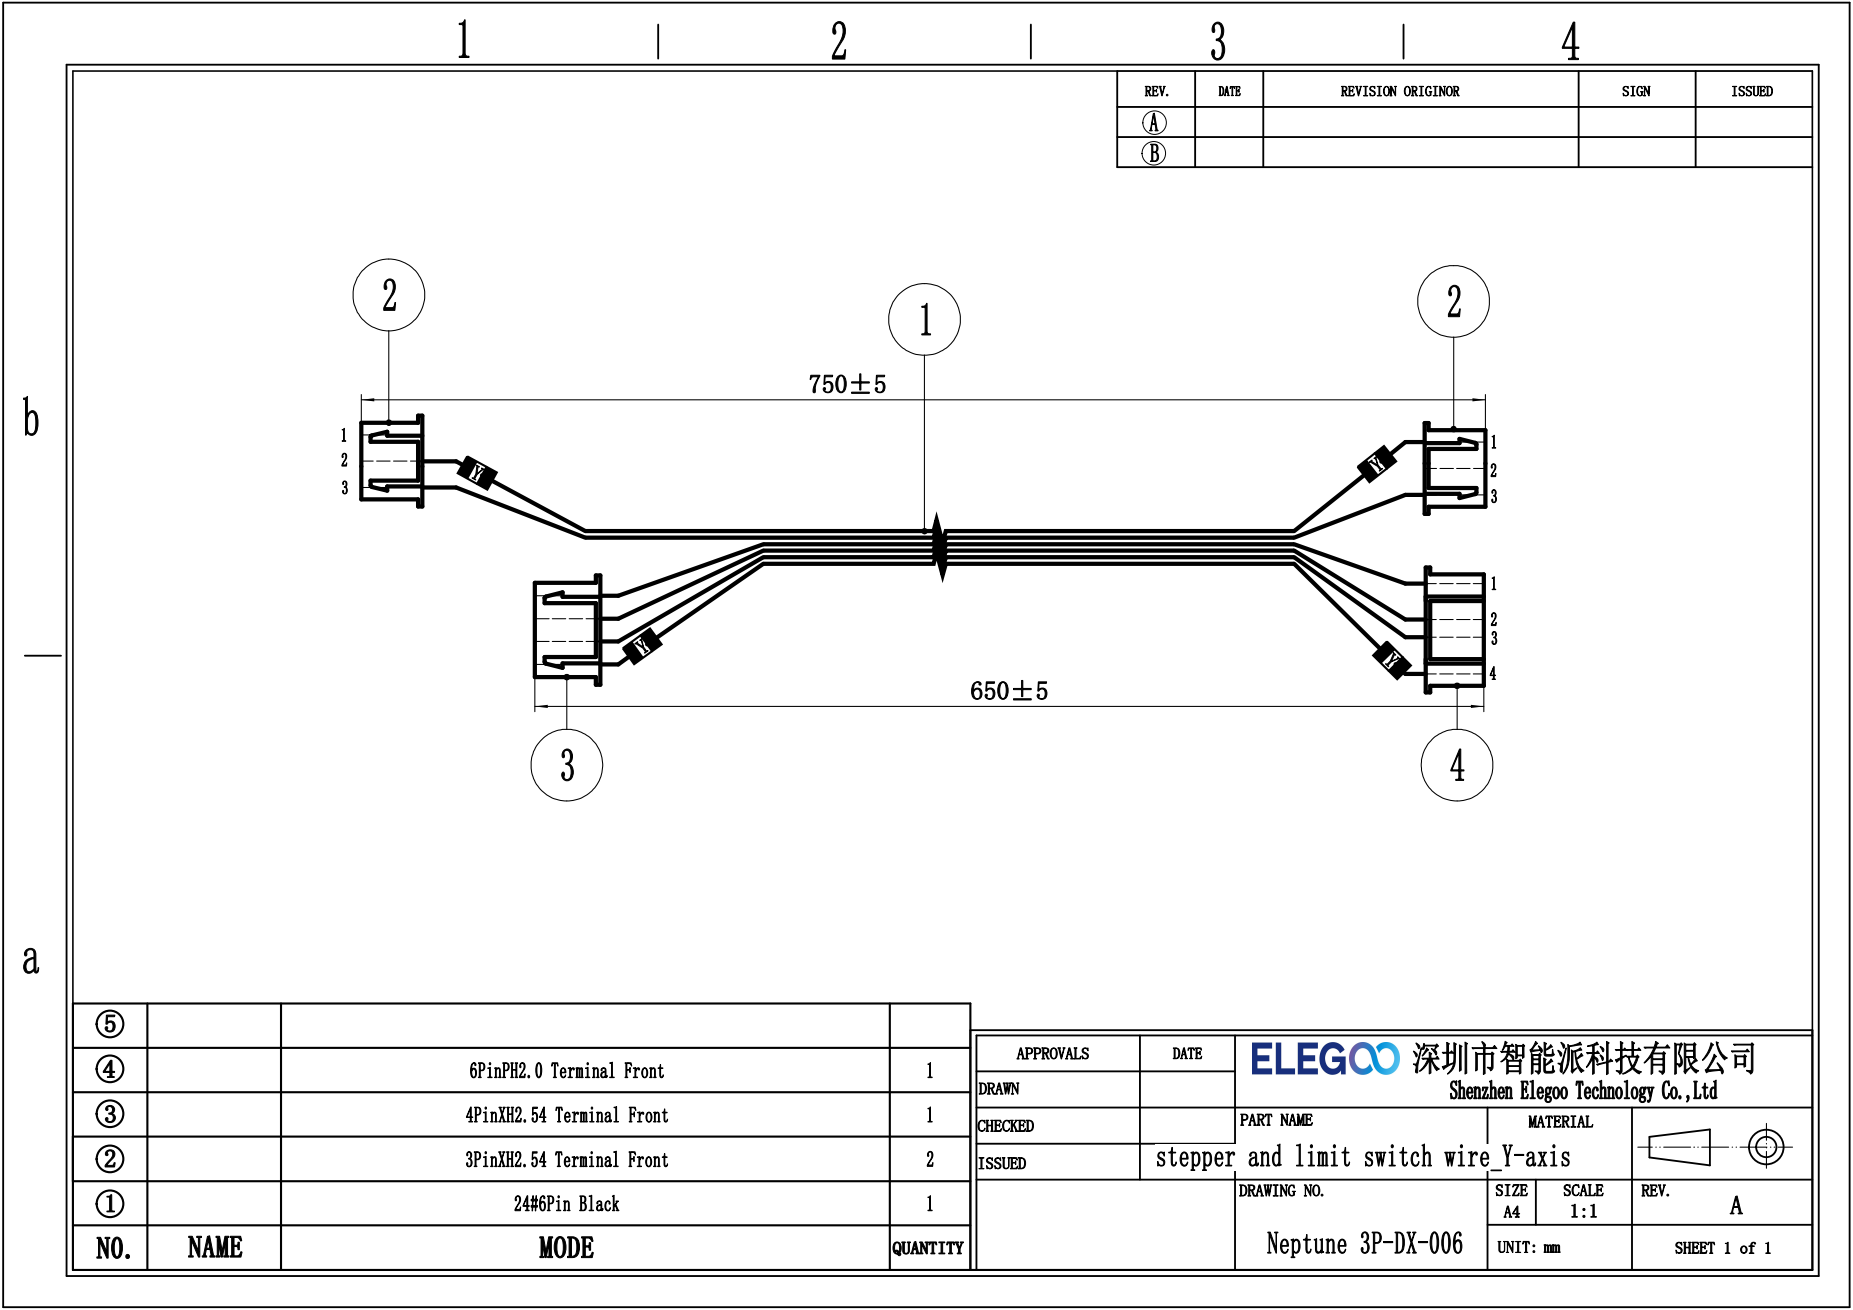
[picture p35: page 1]
