elegooofficial/neptune3pro/Wire/Stepper wire_Z-axis.pdf

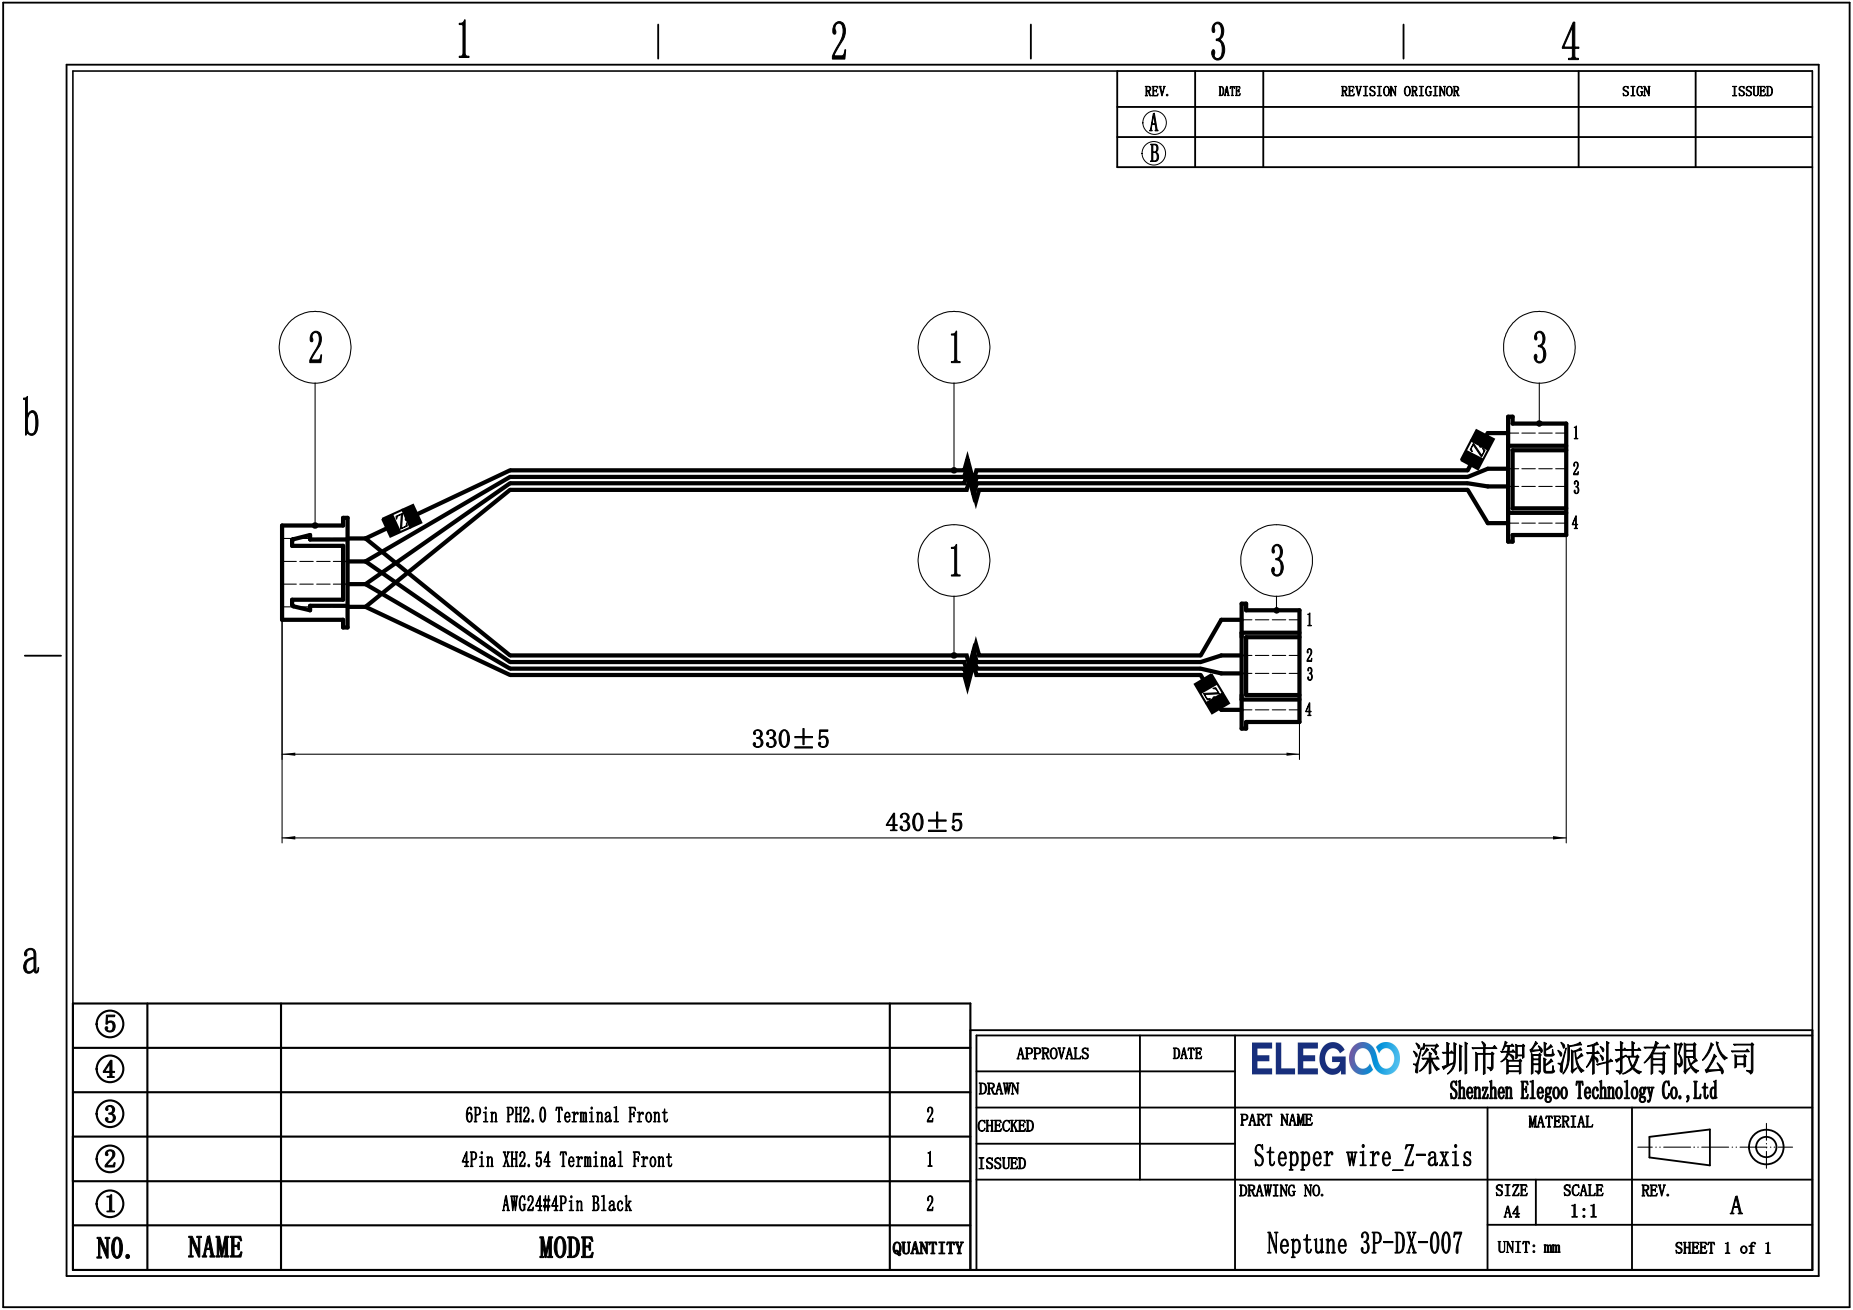
[picture p36: page 1]
