elegooofficial/neptune3pro/Wire/Thermistor_Heated Bed.pdf

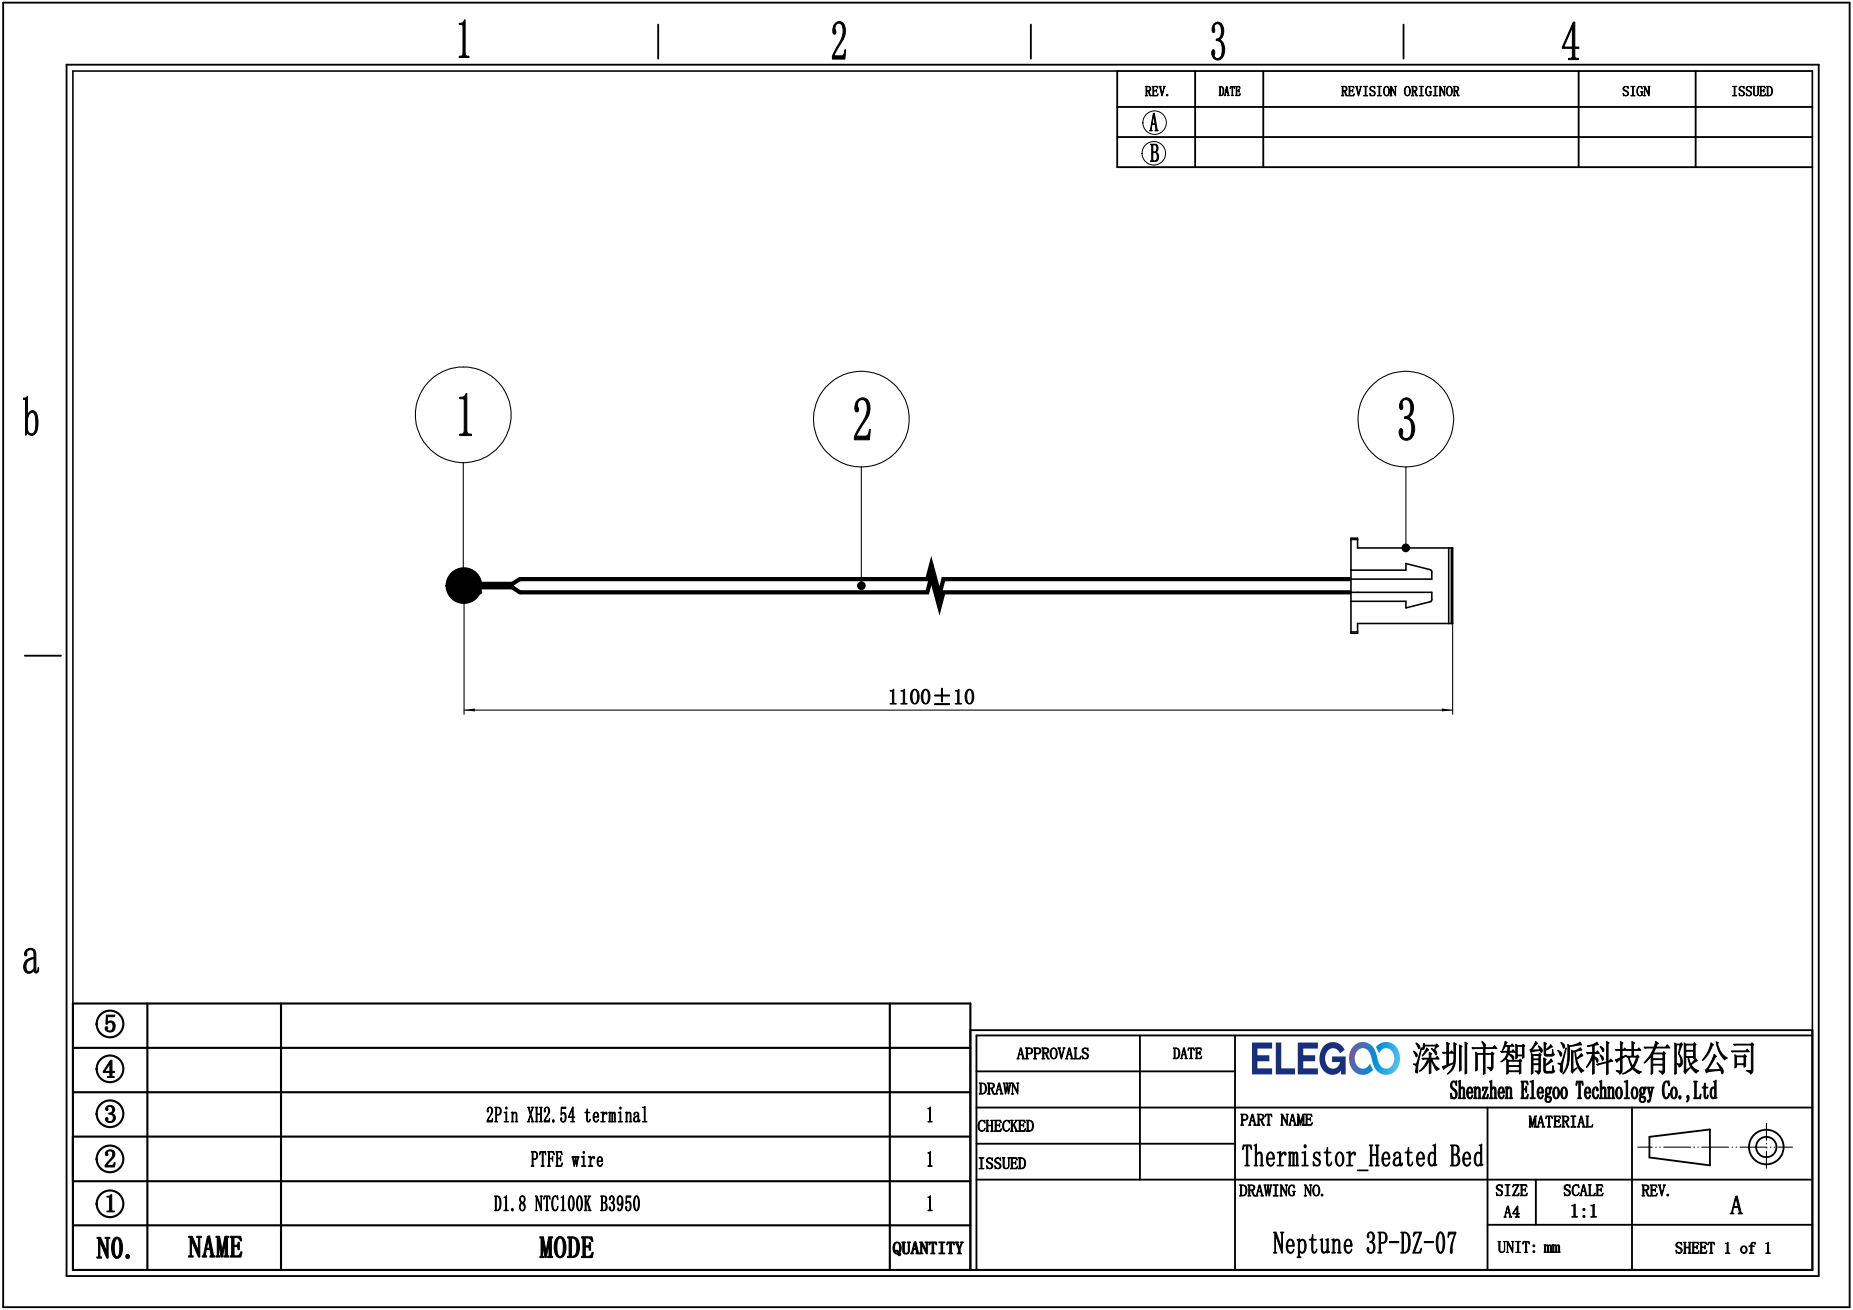
[picture p37: page 1]
