elegooofficial/neptune3pro/Wire/Thermistor_Nozzle.pdf

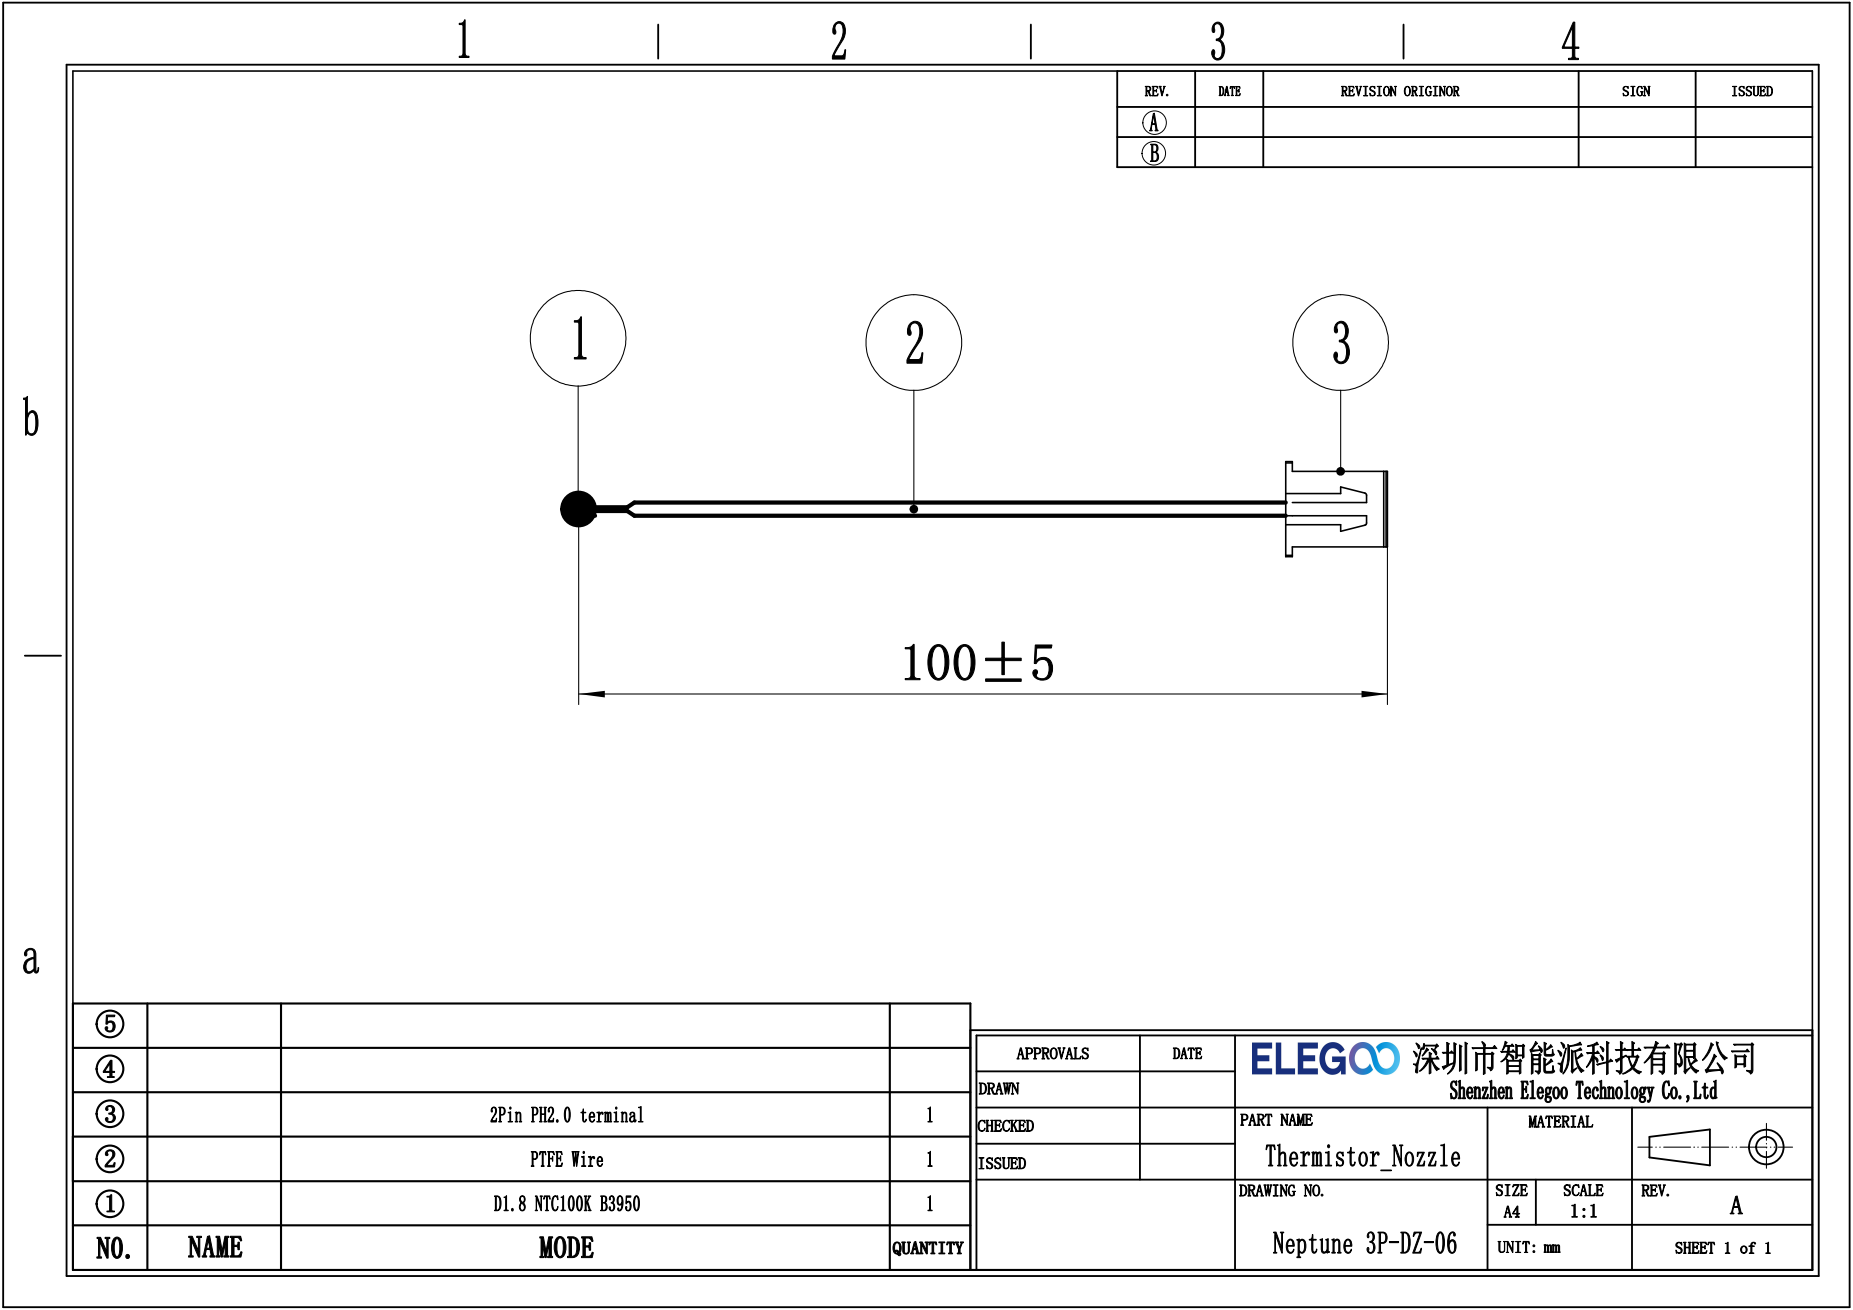
[picture p38: page 1]
