elegooofficial/neptune3pro/PCBA/Extruder PCBA/Extruder _sch.pdf

D

6 | 5 | 4 | 3 | 2 | 1

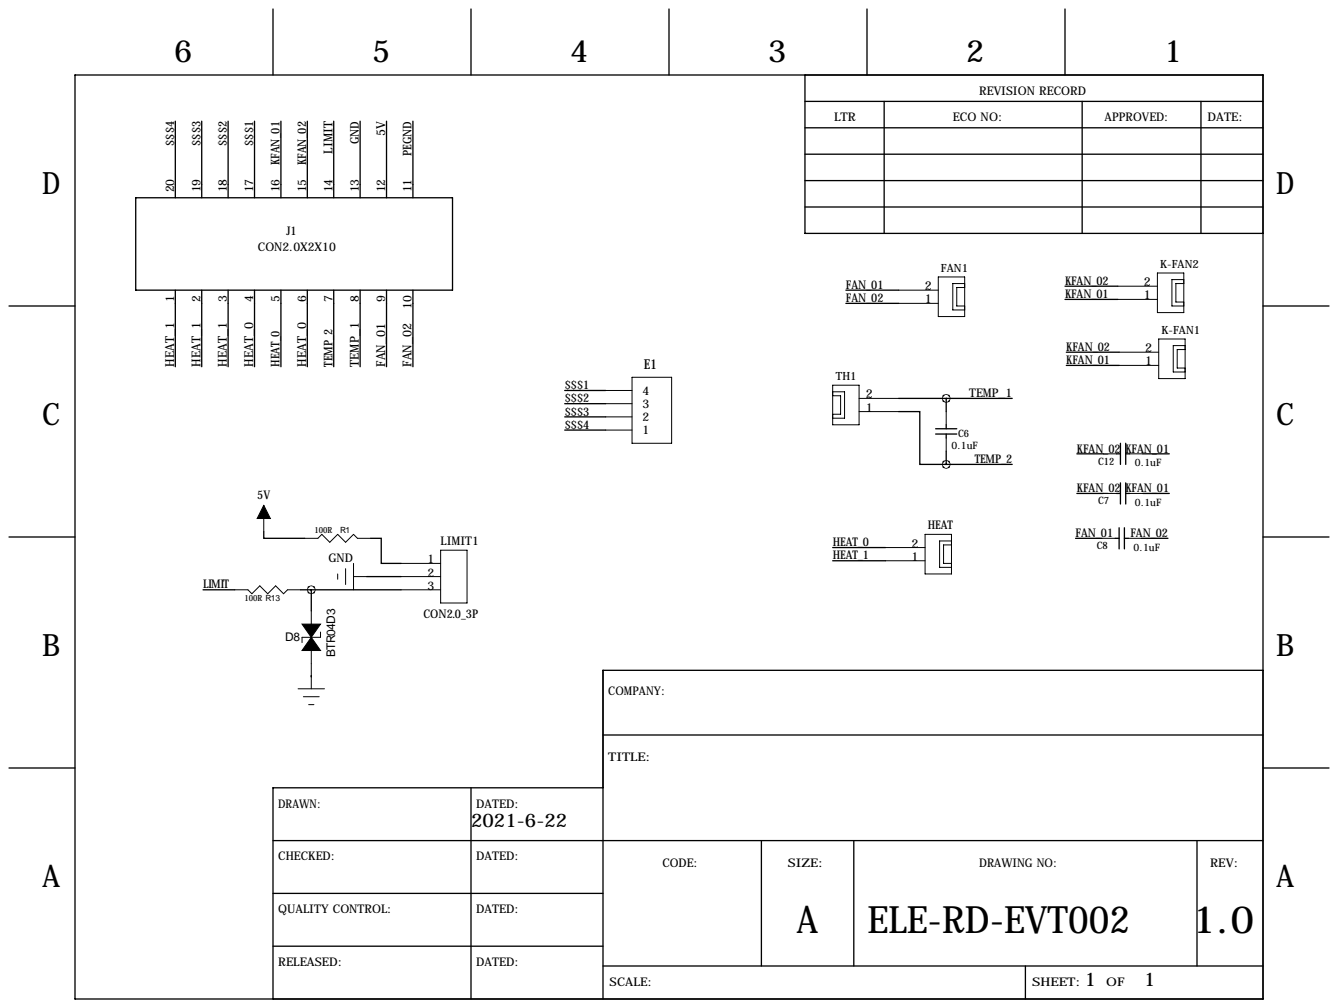
[picture p39: page 1]

REVISION RECORD

LTR | ECO NO: | APPROVED: | DATE:

DRAWN: | DATED: 2021-6-22

CHECKED: | DATED: | CODE: | SIZE: A | DRAWING NO: ELE-RD-EVT002 1.0 | REV:

QUALITY CONTROL: | DATED:

RELEASED: | DATED:

SCALE: | 1 1 SHEET: OF
