elegooofficial/neptune3pro/PCBA/Filament detector/Filament detector_sch.pdf

D

6 | 5 | 4 | 3 | 2 | 1

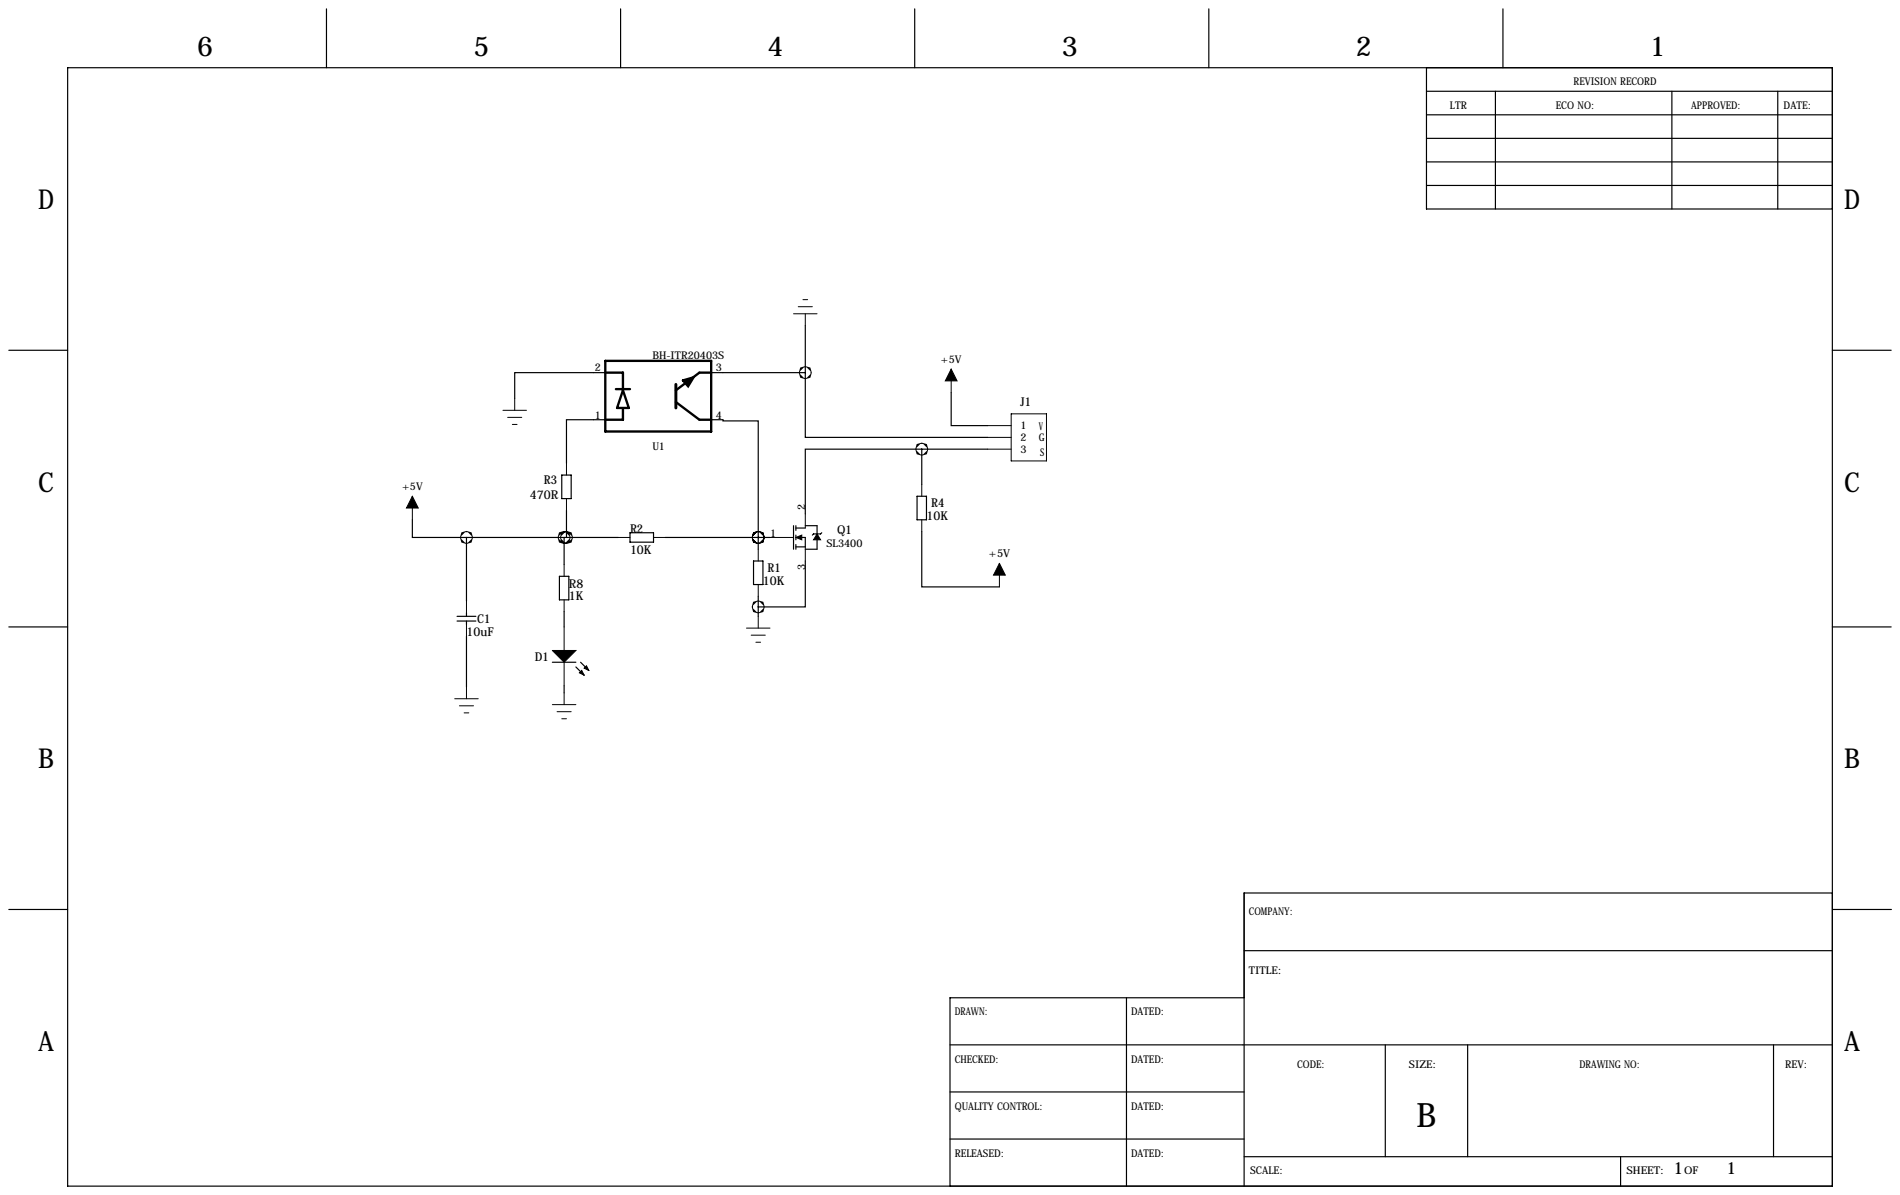
[picture p44: page 1]

REVISION RECORD

LTR | ECO NO: | APPROVED: | DATE:

DRAWN: | DATED:
CHECKED: | DATED: | CODE: | SIZE: B | DRAWING NO: | REV:

QUALITY CONTROL: | DATED:

RELEASED: | DATED:

SCALE: | 1 1 SHEET: OF
