elegooofficial/neptune3pro/PCBA/LCD/TJC4827X243_011_Z05-V1.1-PCB.pdf

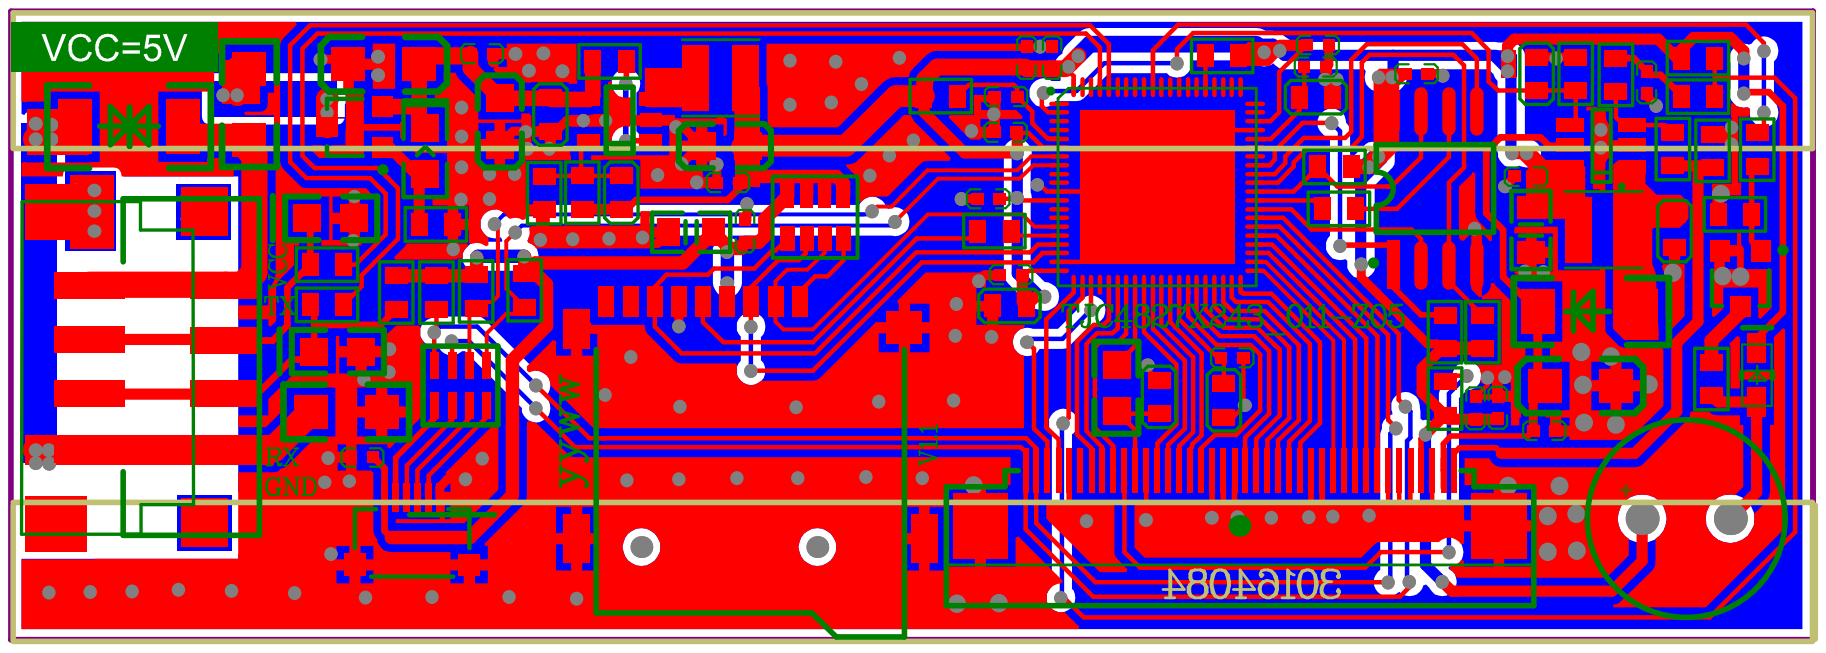
[picture p45: page 1]
