elegooofficial/neptune3pro/PCBA/Limit Switch/Y-axis limit switch PCB.pdf

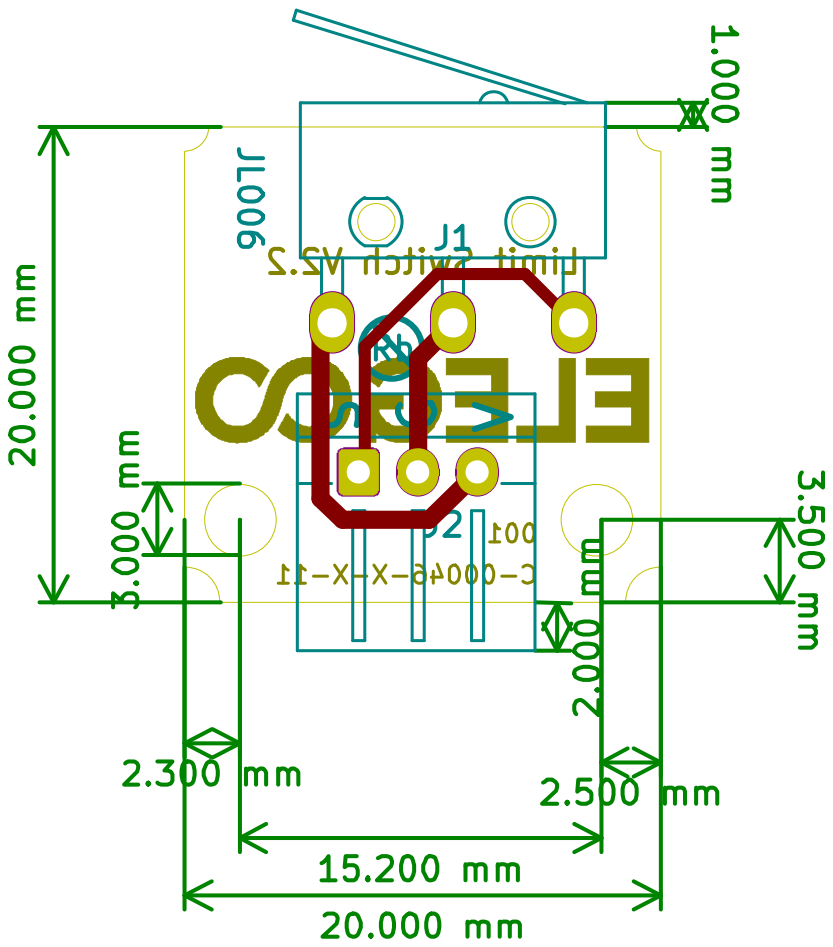
[picture p47: page 1]
