elegooofficial/neptune3pro/PCBA/Mainboard/ZNP Robin Nano_DW V2.2_001 PCB/ZNP Robin Nano-B_Mask.pdf

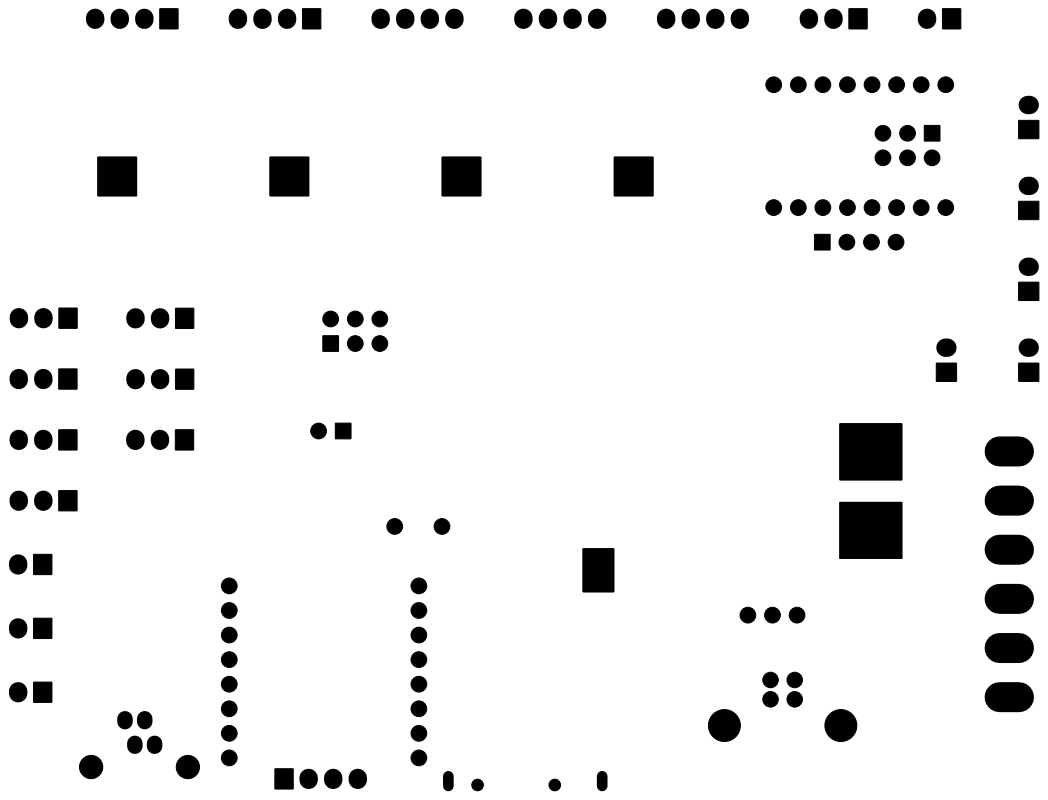
[picture p48: page 1]
