elegooofficial/neptune3pro/PCBA/Mainboard/ZNP Robin Nano_DW V2.2_001 PCB/ZNP Robin Nano-BOTTOM_Cu.pdf

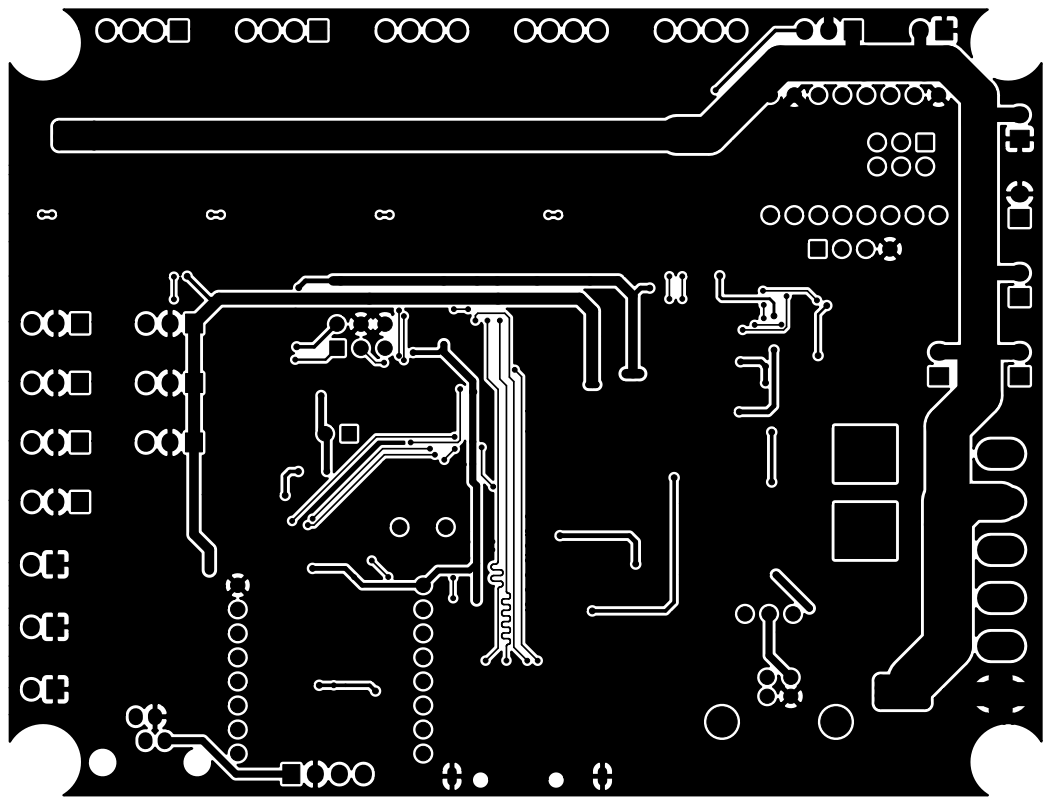
[picture p49: page 1]
