elegooofficial/neptune3pro/PCBA/Mainboard/ZNP Robin Nano_DW V2.2_001 PCB/ZNP Robin Nano-F_Mask.pdf

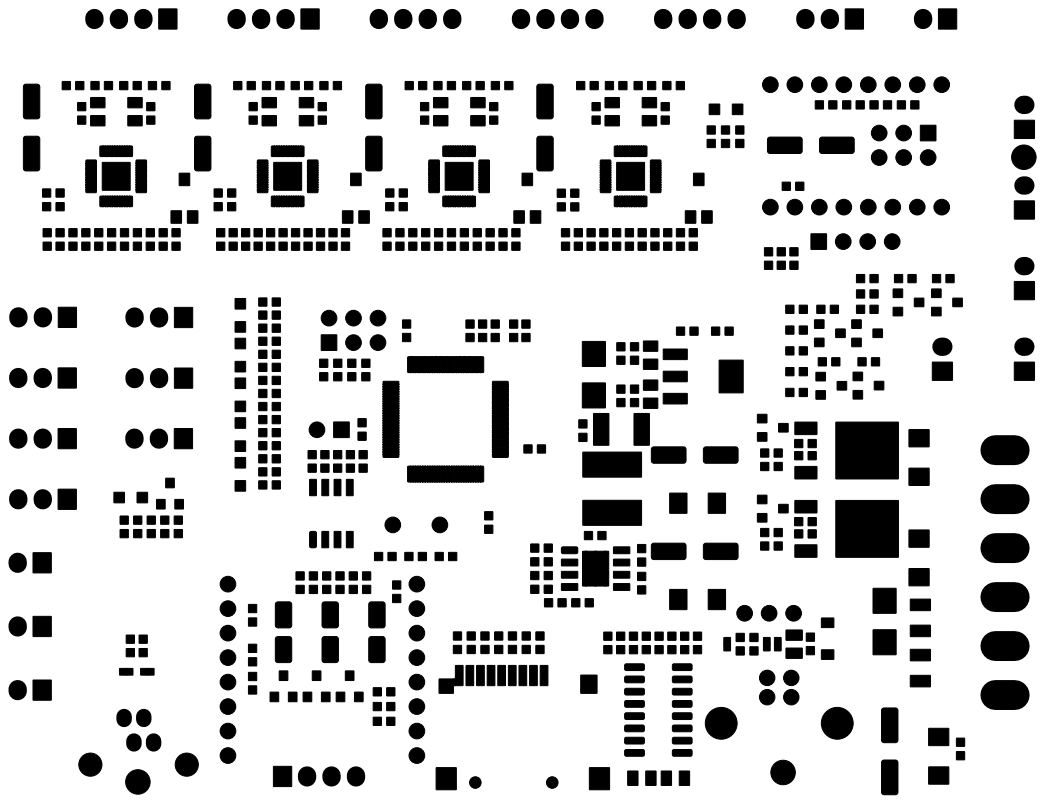
[picture p50: page 1]
