elegooofficial/neptune3pro/Firmware/Mainboard/Marlin-2.1.1_TJC_029/Marlin-2.1.1_TJC_029/Marlin/Configuration.h

#pragma once
#define CONFIGURATION_H_VERSION 02010100
#define STRING_CONFIG_H_AUTHOR "(none, default config)" // Who made the changes.
#define SHOW_BOOTSCREEN
#define RTS_AVAILABLE
#define TJC_AVAILABLE
  #define MOTHERBOARD BOARD_MKS_E3D_V2
    #define NEPTUNE_3_PRO      1
#define SERIAL_PORT 1
#define BAUDRATE 115200
#define X_DRIVER_TYPE  A4988
#define Y_DRIVER_TYPE  A4988
#define Z_DRIVER_TYPE  A4988
#define E0_DRIVER_TYPE A4988
#define EXTRUDERS 1
#define DEFAULT_NOMINAL_FILAMENT_DIA 1.75
#define TEMP_SENSOR_0 1
#define TEMP_SENSOR_1 0
#define TEMP_SENSOR_2 0
#define TEMP_SENSOR_3 0
#define TEMP_SENSOR_4 0
#define TEMP_SENSOR_5 0
#define TEMP_SENSOR_6 0
#define TEMP_SENSOR_7 0
#define TEMP_SENSOR_BED 1
#define TEMP_SENSOR_PROBE 0
#define TEMP_SENSOR_CHAMBER 0
#define TEMP_SENSOR_COOLER 0
#define TEMP_SENSOR_BOARD 0
#define TEMP_SENSOR_REDUNDANT 0
#define DUMMY_THERMISTOR_998_VALUE  25
#define DUMMY_THERMISTOR_999_VALUE 100
#if TEMP_SENSOR_IS_MAX_TC(0)
  #define MAX31865_SENSOR_OHMS_0      100 // (Ω) Typically 100 or 1000 (PT100 or PT1000)
  #define MAX31865_CALIBRATION_OHMS_0 430 // (Ω) Typically 430 for Adafruit PT100; 4300 for Adafruit PT1000
#endif
#if TEMP_SENSOR_IS_MAX_TC(1)
  #define MAX31865_SENSOR_OHMS_1      100
  #define MAX31865_CALIBRATION_OHMS_1 430
#endif
#if HAS_E_TEMP_SENSOR
  #define TEMP_RESIDENCY_TIME         10  // (seconds) Time to wait for hotend to "settle" in M109
  #define TEMP_WINDOW                  1  // (°C) Temperature proximity for the "temperature reached" timer
  #define TEMP_HYSTERESIS              3  // (°C) Temperature proximity considered "close enough" to the target
#endif
#if TEMP_SENSOR_BED
  #define TEMP_BED_RESIDENCY_TIME     10  // (seconds) Time to wait for bed to "settle" in M190
  #define TEMP_BED_WINDOW              1  // (°C) Temperature proximity for the "temperature reached" timer
  #define TEMP_BED_HYSTERESIS          3  // (°C) Temperature proximity considered "close enough" to the target
#endif
#if TEMP_SENSOR_CHAMBER
  #define TEMP_CHAMBER_RESIDENCY_TIME 10  // (seconds) Time to wait for chamber to "settle" in M191
  #define TEMP_CHAMBER_WINDOW          1  // (°C) Temperature proximity for the "temperature reached" timer
  #define TEMP_CHAMBER_HYSTERESIS      3  // (°C) Temperature proximity considered "close enough" to the target
#endif
#if TEMP_SENSOR_REDUNDANT
  #define TEMP_SENSOR_REDUNDANT_SOURCE    E1  // The sensor that will provide the redundant reading.
  #define TEMP_SENSOR_REDUNDANT_TARGET    E0  // The sensor that we are providing a redundant reading for.
  #define TEMP_SENSOR_REDUNDANT_MAX_DIFF  10  // (°C) Temperature difference that will trigger a print abort.
#endif
#define HEATER_0_MINTEMP   5
#define HEATER_1_MINTEMP   5
#define HEATER_2_MINTEMP   5
#define HEATER_3_MINTEMP   5
#define HEATER_4_MINTEMP   5
#define HEATER_5_MINTEMP   5
#define HEATER_6_MINTEMP   5
#define HEATER_7_MINTEMP   5
#define BED_MINTEMP        5
#define CHAMBER_MINTEMP    5
#define HEATER_0_MAXTEMP 295
#define HEATER_1_MAXTEMP 275
#define HEATER_2_MAXTEMP 275
#define HEATER_3_MAXTEMP 275
#define HEATER_4_MAXTEMP 275
#define HEATER_5_MAXTEMP 275
#define HEATER_6_MAXTEMP 275
#define HEATER_7_MAXTEMP 275
#define BED_MAXTEMP      150
#define CHAMBER_MAXTEMP  60
#define HOTEND_OVERSHOOT 15   // (°C) Forbid temperatures over MAXTEMP - OVERSHOOT
#define BED_OVERSHOOT    10   // (°C) Forbid temperatures over MAXTEMP - OVERSHOOT
#define COOLER_OVERSHOOT  2   // (°C) Forbid temperatures closer than OVERSHOOT
#define PIDTEMP          // See the PID Tuning Guide at https://reprap.org/wiki/PID_Tuning
#define BANG_MAX 255     // Limits current to nozzle while in bang-bang mode; 255=full current
#define PID_MAX BANG_MAX // Limits current to nozzle while PID is active (see PID_FUNCTIONAL_RANGE below); 255=full current
#define PID_K1 0.95      // Smoothing factor within any PID loop
    #define DEFAULT_Kp   22.2
    #define DEFAULT_Ki   1.80
    #define DEFAULT_Kd  119.00
#define MAX_BED_POWER 255 // limits duty cycle to bed; 255=full current
#define MAX_CHAMBER_POWER 255 // limits duty cycle to chamber heater; 255=full current
  #define PID_FUNCTIONAL_RANGE 10 // If the temperature difference between the target temperature and the actual temperature
#define PREVENT_COLD_EXTRUSION
#define EXTRUDE_MINTEMP 170
#define PREVENT_LENGTHY_EXTRUDE
#define EXTRUDE_MAXLENGTH 200
#define THERMAL_PROTECTION_HOTENDS // Enable thermal protection for all extruders
#define THERMAL_PROTECTION_BED     // Enable thermal protection for the heated bed
#define USE_XMIN_PLUG
#define USE_YMIN_PLUG
#define USE_ZMIN_PLUG
#define ENDSTOPPULLUPS
#define X_MIN_ENDSTOP_INVERTING false // Set to true to invert the logic of the endstop.
#define Y_MIN_ENDSTOP_INVERTING false // Set to true to invert the logic of the endstop.
#define Z_MIN_ENDSTOP_INVERTING false // Set to true to invert the logic of the endstop.
#define I_MIN_ENDSTOP_INVERTING false // Set to true to invert the logic of the endstop.
#define J_MIN_ENDSTOP_INVERTING false // Set to true to invert the logic of the endstop.
#define K_MIN_ENDSTOP_INVERTING false // Set to true to invert the logic of the endstop.
#define U_MIN_ENDSTOP_INVERTING false // Set to true to invert the logic of the endstop.
#define V_MIN_ENDSTOP_INVERTING false // Set to true to invert the logic of the endstop.
#define W_MIN_ENDSTOP_INVERTING false // Set to true to invert the logic of the endstop.
#define X_MAX_ENDSTOP_INVERTING false // Set to true to invert the logic of the endstop.
#define Y_MAX_ENDSTOP_INVERTING false // Set to true to invert the logic of the endstop.
#define Z_MAX_ENDSTOP_INVERTING false // Set to true to invert the logic of the endstop.
#define I_MAX_ENDSTOP_INVERTING false // Set to true to invert the logic of the endstop.
#define J_MAX_ENDSTOP_INVERTING false // Set to true to invert the logic of the endstop.
#define K_MAX_ENDSTOP_INVERTING false // Set to true to invert the logic of the endstop.
#define U_MAX_ENDSTOP_INVERTING false // Set to true to invert the logic of the endstop.
#define V_MAX_ENDSTOP_INVERTING false // Set to true to invert the logic of the endstop.
#define W_MAX_ENDSTOP_INVERTING false // Set to true to invert the logic of the endstop.
#define Z_MIN_PROBE_ENDSTOP_INVERTING false // Set to true to invert the logic of the probe.
#define DETECT_BROKEN_ENDSTOP
#if NEPTUNE_3_PRO
  #define DEFAULT_AXIS_STEPS_PER_UNIT   {80.00, 80.00, 400.00, 380.00}
#elif NEPTUNE_3_PLUS
  #define DEFAULT_AXIS_STEPS_PER_UNIT   {80.00, 80.00, 400.00, 390.00}
#elif NEPTUNE_3_MAX
  #define DEFAULT_AXIS_STEPS_PER_UNIT   {80.20, 80.20, 400.00, 390.00}
#endif
#define DEFAULT_MAX_FEEDRATE          { 300, 300, 5, 25 }
#if NEPTUNE_3_PRO
  #define DEFAULT_MAX_ACCELERATION      { 1100, 900, 100, 1500 }
#elif NEPTUNE_3_PLUS
  #define DEFAULT_MAX_ACCELERATION      { 700, 700, 100, 1000 }
#elif NEPTUNE_3_MAX
  #define DEFAULT_MAX_ACCELERATION      { 900, 500, 100, 1000 }
#endif
#define DEFAULT_ACCELERATION          3000    // X, Y, Z and E acceleration for printing moves
#define DEFAULT_RETRACT_ACCELERATION  3000    // E acceleration for retracts
#define DEFAULT_TRAVEL_ACCELERATION   3000    // X, Y, Z acceleration for travel (non printing) moves
#define CLASSIC_JERK
  #define DEFAULT_XJERK 10.0
  #define DEFAULT_YJERK 10.0
  #define DEFAULT_ZJERK  0.4
#define DEFAULT_EJERK    5.0  // May be used by Linear Advance
#define USE_PROBE_FOR_Z_HOMING
#define FIX_MOUNTED_PROBE
#define NOZZLE_TO_PROBE_OFFSET {-28.5, 22, 0 }
#if NEPTUNE_3_PRO
  #define PROBING_MARGIN 15
#elif NEPTUNE_3_PLUS
  #define PROBING_MARGIN 15
#elif NEPTUNE_3_MAX
  #define PROBING_MARGIN 33
#endif
#define XY_PROBE_FEEDRATE (133*60)
#define Z_PROBE_FEEDRATE_FAST (4*60)
#define Z_PROBE_FEEDRATE_SLOW (Z_PROBE_FEEDRATE_FAST / 2)
#define Z_CLEARANCE_DEPLOY_PROBE   10 // Z Clearance for Deploy/Stow
#define Z_CLEARANCE_BETWEEN_PROBES  5 // Z Clearance between probe points
#define Z_CLEARANCE_MULTI_PROBE     5 // Z Clearance between multiple probes
#define Z_PROBE_LOW_POINT          -2 // Farthest distance below the trigger-point to go before stopping
#define Z_PROBE_OFFSET_RANGE_MIN -20
#define Z_PROBE_OFFSET_RANGE_MAX 20
#define X_ENABLE_ON 0
#define Y_ENABLE_ON 0
#define Z_ENABLE_ON 0
#define E_ENABLE_ON 0 // For all extruders
#define DISABLE_X false
#define DISABLE_Y false
#define DISABLE_Z false
#define DISABLE_E false             // Disable the extruder when not stepping
#define DISABLE_INACTIVE_EXTRUDER   // Keep only the active extruder enabled
#define INVERT_X_DIR false
#define INVERT_Y_DIR false
#define INVERT_Z_DIR true
#define INVERT_E0_DIR false
#define INVERT_E1_DIR false
#define INVERT_E2_DIR false
#define INVERT_E3_DIR false
#define INVERT_E4_DIR false
#define INVERT_E5_DIR false
#define INVERT_E6_DIR false
#define INVERT_E7_DIR false
#define X_HOME_DIR -1
#define Y_HOME_DIR -1
#define Z_HOME_DIR -1
#if NEPTUNE_3_PRO
  #define X_BED_SIZE 235
  #define Y_BED_SIZE 234
#elif NEPTUNE_3_PLUS
  #define X_BED_SIZE 330
  #define Y_BED_SIZE 330
#elif NEPTUNE_3_MAX
  #define X_BED_SIZE 430
  #define Y_BED_SIZE 430
#endif
#if NEPTUNE_3_PRO
  #define X_MIN_POS -5
  #define Y_MIN_POS 0
  #define Z_MIN_POS 0
  #define X_MAX_POS X_BED_SIZE
  #define Y_MAX_POS Y_BED_SIZE
  #define Z_MAX_POS 283
#elif NEPTUNE_3_PLUS
  #define X_MIN_POS -8.3
  #define Y_MIN_POS -1.3
  #define Z_MIN_POS 0
  #define X_MAX_POS X_BED_SIZE
  #define Y_MAX_POS Y_BED_SIZE
  #define Z_MAX_POS 410
#elif NEPTUNE_3_MAX
  #define X_MIN_POS 0
  #define Y_MIN_POS -6
  #define Z_MIN_POS 0
  #define X_MAX_POS X_BED_SIZE
  #define Y_MAX_POS Y_BED_SIZE
  #define Z_MAX_POS 506
#endif
#define MIN_SOFTWARE_ENDSTOPS
  #define MIN_SOFTWARE_ENDSTOP_X
  #define MIN_SOFTWARE_ENDSTOP_Y
  #define MIN_SOFTWARE_ENDSTOP_Z
  #define MIN_SOFTWARE_ENDSTOP_I
  #define MIN_SOFTWARE_ENDSTOP_J
  #define MIN_SOFTWARE_ENDSTOP_K
  #define MIN_SOFTWARE_ENDSTOP_U
  #define MIN_SOFTWARE_ENDSTOP_V
  #define MIN_SOFTWARE_ENDSTOP_W
#define MAX_SOFTWARE_ENDSTOPS
  #define MAX_SOFTWARE_ENDSTOP_X
  #define MAX_SOFTWARE_ENDSTOP_Y
  #define MAX_SOFTWARE_ENDSTOP_Z
  #define MAX_SOFTWARE_ENDSTOP_I
  #define MAX_SOFTWARE_ENDSTOP_J
  #define MAX_SOFTWARE_ENDSTOP_K
  #define MAX_SOFTWARE_ENDSTOP_U
  #define MAX_SOFTWARE_ENDSTOP_V
  #define MAX_SOFTWARE_ENDSTOP_W
#define AUTO_BED_LEVELING_BILINEAR
#define RESTORE_LEVELING_AFTER_G28
#define PREHEAT_BEFORE_LEVELING
  #define LEVELING_NOZZLE_TEMP 140   // (°C) Only applies to E0 at this time
  #define LEVELING_BED_TEMP     60
  #define ENABLE_LEVELING_FADE_HEIGHT
    #define DEFAULT_LEVELING_FADE_HEIGHT 2.0 // (mm) Default fade height.
  #define SEGMENT_LEVELED_MOVES
  #define LEVELED_SEGMENT_LENGTH 5.0 // (mm) Length of all segments (except the last one)
  #if NEPTUNE_3_PLUS
    #define GRID_MAX_POINTS_X 7
    #define GRID_MAX_POINTS_Y GRID_MAX_POINTS_X
  #elif NEPTUNE_3_PRO
    #define GRID_MAX_POINTS_X 6
    #define GRID_MAX_POINTS_Y GRID_MAX_POINTS_X
  #elif NEPTUNE_3_MAX
    #define GRID_MAX_POINTS_X 7
    #define GRID_MAX_POINTS_Y 9
  #endif
#define Z_PROBE_END_SCRIPT "G28 Z\nG1 F200 Z0.0"
#define Z_SAFE_HOMING
  #define Z_SAFE_HOMING_X_POINT X_CENTER  // X point for Z homing
  #define Z_SAFE_HOMING_Y_POINT Y_CENTER  // Y point for Z homing
#define HOMING_FEEDRATE_MM_M { (50*60), (50*60), (4*60) }
#define VALIDATE_HOMING_ENDSTOPS
#define SKEW_CORRECTION
  #define XY_DIAG_AC 282.8427124746
  #define XY_DIAG_BD 282.8427124746
  #define XY_SIDE_AD 200
  #define XY_SKEW_FACTOR 0.0
  #define SKEW_CORRECTION_FOR_Z
    #define XZ_DIAG_AC 282.8427124746
    #define XZ_DIAG_BD 282.8427124746
    #define YZ_DIAG_AC 282.8427124746
    #define YZ_DIAG_BD 282.8427124746
    #define YZ_SIDE_AD 200
    #define XZ_SKEW_FACTOR 0.0
    #define YZ_SKEW_FACTOR 0.0
  #define SKEW_CORRECTION_GCODE
#define EEPROM_SETTINGS     // Persistent storage with M500 and M501
#define EEPROM_CHITCHAT       // Give feedback on EEPROM commands. Disable to save PROGMEM.
#define EEPROM_BOOT_SILENT    // Keep M503 quiet and only give errors during first load
  #define EEPROM_INIT_NOW   // Init EEPROM on first boot after a new build.
#define HOST_KEEPALIVE_FEATURE        // Disable this if your host doesn't like keepalive messages
#define DEFAULT_KEEPALIVE_INTERVAL 2  // Number of seconds between "busy" messages. Set with M113.
#define BUSY_WHILE_HEATING            // Some hosts require "busy" messages even during heating
#define PREHEAT_1_LABEL       "PLA"
#define PREHEAT_1_TEMP_HOTEND 200
#define PREHEAT_1_TEMP_BED     50
#define PREHEAT_1_TEMP_CHAMBER 35
#define PREHEAT_1_FAN_SPEED     0 // Value from 0 to 255
#define PREHEAT_2_LABEL       "ABS"
#define PREHEAT_2_TEMP_HOTEND 240
#define PREHEAT_2_TEMP_BED     80
#define PREHEAT_2_TEMP_CHAMBER 35
#define PREHEAT_2_FAN_SPEED     0 // Value from 0 to 255
#define PREHEAT_3_LABEL       "PETG"
#define PREHEAT_3_TEMP_HOTEND 220
#define PREHEAT_3_TEMP_BED     60
#define PREHEAT_3_TEMP_CHAMBER 35
#define PREHEAT_3_FAN_SPEED     0 // Value from 0 to 255
#define PREHEAT_4_LABEL       "TPU"
#define PREHEAT_4_TEMP_HOTEND 200
#define PREHEAT_4_TEMP_BED     50
#define PREHEAT_4_TEMP_CHAMBER 35
#define PREHEAT_4_FAN_SPEED     0 // Value from 0 to 255
#define NOZZLE_PARK_FEATURE
  #define NOZZLE_PARK_POINT { (X_MIN_POS + 10), (Y_MAX_POS - 10), 20 }
  #define NOZZLE_PARK_MOVE          0   // Park motion: 0 = XY Move, 1 = X Only, 2 = Y Only, 3 = X before Y, 4 = Y before X
  #define NOZZLE_PARK_Z_RAISE_MIN   2   // (mm) Always raise Z by at least this distance
  #define NOZZLE_PARK_XY_FEEDRATE 100   // (mm/s) X and Y axes feedrate (also used for delta Z axis)
  #define NOZZLE_PARK_Z_FEEDRATE    5   // (mm/s) Z axis feedrate (not used for delta printers)
  #define NOZZLE_PARK_E_FEEDRATE    30
#define PRINTJOB_TIMER_AUTOSTART
#define LCD_LANGUAGE en
#define DISPLAY_CHARSET_HD44780 JAPANESE
#define LCD_INFO_SCREEN_STYLE 0
#define SDSUPPORT
#define DGUS_LCD_UI_MKS
  #define USE_MKS_GREEN_UI
#define FAN_SOFT_PWM
#define SOFT_PWM_SCALE 0
#define SERVO_DELAY { 300 }
