elegooofficial/neptune3pro/Firmware/Mainboard/Marlin-2.1.1_TJC_029/Marlin-2.1.1_TJC_029/Marlin/Configuration_adv.h

#define E1_AUTO_FAN_PIN -1
#define E2_AUTO_FAN_PIN -1
#define E3_AUTO_FAN_PIN -1
#define E4_AUTO_FAN_PIN -1
#define E5_AUTO_FAN_PIN -1
#define E6_AUTO_FAN_PIN -1
#define E7_AUTO_FAN_PIN -1
#define CHAMBER_AUTO_FAN_PIN -1
#define COOLER_AUTO_FAN_PIN -1
#define HOMING_BUMP_MM      { 5, 5, 2 }       // (linear=mm, rotational=°) Backoff from endstops after first bump
#define HOMING_BUMP_DIVISOR { 2, 2, 4 }       // Re-Bump Speed Divisor (Divides the Homing Feedrate)
#define MICROSTEP_MODES { 16, 16, 16, 16, 16, 16 } // [1,2,4,8,16]
#define LIN_ADVANCE
  #define LIN_ADVANCE_K 0.00    // Unit: mm compression per 1mm/s extruder speed
#define ADVANCED_PAUSE_FEATURE
  #define ADVANCED_PAUSE_PURGE_FEEDRATE        3  // (mm/s) Extrude feedrate (after loading). Should be slower than load feedrate.
  #define ADVANCED_PAUSE_PURGE_LENGTH         50  // (mm) Length to extrude after loading.
  #define ADVANCED_PAUSE_RESUME_PRIME          0  // (mm) Extra distance to prime nozzle after returning from park.
